nanashima4268/otr-4ts3-u1/hw/README.md

# hw

KiCad project for the OTR-4TS3-U1 board (4-layer, JLC04161H-7628 stackup). License: CERN-OHL-S-2.0 (see ../LICENSES).
See ../docs/architecture.md.

## Generated design (D-51)

The schematic is generated, not drawn: `hw/gen/design.py` describes the circuit in Python, and `hw/gen/schgen.py` writes `hw/kicad/*.kicad_sch`. Every pin connects through a global label at its end point, so the netlist is exactly the description.

```sh
python3 hw/gen/symbols.py   # project symbols -> hw/lib/otr.kicad_sym (FX3 from the datasheet ball map)
python3 hw/gen/design.py    # schematic + verification
```

Verification:
- The netlist that KiCad exports (`kicad-cli sch export netlist`) must equal the description.
- Every pin of every symbol must be assigned (`NC` for unused pins).
- Pins that the library draws stacked must share a net.
- Library no-connect pins must be `NC`.
- ERC runs (`kicad-cli sch erc`).

Phase 1 covers everything except the Sony receiver core. The receiver core waits for the reference-board measurement and the photo survey, because the CXD2856ER/CXD2858ER pinouts are not public.

Status (2026-11-01):
- Sheets done:
  - FX3
  - FPGA (also generates `fpga/syn/otr_top.pcf`)
  - Power: PCIe/DC 12 V OR, TPS54302 3.3 V, LDOs, `+VIO_TS` selection
  - USB: Type-C via HD3SS3220, or the internal header
  - Control: TCA9546A, LNA bypass inverter
  - RF front end: F jacks, LNA with bypass, 4-way splitters
- The netlist equals the description, and ERC reports 0 errors.
- The 32 remaining ERC warnings are labels for the receiver interface: TS*, RF_T*/RF_S*, CH*_PWR_EN/RST_N. They wait for the receiver sheet (Sony parts, after the measurement).
- Project symbols and footprints are generated by `hw/gen/symbols.py`:
  - CYUSB3014 from the ball map
  - HD3SS3220
  - The DS803FPR0016 F-jack footprint from the maker's recommended layout
