nanashima4268/otr-4ts3-u1/docs/decisions.md

# 決定事項ログ

初期ヒアリング（2026-11-01）で確定した方針。変更時はこのファイルに追記し、理由を残す。

| # | 項目 | 決定 | 備考 |
|---|---|---|---|
| D-01 | 目的 | 自分用の録画環境が主。頒布・販売にも耐える設計にする | 線引きは research.md §9 |
| D-02 | BS4K の目標 | ISDB-S3 の復調と TLV 出力まで。ACAS による復号は対象外 | |
| D-03 | 設計者の経験 | RF・高速回路はほぼ初めて | 設計の余裕と、デバッグしやすさを優先する |
| D-04 | 復調・チューナー IC | Sony 製をブローカーから調達（CXD2856ER / CXD2858ER） | 偽物や再刻印品を前提に、受入検査をする |
| D-05 | S3 用チップ | v1 では調達しない。ジャンクの 4K 機器から取り外して入手する | CXD2856ER と CXD2857ER の載せ替えを前提に基板パターンを作る（ピン互換は未検証） |
| D-06 | 系統数 | 4 系統。最初から 4 系統の基板を作る | 1 系統の評価基板は作らない。代わりに系統ごとに切り離せる設計にする（R-03） |
| D-07 | ホスト接続 | **改訂（2026-11-01）**：iCE40HX4K-TQ144 ＋ FX3（CYUSB3014）。当初は iCE40HX8K（TQ144）＋ FT601 だった | 改訂の理由は 3 つ。HX8K には TQ144 版がない（HX4K-TQ144 の中身は HX8K と同じダイ）。FT601 はドライバのソースが非公開で、GPL での公開（D-19）と衝突する。BGA は JLCPCB の実装で問題にならない |
| D-08 | 形状と電源 | PCIe ロープロファイル形状と外付け箱の両方に対応 | PCIe は電源だけを使う（補助電源なし、10W 以内）。箱では基板上の DC 入力端子に 12V を入れる（D-30） |
| D-09 | USB コネクタ | ブラケット側の USB-C とマザーボード内部の USB3 ヘッダの両方。どちらか一方を実装する | SuperSpeed 線は分岐させず、0Ω 抵抗で選ぶ |
| D-10 | ソフトウェア | **改訂（2026-11-01）**：Linux、Windows、macOS。Linux を先に作る。実装の土台は D-40 | libusb 系のユーザー空間ドライバ。recpt1 互換、その後 BonDriver。FX3 と libusb の構成なので macOS にも対応できる |
| D-11 | 実装 | JLCPCB の部品実装サービスを使い、Sony IC は支給または後付け | |
| D-12 | 予算と測定 | 5 万円程度。測定器は SDR（RTL-SDR）で代用 | 復調 IC が出す C/N・BER・信号強度も測定に使う |
| D-13 | B-CAS カードリーダー | 基板パターンだけ用意し、部品は実装しない | 復号機能は基板にもドライバにも持たせない |
| D-14 | アンテナ入力 | 地上用と衛星用の 2 端子（F 型） | |
| D-15 | アンテナ給電（**D-54 で改訂：v1 では外す**） | LNB への 15V 給電回路はパターンだけ用意し、部品は実装しない | |
| D-16 | 受信帯域 | 地デジ、BS/110 度 CS（右旋）、CATV（パススルーと ISDB-C）。左旋は RF 経路だけ確保 | |
| D-17 | LNA（受信アンプ） | バイパスできる LNA を載せる | |
| D-18 | CAD | KiCad を使い、JLCPCB 向けプラグインで出力する | |
| D-19 | 公開 | オープンハードウェアとして公開。基板は CERN-OHL-S-2.0、ホスト側と FPGA は GPL-2.0-only、FX3 ファームは MIT（D-29） | px4_drv と tbs6812_drv が GPL-2.0-only なのに合わせる |
| D-20 | 品番 | OTR-4TS3-U1 | Open Tuner Receiver／4 系統／地上・衛星（S3 対応）／USB／第 1 版 |
| D-21 | Sony IC の調達 | 少量をブローカーから買い、検収してから追加購入する | 検収では I²C でチップ ID を読み、参照ボードと同じように動くかを確かめる |
| D-22 | 実測の道具 | テスターと接写撮影 | 手順は measurement-procedure.md |
| D-23 | 設計前の準備 | ブロック図と電力見積もり、実測手順書、部品候補表、先行検証計画を作る | architecture.md ／ measurement-procedure.md ／ bom-candidates.md ／ preverification-plan.md |
| D-24 | I²C の構成 | FX3 の I²C から TCA9546A で 4 本に分け、復調 IC はすべて 0x64 にする | アドレス設定のミスをなくし、系統ごとに切り離せるようにする（D-06 への対策） |
| D-25 | FPGA の設定 | FX3 が起動時に SPI で FPGA に設定データを書き込む。フラッシュはパターンのみ | 開発中の書き換えが速い |
| D-26 | RF 前段 | SGL0622Z（LNA）、AS179 によるバイパス、抵抗による 4 分配。地上用と衛星用で 1 組ずつ | 直流から 3.2GHz まで平坦で、特殊な部品がいらない |
| D-27 | 検証用の PC | PCIe スロット付きの Linux 機と Windows 機の両方がある | 段階 S0（参照ボードで基準データを取る）は Linux から始める |
| D-28 | 購入 | 今買うのは PCIe 延長ライザー（約 1,000 円）だけ。評価ボードと Sony IC のサンプルは保留 | 段階 S1・S3・S4 は評価ボードを買うまで保留。R-11 を参照 |
| D-29 | FX3 ファームのライセンス | ソースを MIT で公開する。バイナリは各自が FX3 SDK でビルドするか、Cypress の規約に従って配る | SDK のライブラリはソース非公開で、バイナリ配布に Cypress の利用規約がかかるため、GPL にできない |
| D-30 | PCIe での電源とブラケット | PCIe で使うときは LNB 給電をせず、補助電源もつけない（10W 以内）。ブラケットには F 型 ×2 と USB-C を並べる。DC 入力は基板上の端子にし、箱で使うときだけ使う | LNB 給電の回路（DNP）は箱で使うときだけ有効にする。ファームは DC 入力を検出できないときに LNB を有効にしない |
| D-31 | USB の VID/PID | 開発中は pid.codes のテスト用 ID（1209:0001）を使う。公開リポジトリができたら正式な PID を申請する | |
| D-32 | 公開 | GitHub の nanashima4268/otr-4ts3-u1 で今すぐ公開する。コミットのメールアドレスは GitHub の noreply にする | |
| D-33 | 開発環境 | Mac に oss-cad-suite（FPGA ツール）、cocotb、KiCad を入れる。FX3 は Docker でビルドする（SDK は Infineon から手動で取得） | 状況（2026-11-01）：oss-cad-suite と cocotb は導入済み。Docker イメージ otr-fx3 は作成済み。KiCad は sudo が必要なので未導入。FX3 SDK は未取得 |
| D-34 | TS 配線 | v1 は CXD2856ER のシリアル TS（4 本）だけを FPGA に配線する | パラレルと 2 ビットパラレルのピンは、参照ボードで使われていないので導通測定で特定できない。S3（TLV）の高いレートを扱う方法は v2 で検討する |
| D-35 | 実測の段取り | 本番の pve-old を近いうちに止め、録画用のカードそのものを実測する | 止めるとホームラボ全体が止まり、SMART が FAILED の NVMe で再起動に失敗する恐れがある。このリスクは承知のうえで決めた。段取りは measurement-procedure.md §0-1 |
| D-36 | S0 の実施 | 2026-11-01 に完了した（docs/reference/s0-baseline.md） | 未復号の TS はチューナー #4 で recisdb を直接実行して取った。ファイルはローカルの ~/otr-data のみに置く |
| D-37 | FX3 ファームの作り方 | SDK のサンプルはコピーしない。起動コードと cyfxtx.c はビルド時に SDK から参照する。GPIF の設定は自前の GPIF II Designer プロジェクト（Windows 機で作る）から生成したものだけをコミットする | SDK のサンプルにも Cypress の「UNPUBLISHED, LICENSED SOFTWARE」表示がある。bladeRF（MIT）と同じやり方にする |
| D-38 | FPGA の出力形式とクロック | 1 パケット（188 バイト）ずつ丸ごと転送する。px4_drv と同じく、sync バイトを系統番号入りのタグ（0x17〜0x47）に書き換える。システムクロックは 85MHz 以下（GPIF は 16 ビット・50MHz 程度で足りる） | S2 で検証済み（fpga/README.md） |
| D-39 | GPIF のバス幅とクロック | GPIF は 16 ビット幅にする。FPGA と GPIF のクロック（PCLK）は、基板上の 50MHz 発振器から取る（16 ビット×50MHz＝100MB/s） | 32 ビット幅にすると FX3 の SPI ブロックが使えなくなり（FX3 Programmer's Manual 7.3.4.3）、D-25 の FPGA 書き込みとぶつかる。必要な帯域は最大約 50MB/s（S3×4）なので、16 ビットで足りる |
| D-40 | ホスト側の実装 | **改訂（D-44）**：px4-userland（Khronos31、C++、GPLv2）の兄弟製品として作る。D-10 で決めた「Rust」は取り消す | px4-userland は、ユーザー空間で動く常駐プロセス（px4d）とクライアント（px4-ts、px4ctl）の構成で、CXD2856ER と CXD2858ER の制御がすでにある。4 つの OS で動く。カーネルドライバは不要 |
| D-41 | GPIF II Designer | ユーザーが Windows 機で操作する。私は画面ごとの手順書を用意する | |
| D-42 | px4-userland の実機確認 | 2026-11-01 に DTV02A-4TS-P で実施し、成功した（docs/reference/px4-userland-dtv02a-4ts-p.md） | |
| D-43 | FX3 への書き込みの流量制御 | FPGA がワード数を数え、DMA バッファ 1 つ分（8192 ワード＝16KiB）をちょうど満杯まで書く。書き終えたらフラグの遅延分だけ待ち、FLAGA で次のバッファが空いたのを確かめて再開する。FLAGB（部分フラグ）と PKTEND# は使わない | FX3 は満杯のバッファしか USB に送らない。部分フラグで止めると満杯にならず、行き詰まることをシミュレーションで確認した（fpga/README.md） |
| D-44 | ホスト側の製品の形 | 兄弟製品 otr-userland を別リポジトリ（github.com/nanashima4268/otr-userland）として作る。dtv-userland-core と px4-userland は版を固定して参照し、CXD 系の制御コードとタグ付き TS の振り分けを流用する。otr-ts は共通の `*-ts` CLI 仕様に合わせる | px4-userland は仕様で対応機種以外の実装を入れないと定めているので、本体には足せない。siano-userland と同じ作り方にする。設計は otr-userland/docs/design.md |
| D-45 | 上流の作者への連絡 | 実機（v1 基板）が動いてから連絡する | それまでは版を固定して参照するだけにする |
| D-46 | FX3 ファームの起動方法（**D-49 で改訂**） | ふだんは基板上の I²C EEPROM（24LC256）から起動する。開発中や最初の書き込みでは USB 起動も使う。otrctl に、ファームを RAM に送る機能（0xA0）と EEPROM に書き込む機能を持たせる | 一度書き込めば、挿すだけで自分たちの ID（1209:0001）で認識される。ファームのバイナリは各自がビルドする（D-29） |
| D-47 | FPGA の制御レジスタ | FX3 の SPI（設定と同じ 4 本のピン）で読み書きする。1 回の転送は「命令 1 バイト＋データ 4 バイト（上位から）」、命令はアドレス（書き込み）か 0x80｜アドレス（読み出し）。設定は 20MHz、レジスタは 4MHz で行う。FPGA は SCK を 50MHz のシステムクロックでサンプリングする。系統はリセット後すべて無効で、ホストが CH_ENABLE で有効にする | レジスタの読み書きは稀なので速さはいらない。サンプリング方式なら SCK をクロックとして使わずに済み、クロック領域が増えない。シミュレーションで 8.3MHz まで動作を確認（fpga/README.md）。レジスタ表は otr-userland docs/design.md §5 |
| D-48 | GPIF II の設定の取り込み | ユーザーが作った GPIF II Designer プロジェクト（Cypress の雛形 sync_slave_fifo_2bit を複製し、FLAGA を thread 0 DMA ready に変更）から生成したヘッダを、ファームで使う。公開リポジトリの fx3/gpif/ には、ヘッダとプロジェクト本体（.cyfx、projectfiles/*.xml）を入れる。documentation/（Cypress が書いた資料）と build.log（個人のパスを含む）は入れない | 状態遷移は SDK の 16 ビット例と同じで、違うのはフラグのピン設定だけ（fx3/gpif/README.md）。プロジェクトがあれば GPIF II Designer でヘッダを作り直せる（bladeRF と同じ扱い）。ファームはこのヘッダでビルドできることを確認済み |
| D-49 | 起動用メモリ | I²C EEPROM（D-46）をやめ、SPI フラッシュ W25Q32JV（4MB、JLC C179173、拡張部品。C82344 は在庫切れ）から起動する。PMODE は「SPI、失敗したら USB 起動」。フラッシュは FX3 の SSN、FPGA の SS_B は別の GPIO（暫定で 50）につなぐ。CRESET_B はプルダウンし、FPGA の MISO は自分の SS が Low のときだけ出力する。配置は 0x000000 が FX3 イメージ、0x100000 が FPGA 領域（256 バイトのヘッダ「OTRB」＋長さ、続けてビットストリーム）。FX3 は起動時にビットストリームを RAM に読み、途切れなく FPGA に書き込む（ホストからの FPGA_LOAD も残す）。シリアル番号は、フラッシュの 64 ビット固有 ID にする。ベンダーリクエストの 0xB7/0xB8 はフラッシュの書き込みと読み出しに変え、0xB9（消去）と 0xBA（状態）を加える | ファームは最適化しても 114KB あり、24LC256（32KB）に入らない。フラッシュなら容量に余裕があり、FPGA の自動起動と固有 ID によるシリアル番号も同時にまかなえる（bladeRF と同じ構成）。FX3 の SPI 起動は 03h 読み出しと 3 バイトのアドレスを使い、32Mbit は対応範囲に入る。iCE40 は設定データを途中で止めずに送る必要があり、バスを共有しているので、いったん RAM に読む。HX8K のビットストリーム（135KB）は DMA バッファ領域（224KB）に入り、USB を始める前に読んで解放する。ユーザーが 2026-11-01 に選んだ |
| D-50 | ストリームの停止と再開 | PKTEND は使わない。FPGA に経路リセット（CTRL 0x0A の bit0）を設ける。otrd は、開始時に「経路リセット → STREAM 1 → CH_ENABLE」、停止時に「CH_ENABLE=0 → STREAM 0」の順で操作する。無効になった系統の残りのパケットは、mux が読み出して捨てる | 停止すると FX3 は書きかけのバッファを捨てるが、FPGA は書いたワード数を数え続けるので、再開後にバッファの区切りがずれる（シミュレーションで、ずれと 83 回の取りこぼしを再現した）。PKTEND で書きかけのバッファを確定させる方法は、FX3 の挙動が TRM だけでは確定できず、FPGA も複雑になるので見送った。代わりに、最後の受信機が止まるときの末尾（16KiB 未満、数 ms）は届かない。fpga/sim/tb_path.v で確認済み |
| D-51 | 回路図と配置配線の分担 | 回路図、配置、配線とも私（Claude）が行う。回路図は KiCad のファイルをスクリプトで作り、配置もスクリプトで行う。配線は自動配線（Freerouting）と手直し。ユーザーは節目ごと（配置後・配線後・発注前）に KiCad で開いて確認する | 推奨は「配置配線はユーザー」だったが、ユーザーの判断で変えた。RF と USB3 の品質は保証できないので、私は画像の書き出し（kicad-cli）と DRC で自己検証し、ユーザーの目視確認を節目に入れる（2026-11-01） |
| D-52 | 基板の大きさと実装面 | ロープロファイル（高さ 68.9mm 以下）、長さは 120mm を目標とする。収まらないときや配線の品質が落ちるときは、相談のうえ最大 168mm まで延ばす。部品は表面だけに載せ、収まらなければ相談する | 長さは好みで、ケースの制限ではない（2026-11-01） |
| D-53 | 層数 | 4 層（JLC04161H-7628）。FX3 の BGA はドッグボーン（パッドの斜め脇にビアを置く方式）で引き出す | 推奨どおり（2026-11-01）。D-75 で 6 層に改めた |
| D-54 | 部品を載せないパターンの整理 | 残すのは、内部 USB3 ヘッダ（D-09）、B-CAS スロット（D-13、DNP）、DC 入力端子（D-30）。LNB 給電回路（D-15）と FPGA 専用フラッシュのパターン（D-49 で不要）は v1 から外す | 120mm に収めるため（2026-11-01） |
| D-55 | FPGA の在庫 | 先行購入せず、発注時に確保する。在庫切れの危険（R-10）は受け入れる | 2026-11-01 |
| D-56 | USB-C の SuperSpeed の向き | HD3SS3220（UFP 設定、GPIO モード）で、向きの判定と USB3 レーンの切り替えをする。TX の結合コンデンサはスイッチとコネクタの間に置く（TI の UFP 例に従う）。コネクタは Molex 105450-0101（USB 3.2、24 ピン、JLC C134092）。内部 USB3 ヘッダは、FX3 側の 0Ω で選ぶ（既定は USB-C、ヘッダは DNP） | FX3 は SuperSpeed を 1 組しか持たず、そのままでは片方の向きでしか USB3 にならない。USB3 の Micro-B と Type-B は JLC に在庫がない。推奨どおり（2026-11-01） |
| D-57 | F 型コネクタ | DOSIN DS803FPR0016（75Ω、DC〜3GHz、直角、THT、JLC C2979612）。フットプリントは、メーカーの推奨ランドから生成器で作る | 3GHz 定格は左旋の上端（3.224GHz）をわずかに下回るが、左旋は経路の確保だけ（D-16）。ブラケットとの位置は、配置後の確認（D-51）で見る（R-09 を一部解消） |
| D-58 | 電源の構成 | PCIe の 12V と DC 入力を SS34 で OR し、TPS54302（3A）で +3V3 を作る（100k/22k で 3.31V、6.8µH）。スロットの 3.3V で +3V3 をまかなう経路も DNP で残す。LDO は +1V2（FX3）、+1V2_FPGA、+1V8 の 3 個（TLV755xx）。+VIO_TS は 3.3V（1.8V は 0Ω で選べる）。受信部の電源は、実測後に受信部のシートで決める | 3A あれば、Sony IC を 3.3V から LDO で給電しても足りる見込み（電力の見積もりは実測で更新する） |
| D-59 | RF 前段の部品 | LNA は SGL0622Z。バイパスは HXAS179-92LF（AS179 の互換品。元の品は在庫なし）を 2 個と 74LVC1G04 で行い、LNA_BYPASS が 0 のとき LNA を通す。チョークは、地上が 1µH＋フェライトビーズ、衛星が 12nH＋フェライトビーズ（データシートの 68nH は 850MHz 用で、帯域に足りない）。DC カットは地上 1nF・衛星 100pF。分配は 45.3Ω の星形 4 分配 | 定数は、実機で通過特性を見て調整する前提 |
| D-60 | GPIF のクロック | 50MHz 発振器 1 個で、FPGA（GBIN）と FX3 の PCLK を、それぞれ直列抵抗を通して駆動する。FPGA はクロックを転送しない | FPGA の最上位にクロック出力がなかった。転送するとスキューの管理が要る。1 個の発振器で配るほうが単純 |
| D-61 | ブラケット | 市販の無地のロープロファイル用ブラケットを買い、ユーザーが穴を開ける。穴の位置の図は私が作る | 推奨は板金の外注だった。USB-C の角穴の加工が難しいことは承知のうえ（2026-11-01） |
| D-62 | ブラケットの端子の並び | マザーボードから遠い側から、衛星（ANT-S）、地上（ANT-T）、USB-C。端子はすべて部品面（PCIe の B 列の面）に載せる | F 型の順は参照ボードと同じ。USB-C を端子側に置き、FX3 までを短くする（2026-11-01） |
| D-63 | B-CAS スロット（D-13 の具体化） | フルサイズのカード用のパターンを裏面に置く（DNP）。部品は v1 では選ばず、外形だけ確保する | 組み立てる部品は表面だけなので、JLC は片面（Economic）のままで費用は増えない。カードを差すと PCIe 規格の裏面の高さ（2.67mm）を超える（参照ボードも同じ）。両面に部品を組み立てると、1 回の発注で約 $45 増える（2026-11-01） |
| D-64 | 外形の寸法 | PCIe CEM のロープロファイル。基準は、CEM 仕様から作られ製造実績のある KiCad の雛形（ULX4M-PCIe-IO）：端子の下端から上辺まで 68.9mm、肩 12.75mm、ブラケット側の端は B1 の端子から 45.15mm、ねじ穴 2 つ（GND、M3）。配置と外形は hw/gen/layout.py と pcbgen.py から生成する | 肩の高さは資料により 8.4〜12.75mm と幅があるので、安全側を取る。参照ボードの実測（measurement-procedure.md §2-5）で見直す |
| D-65 | 外部チューナーへの RF 出力（research.md §6） | 作らない | 面積を優先する。RF 前段の切り分けは、LNA のバイパスと系統ごとの切り離しで行う。推奨は U.FL（DNP）だった（2026-11-02） |
| D-66 | シールド（R-08） | 受信部の周りに、レジストを剥いた GND の帯とビアの壁だけを用意する。部品は載せない | 必要になったら、自作のケースや銅テープをはんだ付けできる。受信部を描くときに入れる（2026-11-02） |
| D-67 | 立ち上げ用の観測点（R-11） | FX3 と FPGA の間（PCLK、SLCS#、SLWR#、FLAGA、FLAGB、DQ0）と FPGA の設定状態（CDONE、CRESET_B）にテストパッド、プローブ用の GND パッド 2 個。TCA9546A の上流に I²C ヘッダ J7（DNP） | 評価ボードを買わないので、v1 基板で初めて FX3 と FPGA を動かす。I²C ヘッダは受け入れ検査（D-21）でチップ ID を読むのにも使う。既存の部品番号を動かさないよう、全シートの後に追加している（design.py の bringup_additions） |
| D-68 | CLAUDE.md | リポジトリの追跡から外し、手元にだけ置く。hw/view/（ビューアの生成）はリポジトリに残す | 個人のアーティファクトの URL を含むため（2026-11-02）。ローカルの Tailscale 向けビューアは ~/otr-data/work/scripts/localview.sh で作る |
| D-69 | 配線の寸法とルール | 表層（第 2 層の GND が基準）で、RF 75Ω は線幅 0.145mm、USB の差動 90Ω は線幅 0.263mm・間隔 0.15mm。電源は 0.5mm、それ以外は 0.15mm／0.15mm。ビアは 0.45mm／穴 0.25mm（JLC で追加料金のかからない最小）。JLC の製造限界を設計ルールにし、ネットクラスと合わせて hw/gen/rules.py から生成する | 寸法は、JLC04161H-7628 の断面（プリプレグ 0.2104mm・εr 4.4、銅箔 35µm、ソルダーレジスト εr 3.8）を 2 次元の電界計算で解いた値。検算として 50Ω は 0.355mm になり、銅厚とレジストを入れない近似式（0.405mm）より細くなる向きと合う。RF の線は、地のパターンをカスタムルールで 0.45mm 離してマイクロストリップとして扱う（2026-11-02） |
| D-70 | USB の高速線の配線 | USB-C の奥の列（B 列）は、2 列のすき間に細いビア（直径 0.3mm・穴 0.15mm、JLC の追加料金あり、約 $16／発注の記載だが見積もりで確定）で裏面へ下ろす。上の層に TX1・RX2、裏面に RX1・TX2 を通し、ホスト側は TX を上、RX を裏面にして交差を避ける。TX1 は受け口で + と − を入れ替える（USB 3 の受信側は極性の反転を自動で直すことが規格で必須）。D+/D− は入れ替えず、ブラケット脇を回して FX3 へ引く（A7 と B7 の接続だけ In2 の短い配線）。ヘッダ用の 0Ω（DNP）は、使う側の 0Ω と FX3 側のパッドを共有させて重ね、分岐を 0 にする。対内の長さの差は、RX1 に蛇行を入れて 0.1mm 以内（ホスト側 RX だけ合計約 1mm）。切り替え IC（HD3SS3220）は 180° 回した | Molex の部品指定で、受け口の前面は上の層に配線もビアも置けない。2 列の間は 0.6mm しかなく、無料の寸法のビアは入らない。ユーザーが細いビアを選んだ（2026-11-02）。TI の配線指針（SLLSES1E §9）に従う。usb.py に座標で記述し、DRC で確かめている |
| D-71 | FX3 の BGA の引き出しと電源層 | FX3 は、ボールの斜め脇に無料の寸法のビア（0.45mm／0.25mm）を置き、中心から外向きに引き出す。外周の信号ボールは上の層からそのまま出す。+1V2 のボールのビアは内向きにする。水晶は、XTALOUT をビアなしで上の層に通し、XTALIN だけビア 2 個で裏面を通す（Y1 は 180° で固定）。層は、In1 を全面 GND にし、SuperSpeed の AC 結合コンデンサの直下だけ抜く。In2 は GND を土台にして、FX3〜FPGA と制御部を +3V3、FX3 の BGA の下を +1V2 の島、FPGA の本体の下を +1V2_FPGA の島にする。USB の裏面の配線の下（x < 82.6mm）、RF、電源部、受信部の帯は GND のまま残す。BGA の下に限って、面とビアのクリアランスを 0.12mm、+1V2 の島の最小幅を 0.1mm にし、ビアの間にも銅が残るようにする。1.2V の LDO（U5、U6）は、入出力のコンデンサごと負荷の隣に移す。面につなぐ部品のパッドには、その面がある位置に限って脇にビアを置く。露出パッドには中にビアを置く。fanout.py と planes.py で生成し、面は kicad-cli で塗る | Cypress AN70707 §12.1 に従う：電源の種類ごとに電源層を区切る、USB の線の下の GND を切らない、AC 結合コンデンサの直下は 1 層抜く、電源の線を短くする、水晶の線にはビアを推奨しない。XTALIN と XTALOUT を両方ビアなしで北へ出すと、列 C の両脇の通り道がふさがり、C8（R_USB2）と C10 が引き出せなくなるので、片方だけビアを使う（追加の容量は 1pF 程度で、負荷容量より十分小さい）。LDO は電源部に置くと負荷まで約 45mm あり、In2 の 1.2V の通り道が互いに交差する。DRC でクリアランス違反なし（2026-11-02） |
| D-72 | 製造データと JLC の条件（B-7） | 製造データは hw/gen/fab.py で出す：ガーバー（Protel の拡張子、シルクからレジストを抜く）、Excellon（mm、絶対座標）、BOM（Comment／Designator／Footprint／LCSC Part #）、CPL（Designator／Mid X／Mid Y／Layer／Rotation）。出力先は ~/otr-data/work/fab/<コミット>/。テストパッド、ねじ穴、はんだジャンパー、PCIe の端子は部品ではないので外す。基板は ENIG（1U"）、PCIe の端子は金、30° の面取り、積層は JLC04161H-7628 を指定、ビアは JLC の 4 層の既定どおり穴を埋める（Plugged、Tented は選べない）。標準のビアは穴 0.3mm／直径 0.45mm にする（D-69 の 0.25mm は誤りで、追加料金の区分だった） | 2026-11-02 に JLC の見積もり画面で確認（基板 5 枚、ログインなし）。基準の額は $47.60（エンジニアリング料 $25、ENIG $17.50、基板 $5.10）。金の端子・面取り・積層の指定・穴埋めは $0。ビアの穴を 0.25／0.2mm にすると約 +$38、0.15mm（D-70 の細いビア）にすると約 +$56（ビア $35.13、自動で付く 4 線式の導通検査 $17.09、TG155 の基材 $3.51）。面取りは深さ 1.13mm で、端子は先端から 1.3mm 以上離れている。組み立てを付けると Standard に固定され、捨て板 5mm が両端に付く。ユーザーの選択：ENIG＋金の端子＋30°、穴埋め、見積もりは私が Chrome で、基板 5 枚・組み立て 2 枚 |
| D-73 | USB-C の部品（D-56・D-70 の改訂） | Molex 105450-0101 をやめ、Same Sky UJ32-C-H-G-H2-SMT-TR（USB 3.2 Gen 2x2、JLC C22359755、拡張部品、約 $2.94）にする。A 列は表面実装で奥、B 列は挿入実装で手前に 2 段の千鳥（後ろの段は 0.70mm 奥）。フットプリントはデータシート（2023-11-13、1.6mm 基板用）の推奨パターンから生成し（symbols.py）、B 列の穴にもペーストを置く（ピンを差してリフロー）。前面は手前の段から 7.75mm 前で、カードの端から 0.8mm 出す（ブラケットの内面は 1.03mm）。A 列の TX1・RX2 は上の層、B 列の RX1・TX2 は穴から裏面へ出て後ろの段のすき間を通し、切り替え IC の近くで無料の寸法のビアで上がる。細いビア（0.15mm）はなくなった。TX2 も受け口で + と − を入れ替える。D+/D− は A6–B6 を上の層、A7–B7 を裏面で結ぶ。対内の長さの差は TX2 0.11mm、RX1 0.25mm、D± 0.07mm | 細いビアは JLC の見積もりで約 $56／回（D-72）。この部品は 1.6mm 基板を明記した数少ない挿入実装の USB-C で、JLC に在庫がある（2026-11-02 に 250）。B 列の穴はメーカーのパターンで、穴の間が 0.40mm（ルールは 0.45mm）なので J3 だけ例外にし、発注のときに JLC に確かめる。挿入ピンの分岐は 19〜23GHz で共振する見積もりで、Gen 1（2.5GHz）には影響しない。候補の比較は ~/otr-data/work/docs/usbc-dip-candidates.md。ユーザーが 2026-11-02 に選んだ |
| D-74 | 一般配線（Freerouting） | 受信部以外の一般の信号線と電源の線は Freerouting 2.5.0 で自動配線する（hw/gen/autoroute.py）。jar はリポジトリに入れず ~/otr-data/work/tools/ に置き、利用統計は -da で止める。流れは、pcbgen の基板（USB・BGA の引き出し・面のビアはスクリプトで固定）を DSN に書き出し、DSN を直して Freerouting に渡し、結果の SES を hw/kicad/otr-4ts3-u1.ses としてコミットする。pcbgen は SES のうち既存の線と重ならず、配線対象の網（.routed）の線だけを足す（KiCad の SES 読み込みは既存の線を全部消すので使わない）。DSN の直し：信号は表と裏だけ（In1・In2 は面のまま）。面の定義を外し、面の網（GND・+3V3・+1V2・+1V2_FPGA）は配線しない。RF（75Ω）と USB（90Ω の差動）も配線しない。信号線は幅 0.1mm・間隔 0.1mm（BGA の引き出しのビアのすき間は 0.35mm で、0.15mm の線は通れない）、電源線は 0.3mm。KiCad のネットクラス（Default・GPIF・POWER）も同じ値にした。ビアは配線ツールには直径 0.55mm として見せ、穴から銅まで 0.2mm を保つ（BGA の下の引き出しのビアは実寸）。受信部の帯は配線禁止、カードの端から 0.3mm、USB-C の位置決め穴から 0.2mm を空ける。細くされた線は 0.09mm（JLC の最小）まで太らせる | ユーザーの判断で「今、受信部以外を配線する（推奨）」、jar の導入も了承（2026-11-02）。BGA の下だけは穴から線まで 0.17mm を許す（中央を通る 0.1mm の線でちょうど 0.2mm、配線ツールは最大 0.025mm ずれる）。発注時に JLC の DFM で確かめる。未配線は、BGA の内側から出る GPIF など約 25 本と、面の網の未接続（面の島の外の部品、ビアの置き場がないパッド）、RF、USB ヘッダの線。受信部の回路が入ったら配線し直す（2026-11-02） |
| D-75 | 6 層にする（D-53 の改訂）と FX3 の BGA の引き出し | 積層は JLC06161H-7628（1.6mm）。層の役割は、L1 信号／L2（In1）GND／L3（In2）内側の信号／L4（In3）電源（GND を地にして +3V3・+1V2・+1V2_FPGA の島）／L5（In4）GND／L6 信号。FX3 の信号ボールは、配線ツールに任せる前にスクリプトで BGA の外まで引き出す（hw/gen/escape.py）。外周のボールは表から、内側のボールはドッグボーンのビアから裏または L3 へ出す。0.05mm の格子の上で最短の道を探し、端から行き先の部品までの直線距離も費用に入れる。引き出しの線どうしの取り合いは、混んだ所の費用を上げながら引き直す方法（PathFinder）で解く。55 本すべてが出た。Freerouting は信号を表・L3・裏の 3 層に引く（L2・L4・L5 は面のまま） | 4 層では、BGA の内側の信号ボール約 10 個を引き出せなかった。無料の 0.45mm ビアを 0.8mm 間隔で並べると、ビアの間には 0.1mm の線が 1 本しか通らない。1 層で出せるのは外側の 2 周ほどだが、FX3 の信号ボールは 4 周目まである。裏面だけで順に引くと 45〜46 本、取り合いの方法でも 41 本までしか出ず、L3 に相当する電源の層を使っても 8 個残った。JLC の見積もり（基板 5 枚、ENIG、金の端子、30° の面取り、2026-11-04）は、4 層 $47.60、6 層 $55.90（+$8.30）、4 層で 0.15mm の細いビアは約 +$56。ユーザーが「6 層にする（推奨）」を選び、積層は信号への影響など電気的な事情を調べたうえで私が決めることになった。積層を選んだ理由：JLC の 1.6mm・6 層の積層 17 種類のうち、外側の層と隣の層の間が 7628 の 0.2104mm（4 層の JLC04161H-7628 と同じ）なのは JLC06161H-7628 だけで、D-69 の線の寸法（RF 75Ω 0.145mm、USB 90Ω 0.263／0.15mm）がそのまま使える。ほかの積層は外側が 0.076〜0.13mm と薄く、75Ω の線が細くなりすぎるか、0.29〜0.51mm と厚く、0.4mm 間隔の USB-C や切り替え IC のパッドに線が乗らない。層の並び：表は L2 の GND、裏は L5 の GND を基準にするので、裏面を通る USB の線の上も GND が続く。L3 の上は L2 の GND（0.4mm）、下は L4（0.2028mm）で、L4 は電源の島以外を GND にしたので、L3 の線もほぼ GND に挟まれる。信号の層を 2 枚並べる案（信号/GND/信号/信号/GND/信号）では、L3 と L4 が 0.2mm で向き合って線どうしが強く結合し、電源も配りにくい。4 層の D-69・D-71 から変えた点：L3 は面を流さない。USB の AC 結合コンデンサの下は、L2 の切り欠きに加えて L3 も配線禁止にする（コンデンサから見えるのは L4 の GND）。結果（D-76 の並べ替えのあと）：信号の未配線は約 25 本から 4 本（FX3_TMS、GPIF_DQ10、GPIF_DQ11、SPI_SCK）と電源の +1V2_FX3U3 になり、DRC の違反はない。未解決：C16.1（BGA の北の 100nF）は、引き出しの線にビアの場所を取られて面につながらない。ほかのビアを置けないパッドと一緒に片付ける。JLC の 6 層の既定のビアの処理は Epoxy Filled & Capped（$0）で、パッドの中にビアを置く設計にもできる（今は使わない）。積層の値は https://jlcpcb.com/impedance の表（2026-11-04 に取得）による |
| D-76 | FPGA の GPIF のピンの並び（D-07 の改訂） | バンク 0 で使う 25 本のピンの組はそのままにして、割り当てだけを並べ替える。FX3 からの引き出しの線が箱を出る順（東の辺を南から北、次に北の辺を東から西）に、FPGA の上の辺のピンを西から東へ割り当て、バスが自分と交差しないようにする（hw/gen/design.py の FPGA_PINS、fpga/syn/otr_top.pcf はそこから生成）。割り当ての後に作り直しても引き出しの順は変わらなかった | 並べ替える前は、GPIF の束が FX3 と FPGA の間で交差し、Freerouting が 11 本を引けずに残した（6 層でも）。FPGA のピンは自由に選べるので、BGA 側の順に合わせるのが定石。GPIF の信号は FPGA 自身の 50MHz（GPIF の PCLK と同じ発振器、D-60）で扱うので、GBIN などの特別なピンは要らない。ピンの組を変えていないので、バンクの電圧（3.3V）も変わらない。iCE40 の配置配線ツールはこの Mac に入っていないので、PCF の確認は FPGA を組むときにする（2026-11-04） |
| D-77 | 自動配線の残りの仕上げ（hw/gen/finish.py） | Freerouting の後に、つながっていない所だけを迷路配線で仕上げる。(1) 信号：自動配線した網のうち、銅が 2 つ以上に分かれているものを、小さい塊から近い塊へ、表・In2・裏の 3 層と 0.45/0.3mm のビアでつなぐ（0.05mm の格子の A*、網のクラスの幅とクリアランス、受信部の帯・基板端・配線禁止域は避ける）。空きで通れないときは、他の信号の線をはがして通し、はがした網をつなぎ直す（引きはがし再配線、仕上げで引いた線ははがさない）。(2) 面：塗りつぶした後の基板で、面に届いていない電源・GND のピンから、面の中に立つビアか、つながっている銅まで引く（ビアは 0.25mm の格子、パッドの上には置かない、穴どうしは 0.25mm 空ける）。面の島どうし（+3V3 の FX3/FPGA 側と制御部側）も最寄りのパッドどうしでつなぐ。面のためにはがした信号がつなぎ直せないときは、その試みをまるごと元に戻す。その後もう一度塗りつぶす | 残りを Freerouting にもう一度走らせると、固定した配線を網の一部と見ずに悪化した（未配線 349）。自動配線の後の残りを、既存の銅を動かさない迷路配線と、局所的な引きはがし再配線で片付けるのは定石。面の網は Freerouting に引かせていない（D-74）ので、面に届かないピン（ビアの場所がないもの、カードエッジの指、USB-C の GND、面のない場所の部品）はこれまで誰も引いていなかった。結果：信号の未配線 0、面の未接続は FB2.1（+1V2）の 1 か所、DRC の違反なし、作り直しても同じファイル（2026-11-05）。障害物の格子は occ.py（整数の配列、図形を列ごとの区間で塗る）で作り、基板の生成は約 8 分から約 3.6 分になった（結果のファイルは同じ）。さらに、BGA の引き出し（escape.py）も同じ格子に載せ、図形ごとの升目を共通の格子で一度だけ求めて使い回し、基板の読み出しを 1 回の接続ごとに 1 度にし、探索の内側を詰め、部品配置の重なり判定を近くの障害物に絞って、約 2.5 分になった（結果のファイルは同じ、2026-11-06）。続いて次を加えた（2026-11-06）。(a) 面に届くビアがないピン（planes.py でパッドの脇にビアの場所がないもの、FX3 の電源ボールで引き出しのビアが自分の面の外に出たもの）は、Freerouting の前に、面の領域に立つビアか同じ網の他のパッドへ迷路配線でつなぐ。Freerouting はそれを避けて配線するので、後から囲まれて孤立することがない。(b) 塗りつぶし後の DRC で規則に反している Freerouting の配線（穴のクリアランスを知らないため）をはがし、仕上げでつなぎ直す。DRC が一度に全部を挙げないので、きれいになるまで最大 3 回繰り返す。(c) 行き先のない銅（ほかの経路で届いた BGA の引き出しの残り、使われないビア）を消す。ビアは触れている物が 1 つ以下のとき、線は浮いた端から、同じ網の銅が触れている最も遠い所まで切り詰める（線の途中に他の線が当たっていても切れない）。(d) 仕上げの試行回数の上限が、つながっている網の確認にも使われていて、名前順で後ろの網が調べられていなかった誤りを直した。(e) planes.py のビアどうしの穴の間隔（0.25mm）を確かめる。FB2 は、+1V2 のボールではなく、自分がつなぐ USB 3 の電源ボールの近くに置く（layout.TARGET_OVERRIDE）。東側に置かれていたときは +1V2 側が面へ出られなかった。はみ出したテストパッドは、隣の領域で 0.2mm 刻みに探す。結果：信号と面の未接続 0（未配線は手で引く RF と HDR の網だけ）、規則の違反なし、行き先のない銅はビア 2 個（線の端がビアの中心から外れていて、消すと切れる）。全部の網を確かめるようになって仕上げのつなぎが増え、生成は約 6 分（Freerouting は別に約 10 分） |
| D-78 | RF 前段の配置と 75Ω の配線（hw/gen/rf.py） | 受信部（4 系統）を除く RF 前段を、信号の流れに沿って表層に一列に並べ、75Ω の線（0.145mm、In1 の GND が基準）を手で決めた形で引く。並びは、F 型コネクタ → ESD（線の上にパッド、GND は真下）→ DC カット → 切り替え IC A →（上：素通しのコンデンサ／下：DC カット → LNA → DC カット）→ 切り替え IC B → DC カット → 45.3Ω → 星の結線 → 45.3Ω の腕 4 本。2 個の SOT-363 は向かい合わせる（A は 180°、B は 0°）。このとき A の J2 は上、J3 は下になり、B では J3 が上、J2 が下になる。そこで、B だけ LNA を J2 側、素通しを J3 側にし、B の制御ピン（4 と 6）を入れ替える（design.rf_path）。働きは前と同じで、LNA_BYPASS が 0 なら LNA を通る。LNA は RF の入出力が同じ辺にあるので、ピンを上に向けて線の下に置き、入出力の DC カットは縦に立てる。バイアスのチョークは LNA の出力の線に短い枝でつなぐ。星の結線は長さ 1.15mm の棒で、腕を上に 2 本・下に 2 本出す。GND：ESD と切り替え IC の GND ピンは、すぐ脇に専用のビアを置く。LNA の GND ピンは露出パッドにまっすぐつなぎ、露出パッドの中にビアを 2 個置く。S 系は ANT-S の高さでまっすぐ並べる。T 系は ANT-T から 5mm 上がって S 系と同じ列に並べ、星を受信部の帯の角に置く。分配器の出力（RF_S0〜3、RF_T0〜3）は、受信部のシートで引く。 | 仮配置（部品を領域に詰めただけ）では部品の順が信号の順と合わず、C71 から U14 へ行くにも混んだ所を回り込む必要があった。ユーザーが「配置を直してから配線（推奨）」を選んだ（2026-11-06）。RF の線は短く、曲がりは少なく、分岐の残りの線（スタブ）は作らないのが定石。同じ向きの SPDT を 2 個向かい合わせると、2 つの経路が必ず交差する。そのため片方の投入側を入れ替えるのが最も簡単だった。露出パッドの中のビアは、JLC の 6 層では既定で樹脂で埋めてふさぐので、はんだが吸われない（D-75）。星の棒の長さは、3.2GHz の基板上の波長（約 52mm）の 1/45 で、分配の偏りは無視できる。部品の下の GND（In1）は抜いていない。0402 のパッドは線より幅が広いので、わずかな不整合が残る。結果（2026-11-06）：Freerouting をやり直し（約 9 分）、信号と面の未接続 0（未配線は手で引く HDR の網だけ）、規則の違反なし、行き先のない銅なし、作り直しても同じファイル。あわせて仕上げ（D-77）を直した。(1) 仕上げの引きはがしで通れない網は、最後の手段として一度だけ、同じ回に仕上げで引いた線もはがしてよい（GPIF_DQ0 のつなぎが GPIF_DQ1 を閉じ込めた）。(2) 行き先のない線を切り詰めるとき、新しい端を触れている銅の位置ではなく線自身の上に置く（線が傾いて GND のビアに 0.09mm まで寄った）。新しい端が今の端と同じなら何もしない（同じ処理を際限なく繰り返した）。長さ 0 の線は消す。(3) 1 つの層の線だけが触れているビアは、中心から外れた線の端までその層で短い線を足してから消す。(4) 面のための引きはがしで、つなぎ直せなかった網があれば、元に戻してからその網をはがさずにもう一度探す（最大 3 回。C27.1 は GPIF_DQ14 の代わりに GPIF_DQ0 と GPIF_DQ3 をはがして通った）。 |
| D-79 | 内部 USB3 ヘッダ（J4、DNP）の 90Ω 差動（hw/gen/hdr.py） | FX3 の横のヘッダ側 0Ω（R31/R33、R35/R37、R39/R41）から J4 まで、3 組（DP/DM、SSTX、TX→結合コンデンサ→SSRX）を手で決めた形で引く。カードの下端に沿った裏面の帯（FX3 と FPGA の下、In4 の GND が基準）に、上から DP/DM、SSTX、TX の順に並べる（組の中 0.263/0.15mm、組どうし 1.35mm）。0Ω の脇で裏面に降り、TX、SSTX、DP/DM の順に左から帯へ降りるので、どこでも交差しない。DP/DM は USB-C 側の SSRX（裏面）と FX3 側の SSTX（表面）を越えるため、0Ω のパッドから In2 に降り、FX3 の下で裏面に出る（約 9mm の In2 は 90Ω より低いが、USB 2.0 なので許す）。J7（I2C ヘッダ）の手前で 45° に上がり、J4 のピン列の隙間に入る。J4 のパッドは直径 1.35mm で隙間は 0.65mm しかないので、遠い列（12、14、18 番）へ行く線だけが隙間の真ん中を通り、近い列の線は手前で自分のピンに曲がる。TX は結合コンデンサ（C61 が N、C60 が P、FX3 側が左になるよう向きを直す）のために表面へ上がり、そのまま 17/18 番に入る。組の中の長さの差は、短い線（DP、SSTX_P、TX+SSRX_P）に四角いバンプを足して 0.01mm 以下にそろえる（DP と SSTX_P は帯の組の間に互い違いに、TX+SSRX_P は J7 側の表面で）。層を変える SuperSpeed のビアには GND のリターンビアを置く（planes.SS_PREFIX に HDR を加え、探す半径を 2.0mm まで広げた）。 | ヘッダ側の 0Ω は USB-C の鎖の横（D-56）、ヘッダはカードの奥の端にあり、途中の FX3 の下の In2 は GPIF でふさがっている。裏面の下端の帯は空いていて、裏面は In4 の GND が切れ目なく下にある（D-75）。両端のピンの並びから、帯の中の順と降りる列の順が一意に決まった。ヘッダは DNP なので、USB 2.0 の In2 区間の不整合は許容とした。結果（2026-11-06）：Freerouting をやり直し（パス 30。パス 20 では FX3 の BGA の右側で 4 つの網が 2 組ずつ同じ隙間を取り合い、仕上げで FX3_RESET_N と FX3_PMODE2 が残った）、信号と面の未接続 0、規則の違反なし、行き先のない銅なし、作り直しても同じファイル。基板の生成は約 6 分（仕上げのつなぎが増えた）。帯で FX3 の下の裏面が埋まり、面のビアを脇に置けない電源のピンが増えた（配線の前に面へつなぐ、D-77）。あわせて直した点：(1) 面のビアと配線前のつなぎのビアが基板端から 0.3mm を確かめていなかった（R1 の GND のビアが端にかかった）。(2) 面の仕上げの引きはがしで、経路の終わりの面のビアの点を層として引いて止まった。(3) 仕上げで取り合いになる網のため、最後の手段の引きはがしを網ごとに 3 回まで許し、はがされた回数だけ次にはがす値段を上げる（PathFinder と同じ考え方）。(4) 線がビアの縁に重なってつながっているとき、片面だけのビアを短い線に置き換えられなかった。 |
