nanashima4268/otr-4ts3-u1/docs/research.md

# 事前調査レポート（2026-11-01 時点）

OTR-4TS3-U1 の設計に入る前の調査結果をまとめる。
「推定」「未確認」と書いた項目は、試作や追加調査で確かめる必要がある。

## 1. 参照ボード：e-Better DTV02A-4TS-P

写真は `reference/photos/` にある。IMG_8567 と IMG_8570 が表面、IMG_8568 と IMG_8569 が裏面で、1 枚の基板（シルク ISDB6014 V2.0、ロット 2309）を両面から撮ったもの。

| 役割 | 部品 | 位置 | 出典・根拠 |
|---|---|---|---|
| USB→TS ブリッジ兼 B-CAS リーダー制御 | ITE IT9305E（LQFP128） | 裏面 U4 | px4_drv README、写真 |
| 復調 | Sony CXD2856ER ×4 | 表面 U8 と裏面 U6・U10・U12。裏面の U14 は空き | 同上 |
| チューナー | Sony CXD2858ER ×4（HELENE） | 表面の U5・U7・U9・U11（U5 は刻印が擦れている）。**U13 は空きフットプリント**（2026-11-01 訂正） | 同上、reference/other-boards.md |
| ブリッジ用ファームウェア | it930x-firmware.bin（PLEX 製ドライバから抽出したもの） | — | px4_drv |
| ホスト接続 | PCIe x1 からは電源だけを取る。データは内部 USB2 ヘッダ（USB1）経由 | — | px4_drv |
| アンテナ入力 | ANTT1（地上）と ANTS1（衛星）の F 型 2 端子 | — | 写真 |
| RF 前段 | コネクタ近くの U15・U16・U18・U19 は、分配器か LNA と推定 | — | 写真から推定 |
| LNB 給電 | U22・L52・SS14（昇圧回路）と推定。U5 はチューナーだった（訂正） | — | reference/other-boards.md |
| 電源 | DC-DC が 2 段（U2＋L3、U1＋L2）。品番と出力電圧は不明 | — | 写真、reference/other-boards.md |
| 基板の素性 | PX-MLT5PE V1.0 と同じ基板（ISDB6014 V2.0）で、5 系統目を実装していない | — | reference/other-boards.md |
| その他 | SOIC-8（U1 付近、IT9305E 用の EEPROM か SPI フラッシュと推定）、水晶はチップごとに 1 個 | — | 写真 |

関連製品の構成は次のとおり（px4_drv の README による）。

- PX-MLT5PE／DTV02A-5TS-P：IT9305E ＋ CXD2856ER ×5 ＋ CXD2858ER ×5
- PX-W3PE4・PX-Q3PE4：IT9305E ＋ TC90522XBG ＋ R850（地上）＋ RT710（衛星）
- PX-Q3PE5：PCIe→USB ブリッジの ASIX MCS9990 を追加し、外部 USB ケーブルを不要にしている

## 2. 放送方式と周波数

| 方式 | 帯域 | 変調・帯域幅 | 規格 |
|---|---|---|---|
| 地デジ（ISDB-T） | UHF 470〜710MHz | OFDM、6MHz 幅（13 セグメント） | ARIB STD-B31 |
| CATV のパススルー／トランスモジュレーション（ISDB-C） | VHF〜UHF、おおむね 90〜770MHz（要確認） | 64QAM（J.83 Annex C） | JCTEA |
| BS／110 度 CS の右旋（ISDB-S） | 中間周波数 1032〜2071MHz | TC8PSK・QPSK ほか | ARIB STD-B20 |
| BS4K の右旋（ISDB-S3） | 同上 | 16APSK ほか、33.7561Mbaud、34.5MHz 幅、約 100Mbps | ARIB STD-B44 |
| BS／110 度 CS の左旋（ISDB-S3） | 中間周波数 2224〜3224MHz | 同上 | 同上。2018 年から中間周波数の漏れに技術基準がある |

- アンテナへの給電：日本の BS/CS 用 LNB は 15V で動き、偏波を切り替える必要はない。市販の LNB 給電 IC（ST LNBH25、TI TPS65233）は欧州向けの 13/18V なので、15V 単一で設計し直すか、出力電圧を変える必要がある。
- 左旋の帯域は 3224MHz まで届くので、分配器、コネクタ、基板の伝送路も 3.2GHz まで性能を保つ必要がある。

## 3. チップ候補

| 部品 | 機能 | 対応方式 | 入手性 | 資料の公開状況 |
|---|---|---|---|---|
| **CXD2856ER** | 復調 | ISDB-T/S/C、DVB-T/T2/C/C2/S/S2 | ブローカーに在庫あり（数ドル） | 非公開。px4_drv（GPLv2）が実質的な仕様書 |
| **CXD2858ER**（HELENE） | チューナー | 地上と衛星。衛星側の上限は約 2.07GHz | ブローカーに在庫あり（5〜16 ドル程度） | 非公開。Linux の helene ドライバと px4_drv が頼り |
| **CXD2857ER** | 復調 | 上記に加えて **ISDB-S3**。TLV をシリアル出力 | ブローカーでの流通は確認できず。東芝 43M520X や TT-4K100 に 1 個ずつ載っている | 非公開。tbs6812_drv（GPLv2）が頼り |
| PT4K のチューナー（型番不明。CXD2868ER と推定） | 地上、右旋、左旋（2150MHz を超える帯域は別経路） | — | 未確認 | tbs6812_drv にレジスタ操作の記述がある |
| CXD2878ER | 復調 | ISDB-T/C/S、DVB、ATSC3.0。**S3 には非対応** | NDA が必要 | 非公開 |
| Si2183 ＋ Si2141 | 復調＋チューナー | ISDB-T/C、DVB 系。**ISDB-S には非対応** | LCSC に在庫あり | 簡易版のデータシートのみ |
| Socionext SC1501A ＋ SiTune STN6528 | S3 の復調＋チューナー | — | NDA が必要 | 非公開 |

- CXD2856ER と CXD2857ER は、どちらも 48 ピン 7mm 角の VQFN で、同じドライバのソースで扱われている（チップ ID は 0x090 と 0x091）。東芝の機器では両者が同じ基板に並んでいる。そのため**同じ基板パターンで載せ替えられる可能性が高い**。ただしピン配置が同じかどうかは未検証で、取り外した実物の基板で確認する（D-05）。
- 復調 IC にはファームウェアを読み込ませる必要がない（ドライバがレジスタを直接設定する）。

## 4. 先行例

| 製品 | 構成 | 参考になる点 |
|---|---|---|
| Earthsoft PT3 | Altera FPGA による PCIe ブリッジ、TC90522、チューナーモジュール（MxL301RF ×2 と QM1D1C0042 ×2） | 1 つの FPGA に 4 本の TS をまとめている。LNB の制御も FPGA が行う |
| TBS6812／PT4K | TBS の FPGA ブリッジ（ECP3）、CXD2857ER ×2、Sony チューナー | 唯一の公開ドライバ付き S3 カード。TLV をストリーム ID で選んで出力する |
| エスケイネット ISDB-TS3 | USB2（最大 120Mbps）。ISDB-T/S/S3/C と DVB-S/S2 に対応 | 目標仕様の参考になる。中間周波数 1032〜2072MHz と 2224〜3224MHz、LNB 給電 11〜15V・400mA |
| 東芝 TT-4K100 | CXD2857ER ×1、CXD2856ER ×3、MediaTek の SoC | 2K 用 3 系統と 4K 用 1 系統の混在構成。S3 用チップの取り外し元になる |

## 5. ホストとの接続

必要な帯域は、2K 放送 ×4 で約 210Mbps、S3 ×4 で最大約 400Mbps。

| 案 | 実効帯域 | 判定 |
|---|---|---|
| IT9305E（USB2） | 約 35MB/s | TLV を扱えるか不明で、ファームウェアも再配布できない。**採用しない** |
| iCE40HX8K ＋ FT601 | 約 200MB/s 以上 | 当初の採用案。D-07 の改訂で取り下げた（ドライバのソースが非公開で、TQ144 版もないため） |
| **iCE40HX4K-TQ144 ＋ FX3** | 約 300MB/s 以上 | **採用（D-07 改訂）**。ホスト側は libusb だけで完全にオープンソースにできる |
| iCE40HX8K ＋ FT2232H | 約 40MB/s | 予備案。2K ×4 と S3 ×1 程度まで |
| ECP5 ＋ FX3 | 約 300MB/s 以上 | 将来の PCIe 版（P2）の候補 |

FT601 の注意点は次のとおりで、これが D-07 を改訂する理由になった。

- DigiKey では欠品中で、RS には在庫がある。代替品番 FT600（16 ビット版）も考慮しておく。
- FTDI 純正のドライバ（D3XX）はソースが非公開。オープンソースで公開するなら、コミュニティの ft60x ドライバを使えるか調べる必要がある。

FPGA の主な仕事は次のとおり。

- 4 系統の TS／TLV を受け取り、ヘッダを付けて 1 本に多重化し、FX3 の GPIF II（同期スレーブ FIFO）に送る
- I²C マスター（各チップの制御）
- GPIO（リセット、LNA の切り替え、LNB の制御）
- （パターンのみ）ISO7816 の UART。B-CAS リーダー用

## 6. RF 設計の定石

- **入力保護**：F 型コネクタの直後に、サージと ESD の保護（GDT か低容量 TVS）と DC カットのコンデンサを置く。LNB 給電のパターンは、インダクタで RF 線に DC を重ねる（バイアスティー）。
- **分配**：入力 1 本を 4 系統に分けると、理論上 6dB、実際には約 7dB 失う。そこでバイパスできる LNA を前に置いてから分配する（D-17）。衛星側は 3.2GHz まで通す必要がある。
- **伝送路**：JLCPCB の 4 層基板は表層の誘電体が薄く、普通のマイクロストリップで 75Ω を作ると線幅が非常に細くなる。対策は次のどちらか。
  - 50Ω の CPWG（周囲にグランドを置いた線路）で配線し、コネクタ近くで整合する
  - 第 2 層のグランドを抜いて、第 3 層を基準面にする
  
  JLCPCB のインピーダンス計算ツールで、指定スタックアップ（JLC04161H-7628 か -2313）の値を確認する。
- **分離**：
  - DC-DC コンバータ、FPGA、USB3 は、RF 部から物理的に離し、グランドの切り込みとビアの壁で隔てる
  - チューナーごとに LDO とフェライトビーズで電源を分ける
  - シールドケースを付けられるパターンを用意しておく
  - DC-DC はスイッチング周波数の高調波が受信帯域に入るので、周波数の選択とスペクトラム拡散を検討する
- **クロック**：参照ボードはチップごとに水晶を持っている。共通クロックにしてコストを下げることもできるが、スプリアス（不要な信号）の危険が増えるので、v1 は参照ボードの方式に従う。
- **デバッグ性**（D-06 で 1 系統の評価基板を作らない代わりに必須）：
  - 系統ごとに電源を有効化できるようにし、0Ω 抵抗で切り離せるようにする
  - 各 TS 線にテストポイントを置き、I²C ヘッダを出す
  - RF 経路にジャンパを置き、外部チューナーに信号を出せるようにする

## 7. 電源

- **PCIe x1 の給電能力**：CEM 規格では、x1 カードの上限は 10W（12V は 0.5A、3.3V は 3A）。チューナー 4 系統、FPGA、FX3、LNB 給電（15V で最大約 4W）を合わせると上限に近づく（要計算）。LNB 給電を使う場合は、DC ジャックからの補助給電を前提にする（D-08 と整合）。
- 箱として使う場合は 12V の DC ジャックを使う。PCIe からの給電とは、理想ダイオードなどで OR 接続する。
- 必要な電圧はおよそ次のとおり（データシートが非公開なので、参照ボードの部品配置から推定）。
  - 3.3V（I/O）
  - 1.8V、1.2V（チップ内部のコア電圧）
  - 2.5V（未確認）
  - FPGA のコア電圧 1.2V
  - FX3 のコア電圧 1.2V

## 8. 製造（JLCPCB）

- 4 層のインピーダンス制御スタックアップ JLC7628 と JLC2313 が公式に用意されており、誤差は ±10%（オプションで ±5%）。
- PCIe の端子部分（金メッキの端子と面取り）は、データ線を使わない場合でも、スロットに差すなら必要になる。
- 2026 年 8 月から、海外の顧客が部品を送って実装に使ってもらう「支給部品」サービスが正式に始まった。Sony IC はこれで支給するか、受け取った後にホットエアで後付けする。
- LCSC の Extended 部品は種類ごとに追加料金がかかる（約 1.5 ドル、2025-12 時点）。部品の種類を減らすほど安くなる。

## 9. 法的な線引き（自分用と頒布の違い）

弁護士の確認を経たものではない。頒布する前に専門家に確認する。

| 論点 | 自分用 | 頒布 |
|---|---|---|
| 電波法 | 受信機に免許や技適は不要。ただし不要な電波を出して他の無線を妨害すれば措置の対象になる（第 82 条）。左旋の中間周波数の漏れには基準がある | 量産品として、電波の漏れを自主的に試験することが事実上求められる |
| 暗号の解除（B-CAS、ACAS） | 主な規制対象は「提供」。個人で解除する行為への刑事罰は限定的だが、著作権法の私的複製の例外からは外れる | **刑事罰の対象**（不正競争防止法、2018 年改正）。カードリーダーと復号ソフトを組み合わせて頒布するのは避ける（D-13） |
| ファームウェアとドライバ | — | 他社のファームウェア（it930x 等）は使わない。px4_drv から派生したコードは GPLv2 で公開する（D-19） |
| 部品の調達 | ブローカー品でよい | 供給の保証がない。偽物が混じれば製造物責任の問題になる |
| 電気用品安全法、VCCI | 関係しない | AC アダプタを同梱するなら PSE が必要。VCCI は任意だが事実上必要 |

## 10. 測定（SDR で代用）

- RTL-SDR（R820T2）で見られるのは約 24〜1766MHz なので、地デジ、CATV、右旋の中間周波数の下半分しか確認できない。右旋の上半分や左旋を見るには HackRF 級の SDR（〜6GHz）が必要。
- 復調 IC 自体が、C/N、BER、信号強度（RSSI）、AGC の値を返す。これを主な測定手段にし、参照ボード（DTV02A）と同じアンテナ入力で比べる。
- ツール：gr-isdbt（GNU Radio で地デジのフルセグを復調できる）。

## 11. リスク

| ID | リスク | 対策 |
|---|---|---|
| R-01 | Sony IC が偽物や再刻印品 | 少量を先に買い、I²C でチップ ID を読み出して確認する。DTV02A を検証台に使う |
| R-02 | 公開データシートがない | px4_drv、helene、cxd2841er、tbs6812_drv から電源シーケンスと I²C アドレスを読み取る。参照ボードを実測する（電圧と接続の確認） |
| R-03 | 4 系統の基板をいきなり作るので、不具合の切り分けが難しい | 系統ごとの切り離し、テストポイント、外部チューナー出力（§6）を用意する |
| R-04 | ロープロファイル（高さ約 68.9mm）に部品が詰め込まれる | 基板の長さで面積を稼ぐ（ハーフレングスの約 168mm まで）。両面実装も検討する |
| R-05 | PCIe x1 の 10W 制限 | 電力を見積もったうえで、DC ジャックから補助給電する |
| R-06 | （解消済み）FT601 のドライバ問題 | D-07 の改訂で FX3 に変更した |
| R-07 | CXD2856ER と CXD2857ER のピン互換が未検証 | ジャンク機器から取り外した実物の基板で確認する |
| R-08 | DC-DC や FPGA のノイズで受信感度が落ちる | 配置を分ける、スイッチング周波数を選ぶ、シールドを付けられるようにする、LDO を後段に置く |

## 12. 調査項目の状況（2026-11-01 更新）

- [x] I²C アドレス、水晶、TS の形式、電源投入の手順：px4_drv から判明した（architecture.md §2）
- [ ] **電源電圧とピン配置**：データシートが流出しておらず、NetUP カードの回路図も見つからない。参照ボードの実測で調べる（measurement-procedure.md）
- [ ] CXD2858ER の RF 入力回路：同上（実測の §2-3）
- [ ] 参照ボードの RF 前段 IC の型番：接写撮影で調べる（実測の §1）
- [ ] PT4K のチューナー IC：型番は不明。tbs6812_drv から、1 個の IC で地上、右旋、左旋（2150MHz を超える帯域は別経路）を扱っていることが分かった。v1 では対象外（D-05）
- [x] CATV の周波数範囲：中心周波数 93〜767MHz、帯域端で 90〜770MHz（px4_drv の isdbc_channel.h。ARIB STD-B21 付属 10 のとおり、C22 と VHF4〜7 だけ 2MHz ずれる）
- [x] FT601 のドライバ：D3XX はソース非公開（Linux 版 1.1.6、Windows は WinUSB 系）。オープンソースの ft60x-rs は読み出し専用で、ライセンスも書かれていない。**このため FX3 に変更した（D-07 改訂）**
- [x] JLCPCB のスタックアップ寸法：下の表（計算値。JLCPCB の計算ツールで最終確認する）
- [x] PCIe の電力：x1 カードは 12V が 0.5A（6W）、全体で 10W。ロープロファイルは 10W が上限で拡張できない（CEM 規格を引用した二次資料による）
- [x] iCE40 のパッケージ：HX8K には TQ144 版がない。HX4K-TQ144 の中身は HX8K と同じダイ（IceStorm で `--hx8k --package tq144:4k`）
- [x] 部品の入手性：bom-candidates.md

### JLCPCB の 4 層基板（1.6mm 厚）で配線のインピーダンスを合わせる寸法（計算値）

閉形式の近似式で計算した。銅箔の厚みとソルダーレジストの影響は含めていない。

| スタックアップ | 表層の誘電体 | 50Ω マイクロストリップ | 75Ω マイクロストリップ | 75Ω CPWG（隙間 0.2mm） | 75Ω、第 2 層のグランドを抜いて第 3 層を基準にする場合 |
|---|---|---|---|---|---|
| JLC04161H-7628 | 0.2104mm、Er 4.4 | 線幅 0.405mm | **線幅 0.188mm** | 線幅 0.167mm | 線幅 1.145mm |
| JLC04161H-3313 | 0.0994mm、Er 4.1 | 線幅 0.202mm | 線幅 0.095mm | 線幅 0.098mm | 線幅 1.230mm |
| JLC04161H-2116 | 0.1164mm、Er 4.16 | 線幅 0.234mm | 線幅 0.110mm | 線幅 0.111mm | 線幅 1.244mm |

推奨は **JLC04161H-7628**。この表は閉形式の近似で、銅厚とソルダーレジストを含まない。配線に使う値は、それらを含めた 2 次元の電界計算で求め直した（D-69：75Ω は 0.145mm、差動 90Ω は 0.263mm／間隔 0.15mm）。75Ω 配線が約 0.19mm 幅で、普通に作れる。USB3 の差動 90Ω も一般的な寸法で収まる。

### FX3 の基板設計の指針（Cypress AN70707 Rev. *D、中国語版、2026-11-02 確認）

- 推奨のパッドは 11mil（0.28mm）。KiCad 標準の 0.4mm のフットプリントのままでも、ドッグボーンは収まる。
- 電源層は電源の種類ごとに区切る。電源の線は 25mil 以上で短くし、電源のビアは大きめにする（パッド 30mil、穴 15mil。BGA の下を除く）。
- SuperSpeed の線は、隣の層の切れ目のない GND の上だけを通す。層を移るときは、信号のビアの近くに GND のビアを置く。AC 結合コンデンサの直下は、少なくとも 1 層抜く。
- 水晶は 2cm 以内に置き、線にはビアを推奨しない。高速の線を近づけない。
- 層数は 4 層以上（参考：SuperSpeed Explorer は 8 層）。
- 原文は ~/otr-data/work/docs/an70707/ に置く（Infineon の資料なのでリポジトリには入れない）。

### 新しく分かったリスク

- R-09：F 型コネクタの多くは 2.15GHz までの定格。左旋（〜3.2GHz）を通すには、3GHz 以上の定格品を選ぶ必要がある
- R-10：ICE40HX4K-TQ144 は JLCPCB の在庫が 25 個しかない。FX3 用の 19.2MHz 水晶も在庫が少ない（bom-candidates.md）
- R-12：TS のクロック周波数が分からない。ドライバのソースにも書かれておらず、オシロスコープもない。FPGA の TS 入力は 140MHz 以上で動くことを確認した（2026-11-01、比較のバグを直した後の値）。足りなければ復調 IC 側で Mid/Low の周波数設定に下げられる（tbs6812_drv のクロック表による）
- R-11：評価ボードを買わない場合、FX3 と FPGA の初めての実機確認が v1 基板になる。v1 に観測用のテストポイントと、USB 起動用のジャンパを用意しておく

## 出典

- px4_drv（チップ構成、ファームウェア、カードリーダー）：https://github.com/tsukumijima/px4_drv
- tbs6812_drv（CXD2857ER、S3 と TLV、左旋の扱い）：https://github.com/otya128/tbs6812_drv
- PT3 の構成（Linux カーネルのコミット）：https://gfiber.googlesource.com/kernel/bruno/+/f5a98f37a535a43b3a27c6a63b07f23d248e4b31
- Sony の受信 LSI 資料（CXD2878ER の対応規格）：https://www.atsc.org/wp-content/uploads/2021/01/f-36-26-13345252_W2dnWCqD_sony_ATSC3.0_receiverLSI_rev1.0.pdf
- Sony による S3 対応 LSI の発表（2016 年）：https://av.watch.impress.co.jp/docs/news/1012384.html
- TT-4K100 の分解記事：https://mazu-bunkai.com/bunkai-wp/ha/10492/
- 東芝 43M520X の分解記事：https://mazu-bunkai.com/bunkai-wp/engineering/8311/3/
- Socionext の S3 受信機：https://socionextus.com/wp-content/uploads/2023/08/ISDB-S3-receiver-AD04-00118-2E.pdf
- エスケイネット ISDB-TS3：http://nttxstore.jp/shop/g/gKB16310115
- 総務省（左旋の中間周波数 2224〜3224MHz）：https://www.soumu.go.jp/main_content/000499482.pdf
- Si2183 の簡易版データシート：https://www.skyworksinc.com:443/-/media/SkyWorks/SL/documents/public/data-shorts/Si2183-B60-short.pdf
- JLCPCB のスタックアップ：https://jlcpcb.com/quote/pcbOrderFaq/PCB%20Stackup
- JLCPCB の海外支給部品サービス：https://jlcpcb.com/news/jlcpcb-launches-compliant-overseas-component-consignment-service
- 経済産業省（不正競争防止法改正の概要）：https://www.meti.go.jp/policy/economy/chizai/chiteki/pdf/02_yokou.pdf
- ブローカー在庫の例：https://www.utsource.net/pro/CXD2856ER.html ／ https://www.win-source.net/hot-sales-and-eol-components-cxd2858er-t2.html
- LNB 給電 IC：https://st.com/en/power-management/lnbh25.html ／ https://ti.com/product/tps65233
