nanashima4268/otr-4ts3-u1/docs/reference/jlc-quote-2026-11-02.md

# JLC の見積もり（2026-11-02、受信部なしの第 1 段階）

JLC の見積もり画面で取った額。注文やカートへの追加はしていない。JLC のアカウントには、見積もり用のプロジェクト「otr-4ts3-u1-gerber」が自動で保存されている。入力したデータはコミット 1655aa8 の hw/gen/fab.py の出力。受信部（Sony IC など）は入っていない。

## 条件

基板 5 枚、4 層、1.6mm、68.9×120mm、ENIG 1U"、PCIe の端子は金＋30° の面取り（深さ 1.13mm）、積層 JLC04161H-7628 を指定、ビアは穴埋め（Plugged）、最小のビアは 0.15mm（USB-C の列のビア、D-70）。組み立ては 2 枚、表面のみ、Standard（Economic は選べなかった）、捨て板（5mm ×2）は JLC が付ける。

## 額（USD、送料を除く）

| 項目 | 額 |
|---|---|
| 基板（5 枚） | 104.74 |
| 　エンジニアリング料 | 25.00 |
| 　ENIG | 17.70 |
| 　基板 | 5.90 |
| 　基材 TG155（細いビアで自動） | 3.54 |
| 　4 線式の導通検査（細いビアで自動） | 17.17 |
| 　最小のビア 0.15mm | 35.43 |
| 組み立て（2 枚、Standard） | 224.44 |
| 　段取り | 25.75 |
| 　ステンシル | 8.27 |
| 　部品（51 種類） | 102.50 |
| 　拡張部品の装着料（Feeders Loading） | 75.95 |
| 　SMT の実装 | 4.14 |
| 　手はんだ（THT） | 3.61 |
| 　手作業 | 0.36 |
| 　X 線検査（BGA） | 3.30 |
| 　梱包 | 0.50 |
| 　特殊部品（USB-C） | 0.06 |
| 合計 | 329.18 |

納期：基板 3 日、組み立て 5〜6 日（4〜5 日は +$49.63、3〜4 日は +$99.25）。

## 細いビアを使わない場合との差

- 最小のビアを 0.3mm（標準）にすると、基材・導通検査・ビアの 3 項目（約 $56）が消え、基板は $47.60（組み立てなしで見た額）。
- 0.25mm／0.2mm でも基材・導通検査は自動で付く（約 +$38）。

## 部品の照合で分かったこと

- 51 種類すべてが JLC の部品と対応した。部品の在庫切れはなかった。USB-C（C134092）は在庫 161,484。
- JLC は USB-C（J3）の選択を自動で外す（処理が難しい部品の扱いで、特殊部品の料金 $0.03／個）。上げ直すたびにチェックを入れ直す。
- 同じ部品に BOM の 2 行が対応すると選べない（F 型コネクタの ANT-T と ANT-S）。fab.py で部品ごとに 1 行にまとめた。
- 拡張部品（Extended）は 1 種類ごとに装着料がかかり、組み立ての額の 1/3 を占める。

## 部品の向き（発注前に全部品を確かめる）

JLC のプレビューで見た範囲：

- U1（FX3、BGA）と Y1（水晶）は合っている。
- U3（iCE40、TQFP-144）は 90° ずれている。フットプリントの 1 番ピンは左上、JLC の部品の 1 番ピンは左下。補正は −90°（JLC の向きで 270° を足す）の見込み。
- J5／J6（F 型コネクタ、自作のフットプリント）は、JLC の部品が 90° 回り、位置も奥へずれている。フットプリントの原点が前側の穴なので、CPL の座標を部品の中心にする補正が要る。挿入実装なので、実際は穴に合わせて手はんだされる。
- そのほかの IC（SOT-23-5、SOIC-8、WQFN-30、TSSOP-16、SOT-363、DFN-8）と有極性の部品（LED、ダイオード）は、受信部を入れた後の発注前の確認で一つずつ見る。

## 6 層の見積もり（2026-11-04、D-75）

Advanced PCB（6 層は Standard では選べない）、ログインなし、基板 5 枚、120×68.9mm、1.6mm、FR4 TG135、ENIG 1U"、金の端子＋30° の面取り、ビアは既定の Epoxy Filled & Capped、最小のビア 0.3mm（0.4／0.45mm）、7〜8 日。

| 項目 | 額（USD） |
|---|---|
| エンジニアリング料 | 33.00 |
| ビアの処理 | 0.00 |
| 表面処理（ENIG） | 17.50 |
| 基板 | 5.40 |
| 合計（Web 価格） | 55.90 |

4 層の $47.60 より $8.30 高い。比較のため最小のビアを 0.15mm にすると、4 層と同じく TG155 $3.51、ビア $35.13、4 線式の導通検査 $17.09 が足される。組み立ての額は、6 層の製造データで見積もるときに確かめる。
