nanashima4268/otr-4ts3-u1/docs/reference/other-boards.md

# CXD2856ER／CXD2858ER を載せた他社ボードの写真調査（2026-11-01）

目的は、データシートが公開されていない受信部（復調 IC とチューナーの周り）について、参照ボード DTV02A-4TS-P の実測結果と照らし合わせる材料を集めること。

画像は他社の著作物なので、このリポジトリには入れない。出典の URL と、写真から読み取った事実だけを残す。画像と拡大した切り抜きは、作業者の手元（`~/otr-data/work/board-photos/`）に置いてある。

信頼度は 高／中／低 の 3 段階で示す。ピン番号は、QFN の慣例（ピン 1 を左上に置き、反時計回りに数える）を仮定したもので、Sony の実際の配置は確認できていない。

## 主な発見

1. **DTV02A-4TS-P（ISDB6014 V2.0）は、PX-MLT5PE V1.0 と同じ基板で、5 系統目を実装していないもの**（信頼度：高）。
   - 部品番号、配置、配線が一対一で一致する。
   - PX-MLT5PE、DTV02A-5TS-P、PX-MLT8PE も同じ設計の系統（基板の UL 番号 E319614）。したがって、この 4 機種は独立した裏付けにはならない。
2. **research.md の誤りの訂正**
   - 表面の U13 は「刻印のないチューナー」ではなく、**空きフットプリント**（はんだだけ残っている）。その水晶 Y12 も空き。
   - 裏面の U14（復調）と Y11 も空き。
   - 実装されているのは、チューナーが U5・U7・U9・U11（U5 は刻印が擦れて読めない）、復調が U8（表面）と U6・U10・U12（裏面）。
3. **ランドパターン**：空きフットプリントから形がわかる。
   - CXD2858ER（チューナー）：各辺 8 パッドの QFN-32（5×5mm と推定）。露出パッドに 3×3 のサーマルビア。
   - CXD2856ER（復調）：各辺 12 パッドの QFN-48（7mm）。サーマルビアは約 4×4。
   - 寸法は、手元の参照ボードの空きフットプリント（U13・U14）をノギスで測って確定できる。
4. **水晶**（信頼度：中）
   - チップごとに 1 個あり、共有はしていない。
   - 大きさは 3225 級。
   - ピン 1 から見て、置かれている辺はいつも同じ。チューナーはピン 25〜32 側、復調はピン 25〜36 側。
   - **周波数の刻印はどの写真でも読めず、24MHz／16MHz という前提は確認できていない。**
5. **電源**：DC-DC が 2 段（U2＋L3、U1＋L2）、LNB 用の昇圧が 1 段（U22＋L52＋SS14）。U1・U2・U22 の刻印は読めず、部品の特定と出力電圧は実測待ち。
6. **チューナーと復調の接続**（信頼度：低〜中）
   - U7→U8 は同じ面にあり、復調の上辺（ピン 37〜48 側）がチューナーを向いている。
   - 間に受動部品が 11 個並び、配線は隠れていて見えない。
   - チューナーの RF 入力付近には、インダクタが 5〜8 個ある。
7. **TBS6812（S3 版のピン互換、R-07 の手がかり）**
   - チューナーはシールドケース入りのモジュール「SUT-PJ581ZN」で、中は見えない。
   - 復調は SONY 刻印の 48 ピン QFN。水晶はピン 1 から見て同じ角にある。
   - ピン互換を支持する根拠としては弱い（信頼度：低）。

## 出典

| 機種 | URL | 内容 |
|---|---|---|
| PX-MLT5PE V1.0 | https://x.com/ochisan0412/status/1086592051611787265 | 表面・裏面の高解像度写真。投稿本文に「IT9305E×1、D2856ER×5、D2858ER×5」 |
| PX-MLT5PE | https://nyanonon.hatenablog.com/entry/20241217/1734418311 | 低解像度 |
| DTV02A-5TS-P | Amazon B0HCV3PMLM の商品画像 | 裏面のみ |
| DTV02A-5TS-P | https://x.com/TVRemotePlus/status/2100623843379544531 | 「PX-MLT5PE の放出品」という発言 |
| PX-MLT8PE V1.0 | https://nyanonon.hatenablog.com/entry/20250702/1751421646 | 裏面。ITE ブリッジ 2 個、5＋3 系統 |
| PX-MLT8PE | https://wp.yyya-nico.com/2025/08/03/px-mlt5pe-external-kit/ | 斜めから撮った写真 |
| TBS6812 | https://www.tbsdtv.com/products/tbs6812_pt4k_isdb_t_s_s3_pcie_card.html | 製品写真 |

見つからなかったもの：
- PX-MLT8PE3・PX-MLT8PE5 を区別できる写真
- DTV02A-5TS-P の表面
- PX-M1UR・DTV03A-1TU が同じ IC を使っているかどうか
- 刻印が読める、別系統のボードの高解像度写真

## 参照ボードの実測で決めること（measurement-procedure.md に反映する）

1. 各チップの電源ピンと電圧。U1・U2 の出力電圧。
2. U1・U2・U22 の品番。
3. 水晶の周波数。
4. チューナーの RF 入力ピンと IF 出力ピン、それぞれが復調側のどのピンにつながるか。U7→U8 の導通で調べる。
5. I²C の構成と、アドレスを設定するピン。
6. U13（チューナー）と U14（復調）の空きランドの実寸。こちらのフットプリントに使う。
7. U15・U16・U18・U19 の品番と、RF の分配経路。
8. 復調 IC の未使用ピンの処理。
