nanashima4268/otr-4ts3-u1/docs/reference/s0-baseline.md

# S0：参照ボードの基準データ（2026-11-01 06:40 JST）

環境：本番の録画用 VM（vm110-rec、Ubuntu 26.04、px4_drv 0.7.0、recisdb 1.3.2）。DTV02A-4TS-P は USB パススルーで VM に渡されている（USB ID 0511:0254）。
予約録画のない時間帯に、空いていたチューナー #4（`/dev/isdb6014video3`）で取得した。

## 未復号の TS（20 秒ずつ）

取得コマンドは `recisdb tune --no-decode --no-strip` で、復号もヌルパケットの除去もしていない。つまり、復調 IC が出力した TS とほぼ同じ形（ブリッジとドライバを通った後）になっている。
放送の内容を含むので、ファイルは公開リポジトリに入れない。保存先は `~/otr-data/s0-20261101/`（ローカルのみ）。

| チャンネル | ファイル | パケット数 | 同期エラー | TEI（エラー表示） | ヌル率 | スクランブル率（ヌル以外） | 平均レート |
|---|---|---|---|---|---|---|---|
| T27（NHK 総合） | raw_T27.ts | 398,270 | 0 | 0 | 54.2% | 95.6% | 29.9Mbps |
| T20（TOKYO MX） | raw_T20.ts | 398,270 | 0 | **5** | 46.7% | 86.8% | 29.9Mbps |
| BS15_0 | raw_BS15_0.ts | 317,570 | 0 | 0 | 19.8% | 97.2% | 23.9Mbps |
| BS01_0 | raw_BS01_0.ts | 230,944 | 0 | 0 | 7.4% | 97.8% | 17.4Mbps |

- 地デジのレート（ヌル込みで約 30Mbps）は、ISDB-T の TS 出力の上限（約 32.5Mbps）に近い。取得時間 20 秒には選局にかかる時間も含まれるので、その分だけ低く出ている。
- BS は、ドライバが TSID で 1 本に絞った後のレートになっている（トランスポンダ全体の約 52Mbps ではない）。
- **FPGA の設計値**：1 系統あたり最大で約 32.5Mbps（地デジ）。BS でトランスポンダ全体を出す設定なら約 52Mbps。4 系統合計で最大約 210Mbps。これは architecture.md の想定と一致する。

## C/N（`recisdb checksignal`、チューナー #4）

| チャンネル | C/N |
|---|---|
| T27 | 24.00dB |
| T20 | 26.00dB |
| T21 | 26.00dB |
| T25 | 24.50dB |
| BS15_0 | 16.02dB |
| BS01_0 | 14.67dB |
| BS13_0 | 16.02dB |

自作基板（OTR-4TS3-U1）の受信性能は、同じアンテナ配線で測ったこの値と比べて評価する。

## 気づいたこと

- T20 は C/N が 26dB あるのに、20 秒で TEI が 5 パケット出た。送信側の要因か、チューナー #4 固有の問題かは未確認。他のチューナーと比べるのは、次に機会があるときにする。
- Mirakurun の `decode=0` を付けても、チューナー設定のコマンド（recisdb）の段階で復号されるので、未復号の TS は取れない。未復号の TS が必要なときは、空いているチューナーで recisdb を直接実行する。
- vm-rec では `localhost` が ::1（IPv6）に解決され、Mirakurun の API が応答しない。127.0.0.1 なら応答する。homelab-infra の手順書は `localhost` を使っているので、注意が必要。

## 省いた項目

- px4_drv のデバッグログによる I²C 操作の記録：本番のカーネルモジュールの設定を変える必要がある。自作のホスト側ドライバは px4_drv のソースから移植するので（S5）、ソースそのものを基準にすれば足りる。そのため取らなかった。
