nanashima4268/otr-4ts3-u1/docs/reference/photos/IMG_8567.jpg

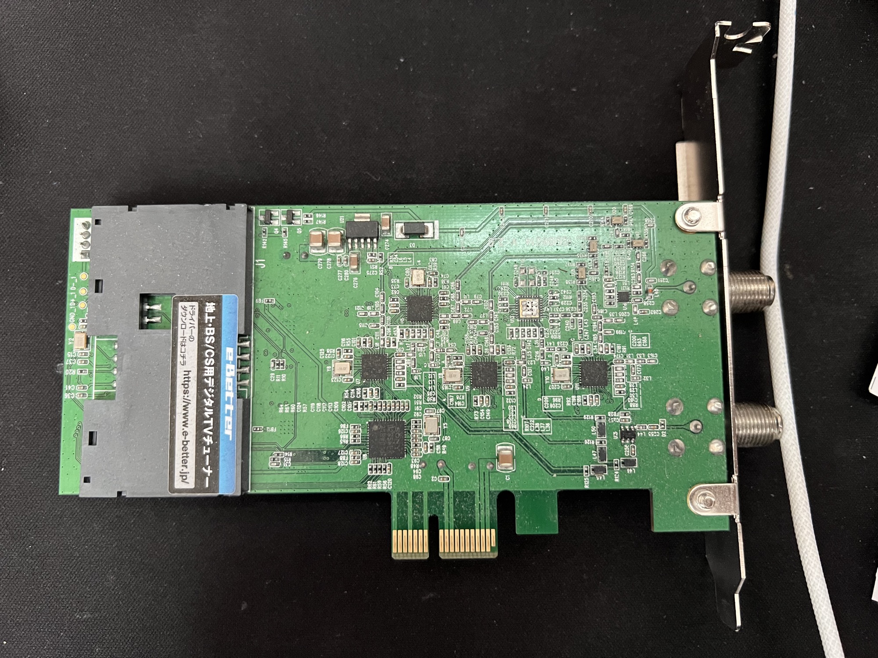
docs/reference/photos/IMG_8567.jpg
