nanashima4268/otr-4ts3-u1/docs/bom-candidates.md

# 部品候補表（BOM の叩き台）

調査日：2026-11-01。在庫と価格は JLCPCB の部品ライブラリ API で調べた値（1 個買いの単価）で、すぐに変わる。
種別の「基本」は JLCPCB の Basic 部品（追加料金なし）、「拡張」は Extended 部品（部品の種類ごとに追加料金がかかる）。
「支給」は JLCPCB に部品を送って実装してもらうもの。

## 主要 IC

| 機能 | 型番 | LCSC 番号 | パッケージ | 在庫 | 単価 | 種別 | 備考 |
|---|---|---|---|---|---|---|---|
| USB3 ブリッジ | CYUSB3014-BZXI（FX3） | C57294 | BGA-121（0.8mm ピッチ） | 4800 | $16.5 | 拡張 | D-07 で決定 |
| FPGA | ICE40HX4K-TQ144 | C1521989 | TQFP-144 | **25** | $17.1 | 拡張 | 中身は HX8K と同じダイ（IceStorm で hx8k の tq144:4k として扱う）。**在庫が少ないので早めに確保する** |
| 復調 | CXD2856ER | — | VQFN-48（7mm） | ブローカー | 1〜2 ドル程度 | 支給 | 少量買って検収してから追加購入（D-21） |
| チューナー | CXD2858ER | — | QFN | ブローカー | 5〜16 ドル程度 | 支給 | 同上 |
| I²C マルチプレクサ | TCA9546APWR | C201653 | TSSOP-16 | 11555 | $1.09 | 拡張 | PCA9546APW（C149507、$0.68）でもよい |
| FX3 用 SPI フラッシュ | W25Q32JVSSIQ | **C179173**（C82344 は在庫 0） | SOIC-8（208mil） | 4265 | $1.48 | 拡張 | FX3 の起動と FPGA のビットストリーム、固有 ID によるシリアル番号（D-49）。I²C EEPROM（24LC256）では容量が足りないのでやめた |

## RF 部

| 機能 | 型番 | LCSC 番号 | パッケージ | 在庫 | 単価 | 備考 |
|---|---|---|---|---|---|---|
| LNA（地上・衛星で共通） | **SGL0622Z** | C470895 | DFN-8（2×2） | 1668 | $1.39 | 5MHz〜4GHz、NF 1.4dB、利得 18.7dB、3.3V で 10.5mA。1 品種で両方の帯域を通せる |
| LNA の予備案 | PGA-103+ | C3008207 | SOT-89 | 954 | $2.77 | 50MHz〜4GHz。97mA と消費電流が大きい |
| LNA の予備案 | QPL9547TR7 | C5367093 | DFN-8 | 4875 | $6.72 | 100MHz〜6GHz、NF 0.3dB。100MHz より下が不足するので CATV の VHF 帯で使えない |
| バイパス用 SPDT スイッチ | AS179-92LF | C83422 | SOT-363 | 1800 | $1.09 | 20MHz〜4GHz、挿入損失 0.4dB。安価な互換品 HX179-92-ST（C20625093）もある |
| 4 分配 | 抵抗による 4 分配（星形、75Ω 系） | 0402 抵抗 | — | 基本 | — | 各枝に 45Ω（75×3/5）。損失は 12dB で、直流から 3.2GHz まで平坦。前段の LNA（利得約 19dB）で損失を補う |
| 分配の参考 | SCA-4-10+ | C2941271 | SMD | 35 | $8.72 | 1GHz までなので衛星には使えない。地上側を専用部品で分ける場合の候補 |
| ESD 保護（RF 側） | PESD0402-140 | C10662 | 0402 | 113743 | $0.14 | 0.05〜0.25pF。DC カットの後ろの RF 側に置く |
| サージ保護（LNB の DC 経路） | SMBJ18A | C10212 | SMB | 917 | $0.08 | 15V の LNB 給電を使う場合（DNP） |
| F 型コネクタ（基板実装、直角） | **未決** | — | — | — | — | **3.2GHz 以上の定格が必要**。多くの製品は 2.15GHz まで。「4K8K 対応」をうたう国内品か、Amphenol などで 3GHz 定格の品を探す（R-09） |

## 電源

| 機能 | 型番 | LCSC 番号 | パッケージ | 在庫 | 単価 | 備考 |
|---|---|---|---|---|---|---|
| 12V から 3.3V への降圧 | TPS54202DDCR | C191884 | SOT-23-6 | 299380 | $0.17 | 2A、500kHz。高調波が受信帯域に入らないか確認する（R-08） |
| 降圧の予備案 | SY8205FCC | C111875 | SOIC-8-EP | 13537 | $0.44 | 5A |
| 低ノイズ LDO（1.8V） | TPS7A2018 互換の XTPS7A2018-XC | C51953293 | SOT-23-5 | 22275 | $0.07 | 9µVrms。チューナーのアナログ電源の候補（電圧は実測で決める） |
| LDO（汎用、1.8V） | RT9013-18GB | C59969 | SOT-23-5 | 13484 | $0.17 | 500mA、EN 付き |
| LDO（3.3V） | TLV75533PDBVR | C404027 | SOT-23-5 | 103211 | $0.12 | 500mA |
| LNB 用の昇圧（DNP） | MT3608 | C84817 | SOT-23-6 | 64337 | $0.10 | 15.5V に設定し、後段に電流制限スイッチを置く。24V 定格なので余裕がある |
| 12V の OR 接続 | SS34 などのショットキーダイオード | 基本 | SMA | — | — | PCIe からの 12V と DC ジャックの 12V を OR でまとめる |

## 水晶とクロック

| 用途 | 型番 | LCSC 番号 | 在庫 | 単価 | 備考 |
|---|---|---|---|---|---|
| 復調 IC（24MHz） | X322524MSB4SI | C15643 | 131873 | $0.10 | 負荷容量 20pF。参照ボードの水晶の刻印と負荷容量を確認する |
| チューナー（16MHz） | X322516MLB4SI | C13738 | 360086 | $0.09 | **基本部品**、負荷容量 9pF。同上 |
| FX3（19.2MHz） | XXDBCCNANF-19.200（候補） | C358650 | 1388 | — | 3225、12pF。FX3 の条件は 19.2MHz ±100ppm（データシート）。旧候補 X3S019200BZ1H-CHZ（C254370）は在庫 3。他の 19.2MHz 品を探すか、26MHz の発振器を使う（FX3 は 26/38.4/52MHz のクロック入力にも対応している） |

## コネクタ

| 用途 | 型番 | LCSC 番号 | 備考 |
|---|---|---|---|
| USB-C（USB3 対応、24 ピン） | KH-TYPE-C-24P-T9.87（候補） | C709359 | 在庫 1460、$0.42。SuperSpeed のピン配置と、ブラケットからの高さを確認する。TYPE-C-31-M-17 は 6 ピンの電源専用なので使えない |
| 内部 USB3 ヘッダ | 2×10、2.0mm ピッチのボックスヘッダ（1 ピン抜き） | 要検索 | マザーボードとの接続には、メス-メスの 19 ピンケーブルを使う |
| DC 入力（箱用） | 基板上の 2 ピン端子（XH など）か 5.5/2.1mm ジャック | 基本 | 箱で使うときだけ。PCIe では使わない（D-30） |
| B-CAS スロット | ISO7816 準拠 SIM/スマートカード ソケット | 要検索 | DNP（D-13） |

## 未決事項

- F 型コネクタの型番（3.2GHz 定格）。USB-C は候補の検証が残っている
- Sony IC の電源電圧（実測待ち）。決まり次第、LDO の構成を確定する
- 19.2MHz 水晶を確保するか、発振器方式に切り替えるか
