nanashima4268/otr-4ts3-u1/hw/kicad/otr-4ts3-u1.kicad_pcb

## KiCad design hw/kicad/otr-4ts3-u1.kicad_pcb (2026-11-06)

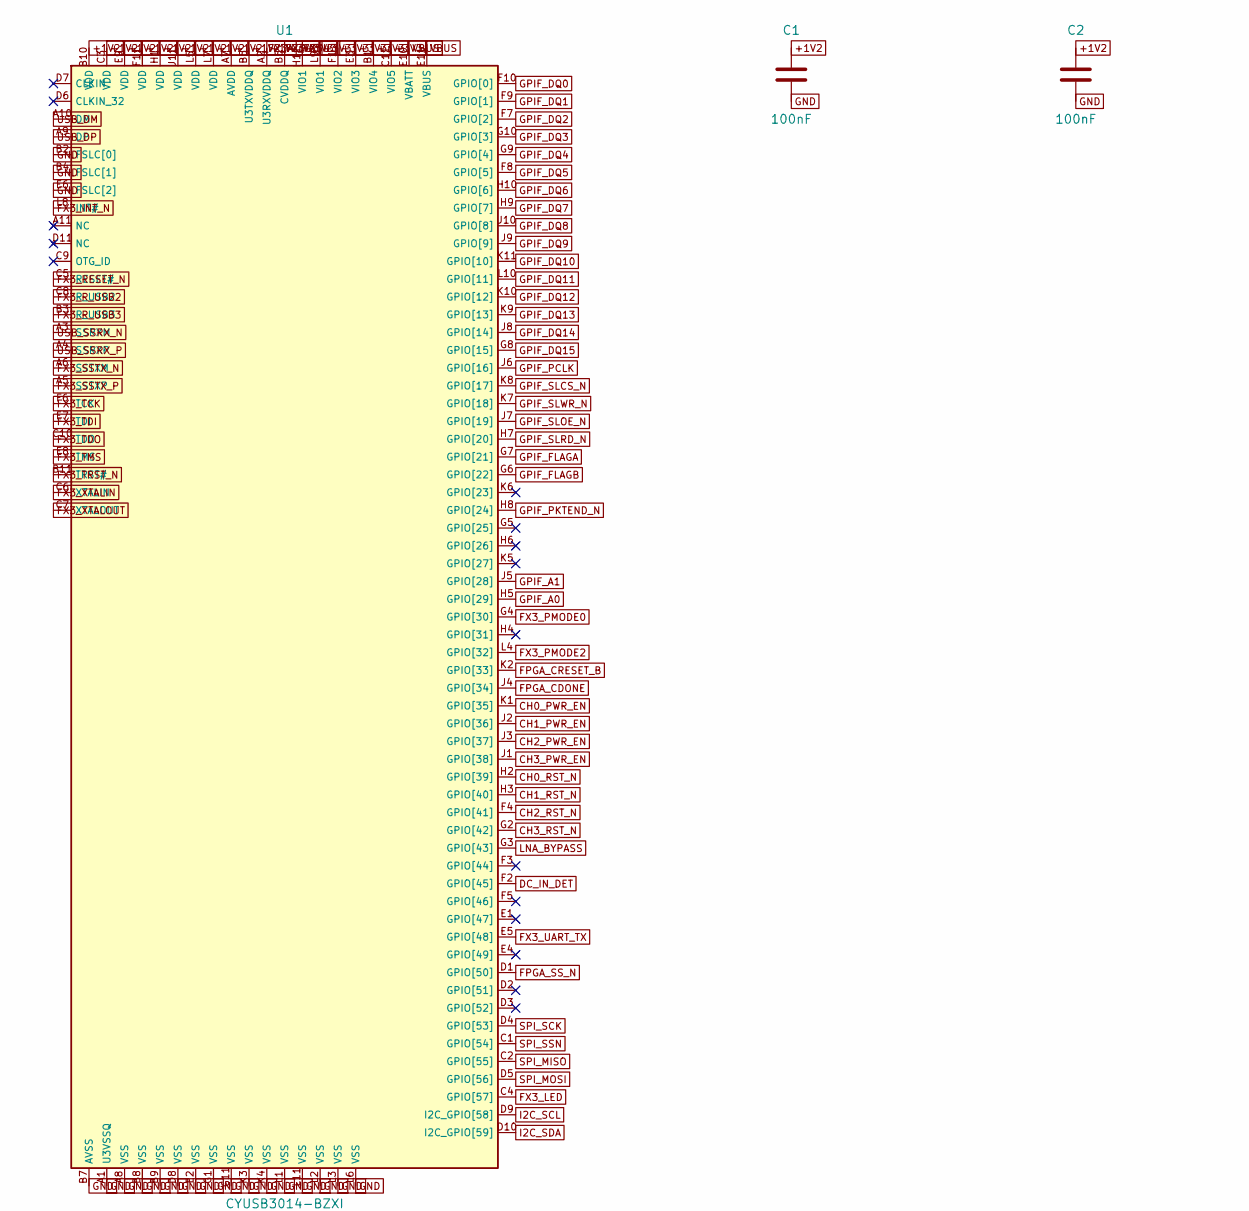
[picture p5: schematic fx3.kicad_sch, FX3 USB3 bridge, boot flash, part in row 1, column 1]

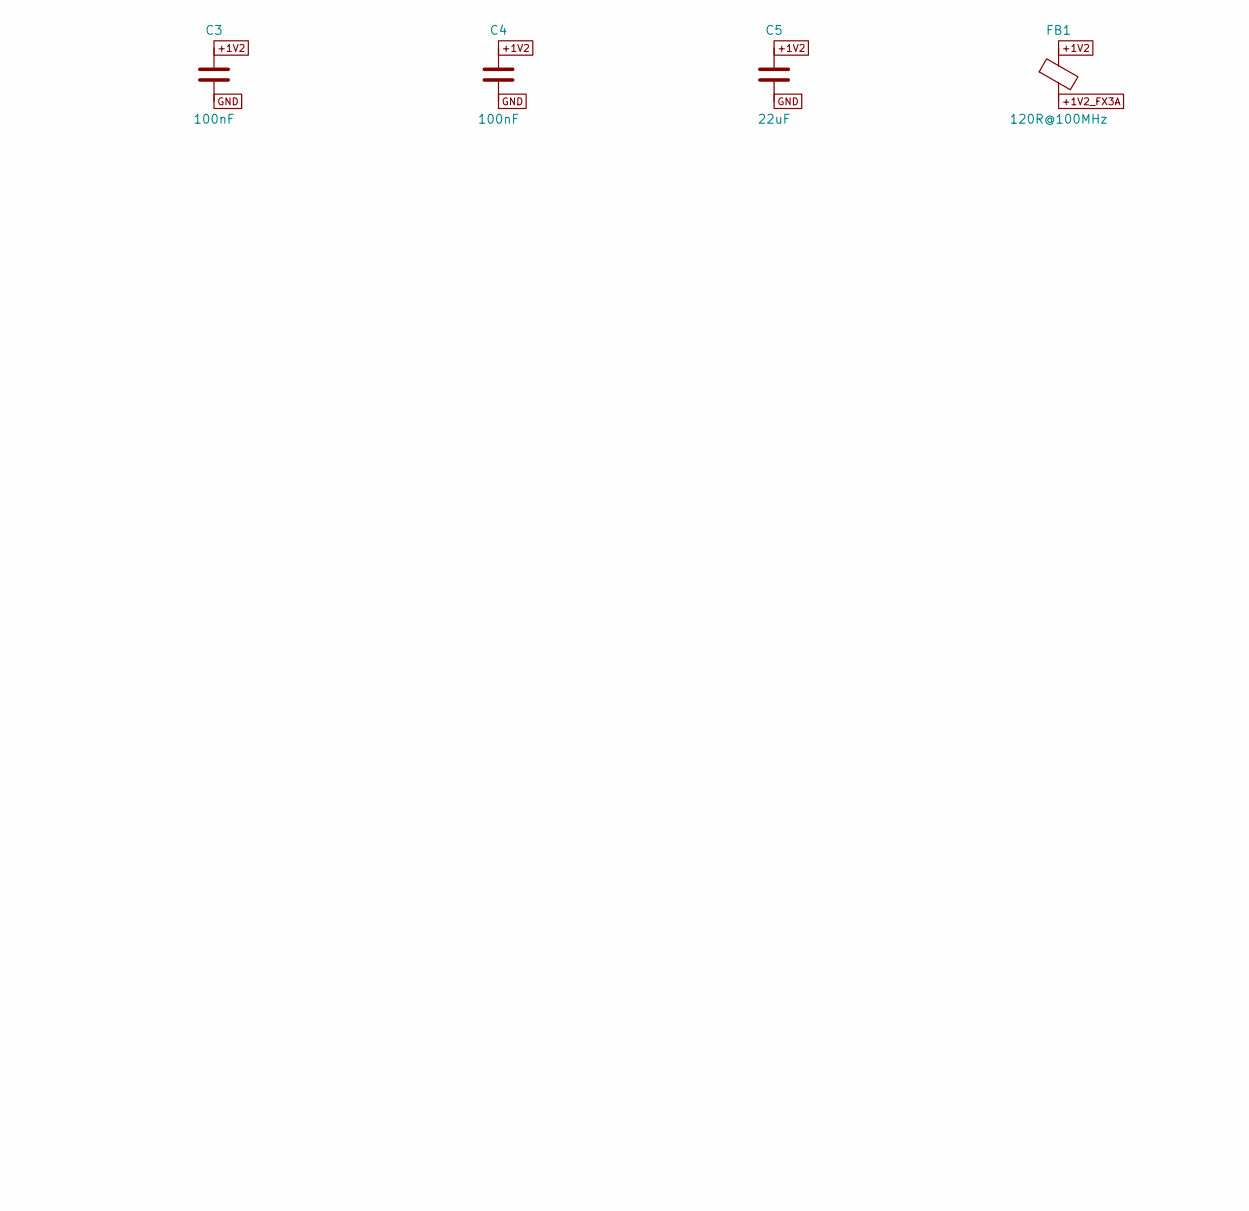
[picture p6: schematic fx3.kicad_sch, FX3 USB3 bridge, boot flash, part in row 1, column 2]

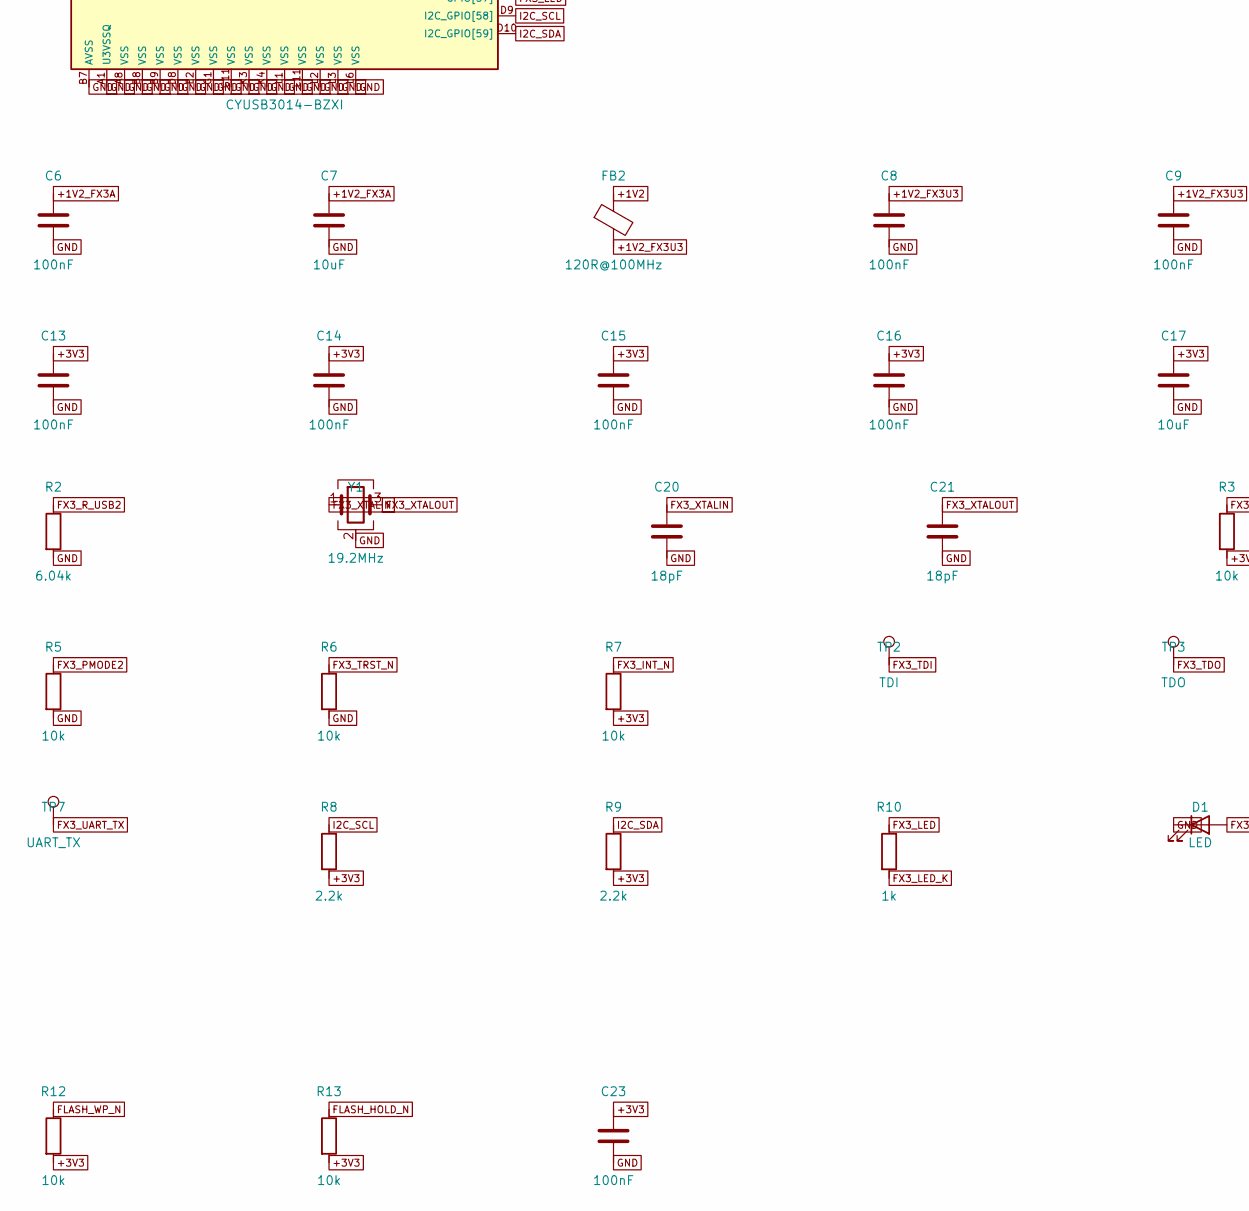
[picture p7: schematic fx3.kicad_sch, FX3 USB3 bridge, boot flash, part in row 2, column 1]

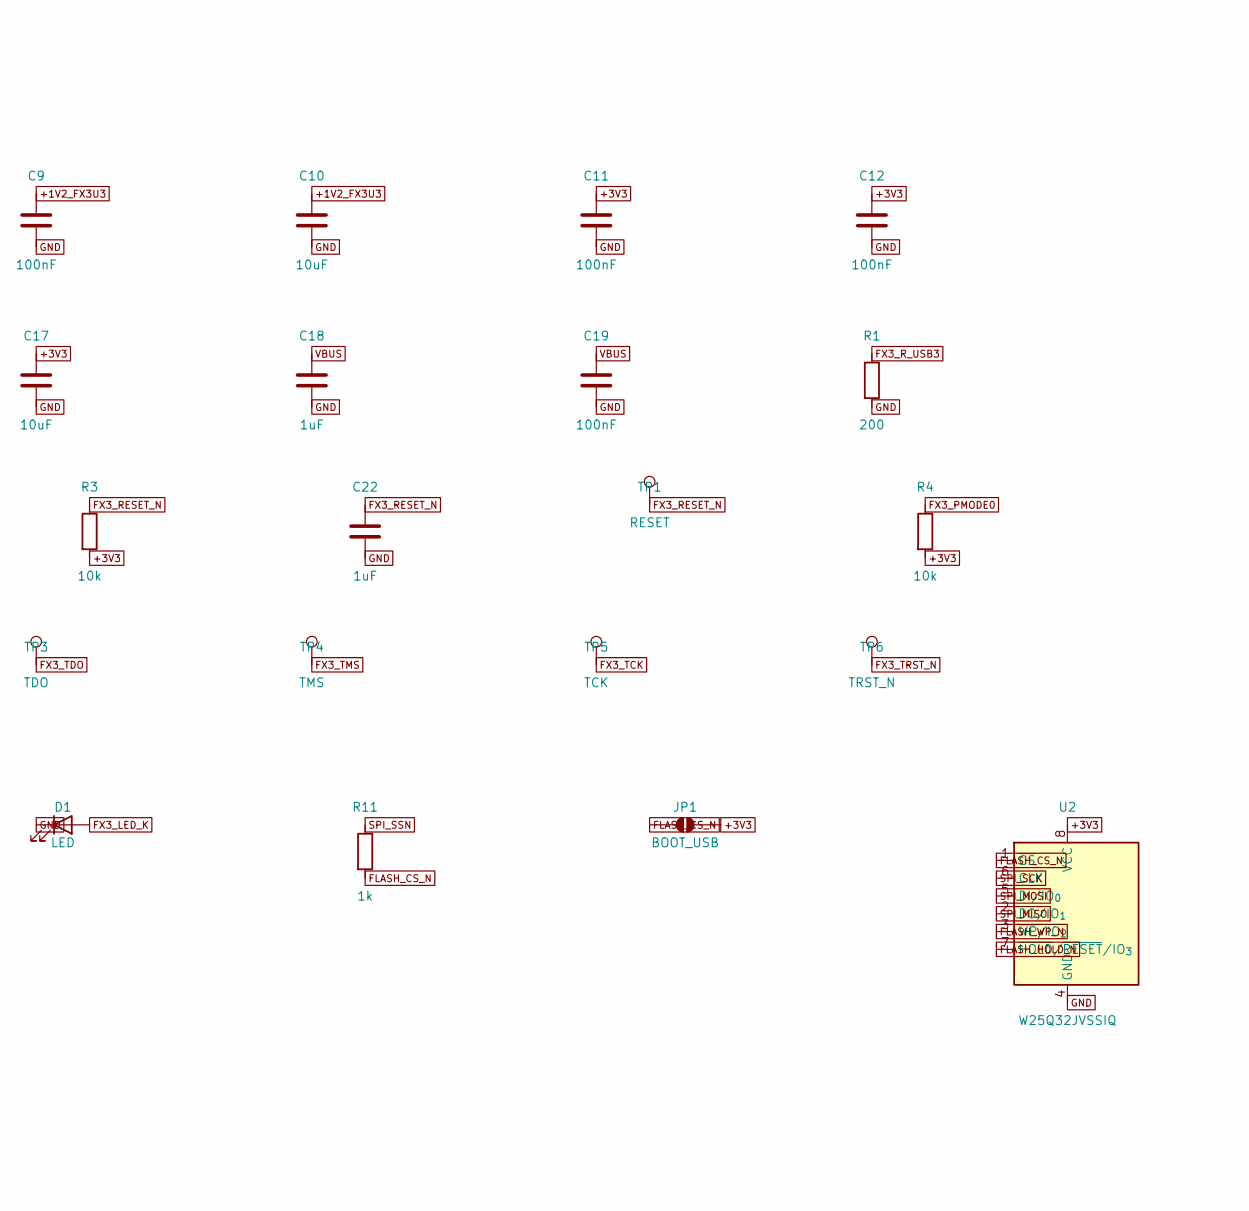
[picture p8: schematic fx3.kicad_sch, FX3 USB3 bridge, boot flash, part in row 2, column 2]

Parts:
C1, C2, C3, C4, C6, C8, C9, C11, C12, C13, C14, C15, C16, C19, C23: 100nF; C_0402_1005Metric; LCSC C1525
C5: 22uF; C_0805_2012Metric; LCSC C45783
C7, C10, C17: 10uF; C_0603_1608Metric; LCSC C19702
C18, C22: 1uF; C_0402_1005Metric; LCSC C52923
C20, C21: 18pF; C_0402_1005Metric; LCSC C1549
D1: LED; LED_0603_1608Metric; LCSC C2286
FB1, FB2: 120R@100MHz; L_0603_1608Metric; LCSC C14709
JP1: BOOT_USB; SolderJumper-2_P1.3mm_Open_RoundedPad1.0x1.5mm
R1: 200; R_0402_1005Metric; LCSC C25087
R2: 6.04k; R_0402_1005Metric; LCSC C97819
R3, R4, R5, R6, R7, R12, R13: 10k; R_0402_1005Metric; LCSC C25744
R8, R9: 2.2k; R_0402_1005Metric; LCSC C25879
R10, R11: 1k; R_0402_1005Metric; LCSC C11702
TP1: RESET; TestPoint_Pad_D1.0mm
TP2: TDI; TestPoint_Pad_D1.0mm
TP3: TDO; TestPoint_Pad_D1.0mm
TP4: TMS; TestPoint_Pad_D1.0mm
TP5: TCK; TestPoint_Pad_D1.0mm
TP6: TRST_N; TestPoint_Pad_D1.0mm
TP7: UART_TX; TestPoint_Pad_D1.0mm
U1: CYUSB3014-BZXI; TFBGA-121_10x10mm_Layout11x11_P0.8mm; LCSC C57294
U2: W25Q32JVSSIQ; SOIC-8_5.3x5.3mm_P1.27mm; LCSC C179173
Y1: 19.2MHz; Crystal_SMD_3225-4Pin_3.2x2.5mm; LCSC C358650

Connections:
+1V2: C1.1, C2.1, C3.1, C4.1, C5.1, FB1.1, FB2.1, U1.B10 (VDD), U1.C3 (VDD), U1.E9 (VDD), U1.F11 (VDD), U1.H1 (VDD), U1.J11 (VDD), U1.L5 (VDD), U1.L7 (VDD); also elsewhere on the board
+1V2_FX3A: C6.1, C7.1, FB1.2, U1.A7 (AVDD)
+1V2_FX3U3: C8.1, C9.1, C10.1, FB2.2, U1.A2 (U3RXVDDQ), U1.B5 (U3TXVDDQ)
+3V3: C11.1, C12.1, C13.1, C14.1, C15.1, C16.1, C17.1, C23.1, JP1.2 (B), R3.2, R4.2, R7.2, R8.2, R9.2, R12.2, R13.2, U1.B1 (VIO4), U1.B6 (CVDDQ), U1.C11 (VIO5), U1.E3 (VIO3), U1.F1 (VIO2), U1.H11 (VIO1), U1.L9 (VIO1), U2.8 (VCC); also elsewhere on the board
CH0_PWR_EN: U1.K1 (GPIO[35])
CH0_RST_N: U1.H2 (GPIO[39])
CH1_PWR_EN: U1.J2 (GPIO[36])
CH1_RST_N: U1.H3 (GPIO[40])
CH2_PWR_EN: U1.J3 (GPIO[37])
CH2_RST_N: U1.F4 (GPIO[41])
CH3_PWR_EN: U1.J1 (GPIO[38])
CH3_RST_N: U1.G2 (GPIO[42])
DC_IN_DET: U1.F2 (GPIO[45]); also elsewhere on the board
FLASH_CS_N: JP1.1 (A), R11.2, U2.1 (~CS)
FLASH_HOLD_N: R13.1, U2.7 (~HOLD/~RESET/IO_{3})
FLASH_WP_N: R12.1, U2.3 (~WP/IO_{2})
FPGA_CDONE: U1.J4 (GPIO[34]); also elsewhere on the board
FPGA_CRESET_B: U1.K2 (GPIO[33]); also elsewhere on the board
FPGA_SS_N: U1.D1 (GPIO[50]); also elsewhere on the board
FX3_INT_N: R7.1, U1.L8 (INT#)
FX3_LED: R10.1, U1.C4 (GPIO[57])
FX3_LED_K: D1.2 (A), R10.2
FX3_PMODE0: R4.1, U1.G4 (GPIO[30])
FX3_PMODE2: R5.1, U1.L4 (GPIO[32])
FX3_RESET_N: C22.1, R3.1, TP1.1, U1.C5 (RESET#)
FX3_R_USB2: R2.1, U1.C8 (R_USB2)
FX3_R_USB3: R1.1, U1.B3 (R_USB3)
FX3_SSTX_N: U1.A6 (SSTXM); also elsewhere on the board
FX3_SSTX_P: U1.A5 (SSTXP); also elsewhere on the board
FX3_TCK: TP5.1, U1.F6 (TCK)
FX3_TDI: TP2.1, U1.E7 (TDI)
FX3_TDO: TP3.1, U1.C10 (TDO)
FX3_TMS: TP4.1, U1.E8 (TMS)
FX3_TRST_N: R6.1, TP6.1, U1.B11 (TRST#)
FX3_UART_TX: TP7.1, U1.E5 (GPIO[48])
FX3_XTALIN: C20.1, U1.C6 (XTALIN), Y1.1
FX3_XTALOUT: C21.1, U1.C7 (XTALOUT), Y1.3
GND: C1.2, C2.2, C3.2, C4.2, C5.2, C6.2, C7.2, C8.2, C9.2, C10.2, C11.2, C12.2, C13.2, C14.2, C15.2, C16.2, C17.2, C18.2, C19.2, C20.2, C21.2, C22.2, C23.2, D1.1 (K), R1.2, R2.2, R5.2, R6.2, U1.A1 (U3VSSQ), U1.A8 (VSS), U1.B2 (FSLC[0]), U1.B4 (FSLC[1]), U1.B7 (AVSS), U1.B8 (VSS), U1.B9 (VSS), U1.D8 (VSS), U1.E2 (VSS), U1.E6 (FSLC[2]), U1.G1 (VSS), U1.G11 (VSS), U1.K3 (VSS), U1.K4 (VSS), U1.L1 (VSS), U1.L2 (VSS), U1.L3 (VSS), U1.L6 (VSS), U1.L11 (VSS), U2.4 (GND), Y1.2 (G), Y1.4 (G); also elsewhere on the board
GPIF_A0: U1.H5 (GPIO[29]); also elsewhere on the board
GPIF_A1: U1.J5 (GPIO[28]); also elsewhere on the board
GPIF_DQ0: U1.F10 (GPIO[0]); also elsewhere on the board
GPIF_DQ1: U1.F9 (GPIO[1]); also elsewhere on the board
GPIF_DQ2: U1.F7 (GPIO[2]); also elsewhere on the board
GPIF_DQ3: U1.G10 (GPIO[3]); also elsewhere on the board
GPIF_DQ4: U1.G9 (GPIO[4]); also elsewhere on the board
GPIF_DQ5: U1.F8 (GPIO[5]); also elsewhere on the board
GPIF_DQ6: U1.H10 (GPIO[6]); also elsewhere on the board
GPIF_DQ7: U1.H9 (GPIO[7]); also elsewhere on the board
GPIF_DQ8: U1.J10 (GPIO[8]); also elsewhere on the board
GPIF_DQ9: U1.J9 (GPIO[9]); also elsewhere on the board
GPIF_DQ10: U1.K11 (GPIO[10]); also elsewhere on the board
GPIF_DQ11: U1.L10 (GPIO[11]); also elsewhere on the board
GPIF_DQ12: U1.K10 (GPIO[12]); also elsewhere on the board
GPIF_DQ13: U1.K9 (GPIO[13]); also elsewhere on the board
GPIF_DQ14: U1.J8 (GPIO[14]); also elsewhere on the board
GPIF_DQ15: U1.G8 (GPIO[15]); also elsewhere on the board
GPIF_FLAGA: U1.G7 (GPIO[21]); also elsewhere on the board
GPIF_FLAGB: U1.G6 (GPIO[22]); also elsewhere on the board
GPIF_PCLK: U1.J6 (GPIO[16]); also elsewhere on the board
GPIF_PKTEND_N: U1.H8 (GPIO[24]); also elsewhere on the board
GPIF_SLCS_N: U1.K8 (GPIO[17]); also elsewhere on the board
GPIF_SLOE_N: U1.J7 (GPIO[19]); also elsewhere on the board
GPIF_SLRD_N: U1.H7 (GPIO[20]); also elsewhere on the board
GPIF_SLWR_N: U1.K7 (GPIO[18]); also elsewhere on the board
I2C_SCL: R8.1, U1.D9 (I2C_GPIO[58]); also elsewhere on the board
I2C_SDA: R9.1, U1.D10 (I2C_GPIO[59]); also elsewhere on the board
LNA_BYPASS: U1.G3 (GPIO[43]); also elsewhere on the board
SPI_MISO: U1.C2 (GPIO[55]), U2.2 (DO/IO_{1}); also elsewhere on the board
SPI_MOSI: U1.D5 (GPIO[56]), U2.5 (DI/IO_{0}); also elsewhere on the board
SPI_SCK: U1.D4 (GPIO[53]), U2.6 (CLK); also elsewhere on the board
SPI_SSN: R11.1, U1.C1 (GPIO[54])
USB_DM: U1.A10 (DM); also elsewhere on the board
USB_DP: U1.A9 (DP); also elsewhere on the board
USB_SSRX_N: U1.A3 (SSRXM); also elsewhere on the board
USB_SSRX_P: U1.A4 (SSRXP); also elsewhere on the board
VBUS: C18.1, C19.1, U1.E10 (VBATT), U1.E11 (VBUS); also elsewhere on the board

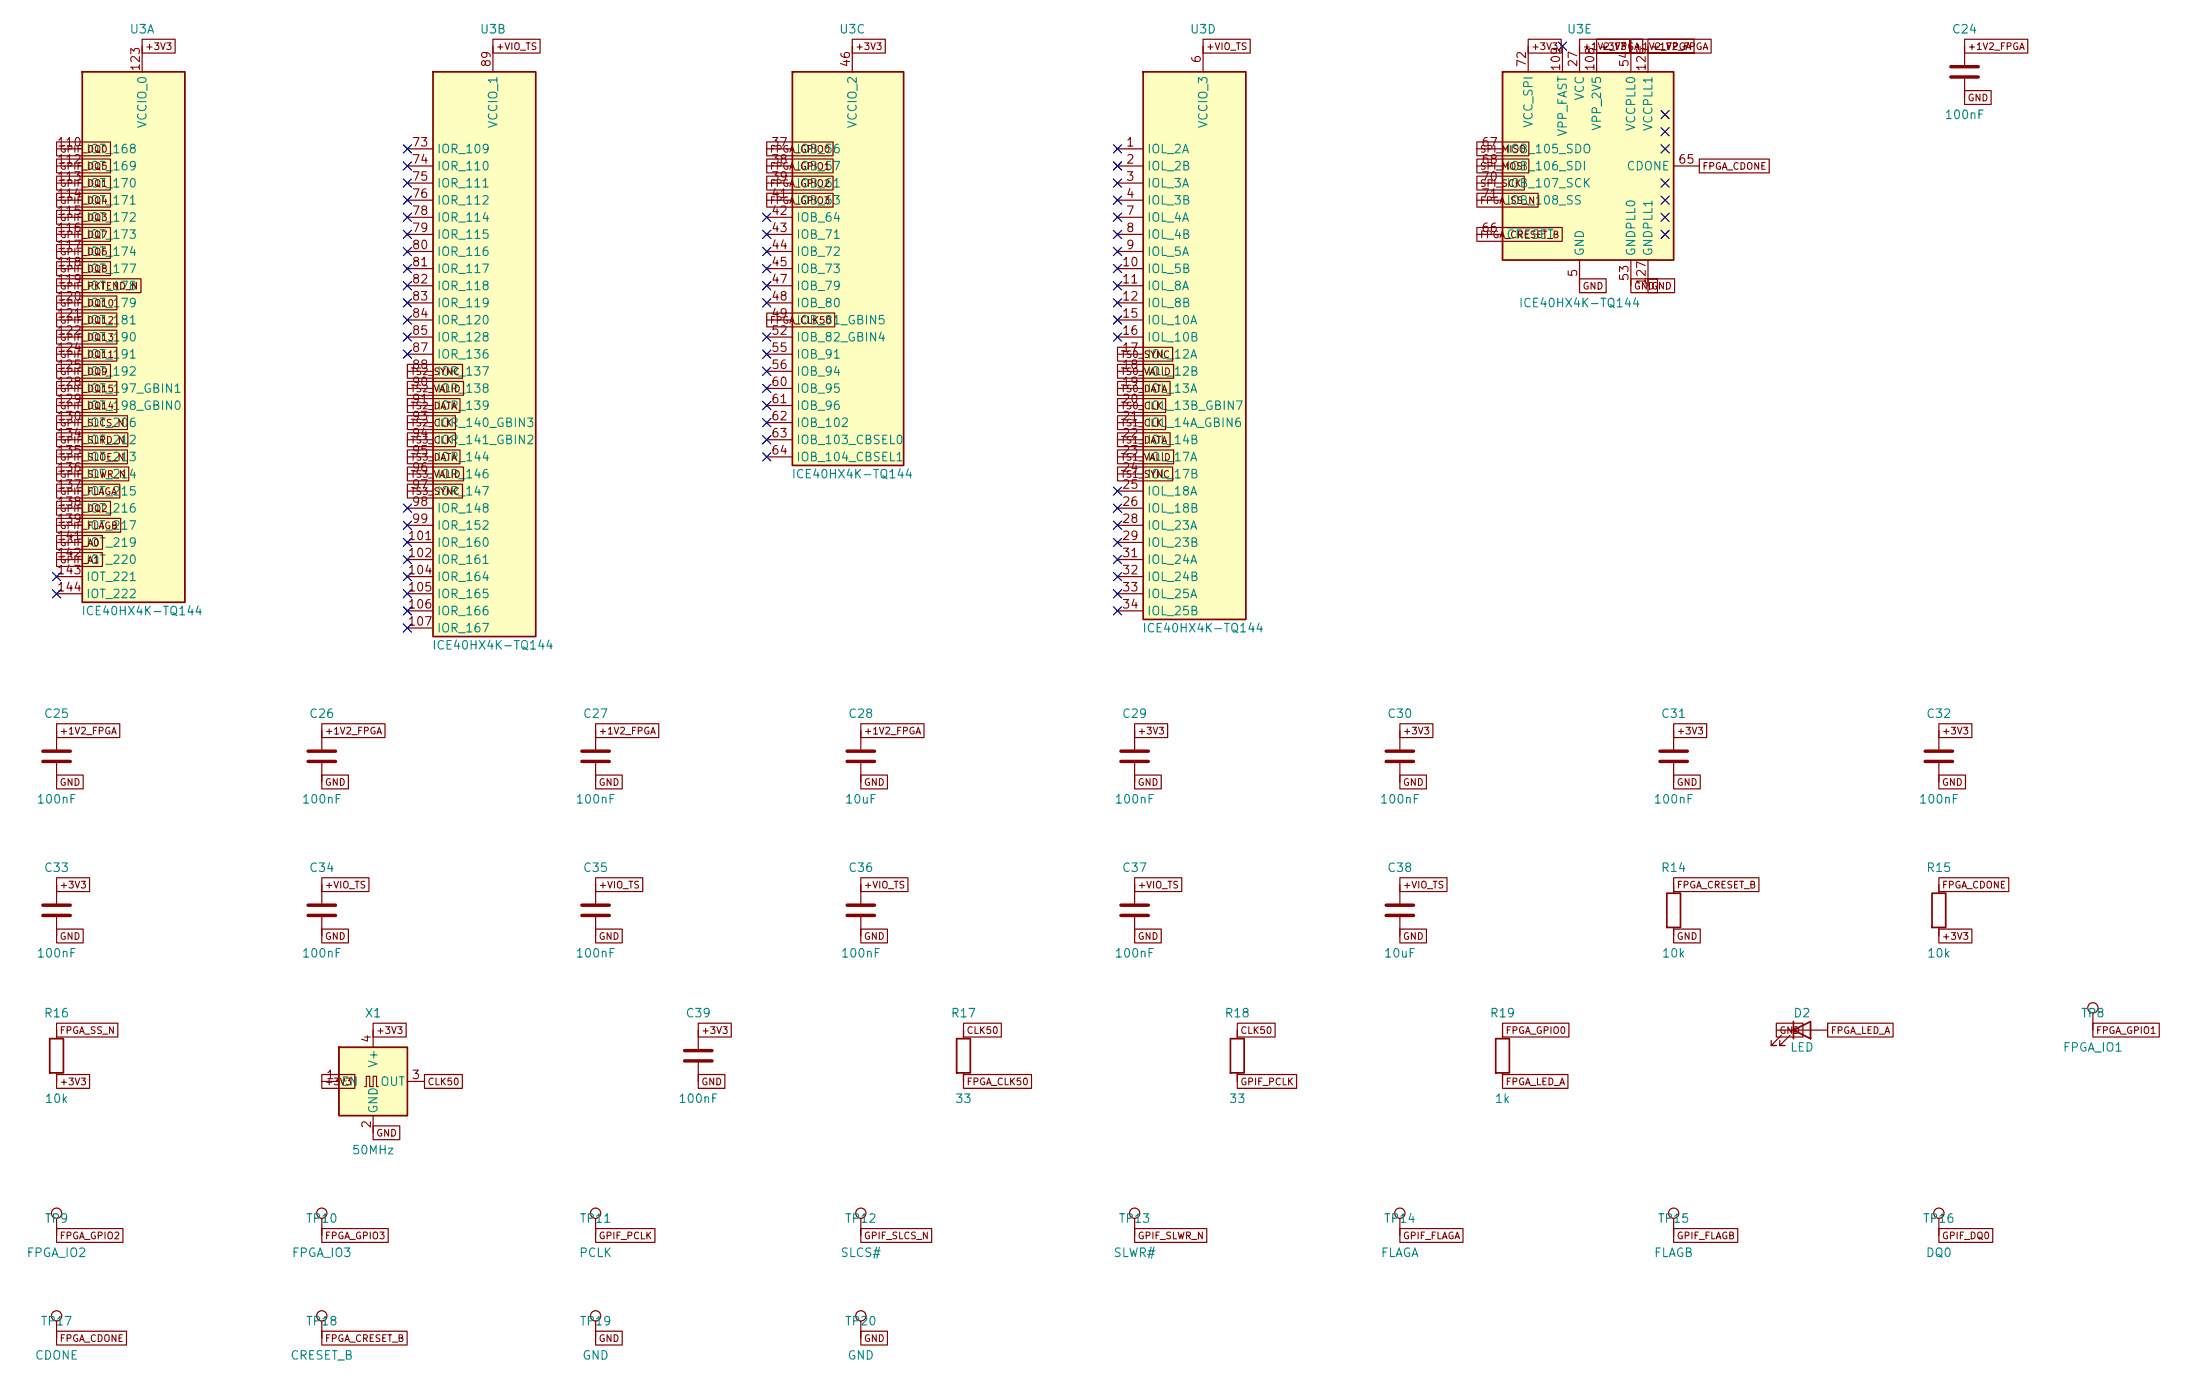
[picture p9: schematic fpga.kicad_sch, iCE40 FPGA (TS mux, GPIF writer)]

Parts:
C24, C25, C26, C27, C29, C30, C31, C32, C33, C34, C35, C36, C37, C39: 100nF; C_0402_1005Metric; LCSC C1525
C28, C38: 10uF; C_0603_1608Metric; LCSC C19702
D2: LED; LED_0603_1608Metric; LCSC C2286
R14, R15, R16: 10k; R_0402_1005Metric; LCSC C25744
R17, R18: 33; R_0402_1005Metric; LCSC C25105
R19: 1k; R_0402_1005Metric; LCSC C11702
TP8: FPGA_IO1; TestPoint_Pad_D1.0mm
TP9: FPGA_IO2; TestPoint_Pad_D1.0mm
TP10: FPGA_IO3; TestPoint_Pad_D1.0mm
TP11: PCLK; TestPoint_Pad_D1.0mm
TP12: SLCS#; TestPoint_Pad_D1.0mm
TP13: SLWR#; TestPoint_Pad_D1.0mm
TP14: FLAGA; TestPoint_Pad_D1.0mm
TP15: FLAGB; TestPoint_Pad_D1.0mm
TP16: DQ0; TestPoint_Pad_D1.0mm
TP17: CDONE; TestPoint_Pad_D1.0mm
TP18: CRESET_B; TestPoint_Pad_D1.0mm
TP19, TP20: GND; TestPoint_Pad_D1.0mm
U3: ICE40HX4K-TQ144; TQFP-144_20x20mm_P0.5mm; LCSC C1521989
X1: 50MHz; Oscillator_SMD_EuroQuartz_XO32-4Pin_3.2x2.5mm; LCSC C5203552

Connections:
+1V2_FPGA: C24.1, C25.1, C26.1, C27.1, C28.1, U3.27 (VCC), U3.40 (VCC), U3.54 (VCCPLL0), U3.92 (VCC), U3.111 (VCC), U3.126 (VCCPLL1); also elsewhere on the board
+3V3: C29.1, C30.1, C31.1, C32.1, C33.1, C39.1, R15.2, R16.2, U3.46 (VCCIO_2), U3.57 (VCCIO_2), U3.72 (VCC_SPI), U3.108 (VPP_2V5), U3.123 (VCCIO_0), U3.131 (VCCIO_0), X1.1 (EN), X1.4 (V+); also elsewhere on the board
+VIO_TS: C34.1, C35.1, C36.1, C37.1, C38.1, U3.6 (VCCIO_3), U3.30 (VCCIO_3), U3.89 (VCCIO_1), U3.100 (VCCIO_1); also elsewhere on the board
CLK50: R17.1, R18.1, X1.3 (OUT)
FPGA_CDONE: R15.1, TP17.1, U3.65 (CDONE); also elsewhere on the board
FPGA_CLK50: R17.2, U3.49 (IOB_81_GBIN5)
FPGA_CRESET_B: R14.1, TP18.1, U3.66 (~CRESET); also elsewhere on the board
FPGA_GPIO0: R19.1, U3.37 (IOB_56)
FPGA_GPIO1: TP8.1, U3.38 (IOB_57)
FPGA_GPIO2: TP9.1, U3.39 (IOB_61)
FPGA_GPIO3: TP10.1, U3.41 (IOB_63)
FPGA_LED_A: D2.2 (A), R19.2
FPGA_SS_N: R16.1, U3.71 (IOB_108_SS); also elsewhere on the board
GND: C24.2, C25.2, C26.2, C27.2, C28.2, C29.2, C30.2, C31.2, C32.2, C33.2, C34.2, C35.2, C36.2, C37.2, C38.2, C39.2, D2.1 (K), R14.2, TP19.1, TP20.1, U3.5 (GND), U3.13 (GND), U3.14 (GND), U3.53 (GNDPLL0), U3.59 (GND), U3.69 (GND), U3.86 (GND), U3.103 (GND), U3.127 (GNDPLL1), U3.132 (GND), U3.140 (GND), X1.2 (GND); also elsewhere on the board
GPIF_A0: U3.141 (IOT_219); also elsewhere on the board
GPIF_A1: U3.142 (IOT_220); also elsewhere on the board
GPIF_DQ0: TP16.1, U3.110 (IOT_168); also elsewhere on the board
GPIF_DQ1: U3.113 (IOT_170); also elsewhere on the board
GPIF_DQ2: U3.138 (IOT_216); also elsewhere on the board
GPIF_DQ3: U3.115 (IOT_172); also elsewhere on the board
GPIF_DQ4: U3.114 (IOT_171); also elsewhere on the board
GPIF_DQ5: U3.112 (IOT_169); also elsewhere on the board
GPIF_DQ6: U3.117 (IOT_174); also elsewhere on the board
GPIF_DQ7: U3.116 (IOT_173); also elsewhere on the board
GPIF_DQ8: U3.118 (IOT_177); also elsewhere on the board
GPIF_DQ9: U3.125 (IOT_192); also elsewhere on the board
GPIF_DQ10: U3.120 (IOT_179); also elsewhere on the board
GPIF_DQ11: U3.124 (IOT_191); also elsewhere on the board
GPIF_DQ12: U3.121 (IOT_181); also elsewhere on the board
GPIF_DQ13: U3.122 (IOT_190); also elsewhere on the board
GPIF_DQ14: U3.129 (IOT_198_GBIN0); also elsewhere on the board
GPIF_DQ15: U3.128 (IOT_197_GBIN1); also elsewhere on the board
GPIF_FLAGA: TP14.1, U3.137 (IOT_215); also elsewhere on the board
GPIF_FLAGB: TP15.1, U3.139 (IOT_217); also elsewhere on the board
GPIF_PCLK: R18.2, TP11.1; also elsewhere on the board
GPIF_PKTEND_N: U3.119 (IOT_178); also elsewhere on the board
GPIF_SLCS_N: TP12.1, U3.130 (IOT_206); also elsewhere on the board
GPIF_SLOE_N: U3.135 (IOT_213); also elsewhere on the board
GPIF_SLRD_N: U3.134 (IOT_212); also elsewhere on the board
GPIF_SLWR_N: TP13.1, U3.136 (IOT_214); also elsewhere on the board
SPI_MISO: U3.67 (IOB_105_SDO); also elsewhere on the board
SPI_MOSI: U3.68 (IOB_106_SDI); also elsewhere on the board
SPI_SCK: U3.70 (IOB_107_SCK); also elsewhere on the board
TS0_CLK: U3.20 (IOL_13B_GBIN7)
TS0_DATA: U3.19 (IOL_13A)
TS0_SYNC: U3.17 (IOL_12A)
TS0_VALID: U3.18 (IOL_12B)
TS1_CLK: U3.21 (IOL_14A_GBIN6)
TS1_DATA: U3.22 (IOL_14B)
TS1_SYNC: U3.24 (IOL_17B)
TS1_VALID: U3.23 (IOL_17A)
TS2_CLK: U3.93 (IOR_140_GBIN3)
TS2_DATA: U3.91 (IOR_139)
TS2_SYNC: U3.88 (IOR_137)
TS2_VALID: U3.90 (IOR_138)
TS3_CLK: U3.94 (IOR_141_GBIN2)
TS3_DATA: U3.95 (IOR_144)
TS3_SYNC: U3.97 (IOR_147)
TS3_VALID: U3.96 (IOR_146)

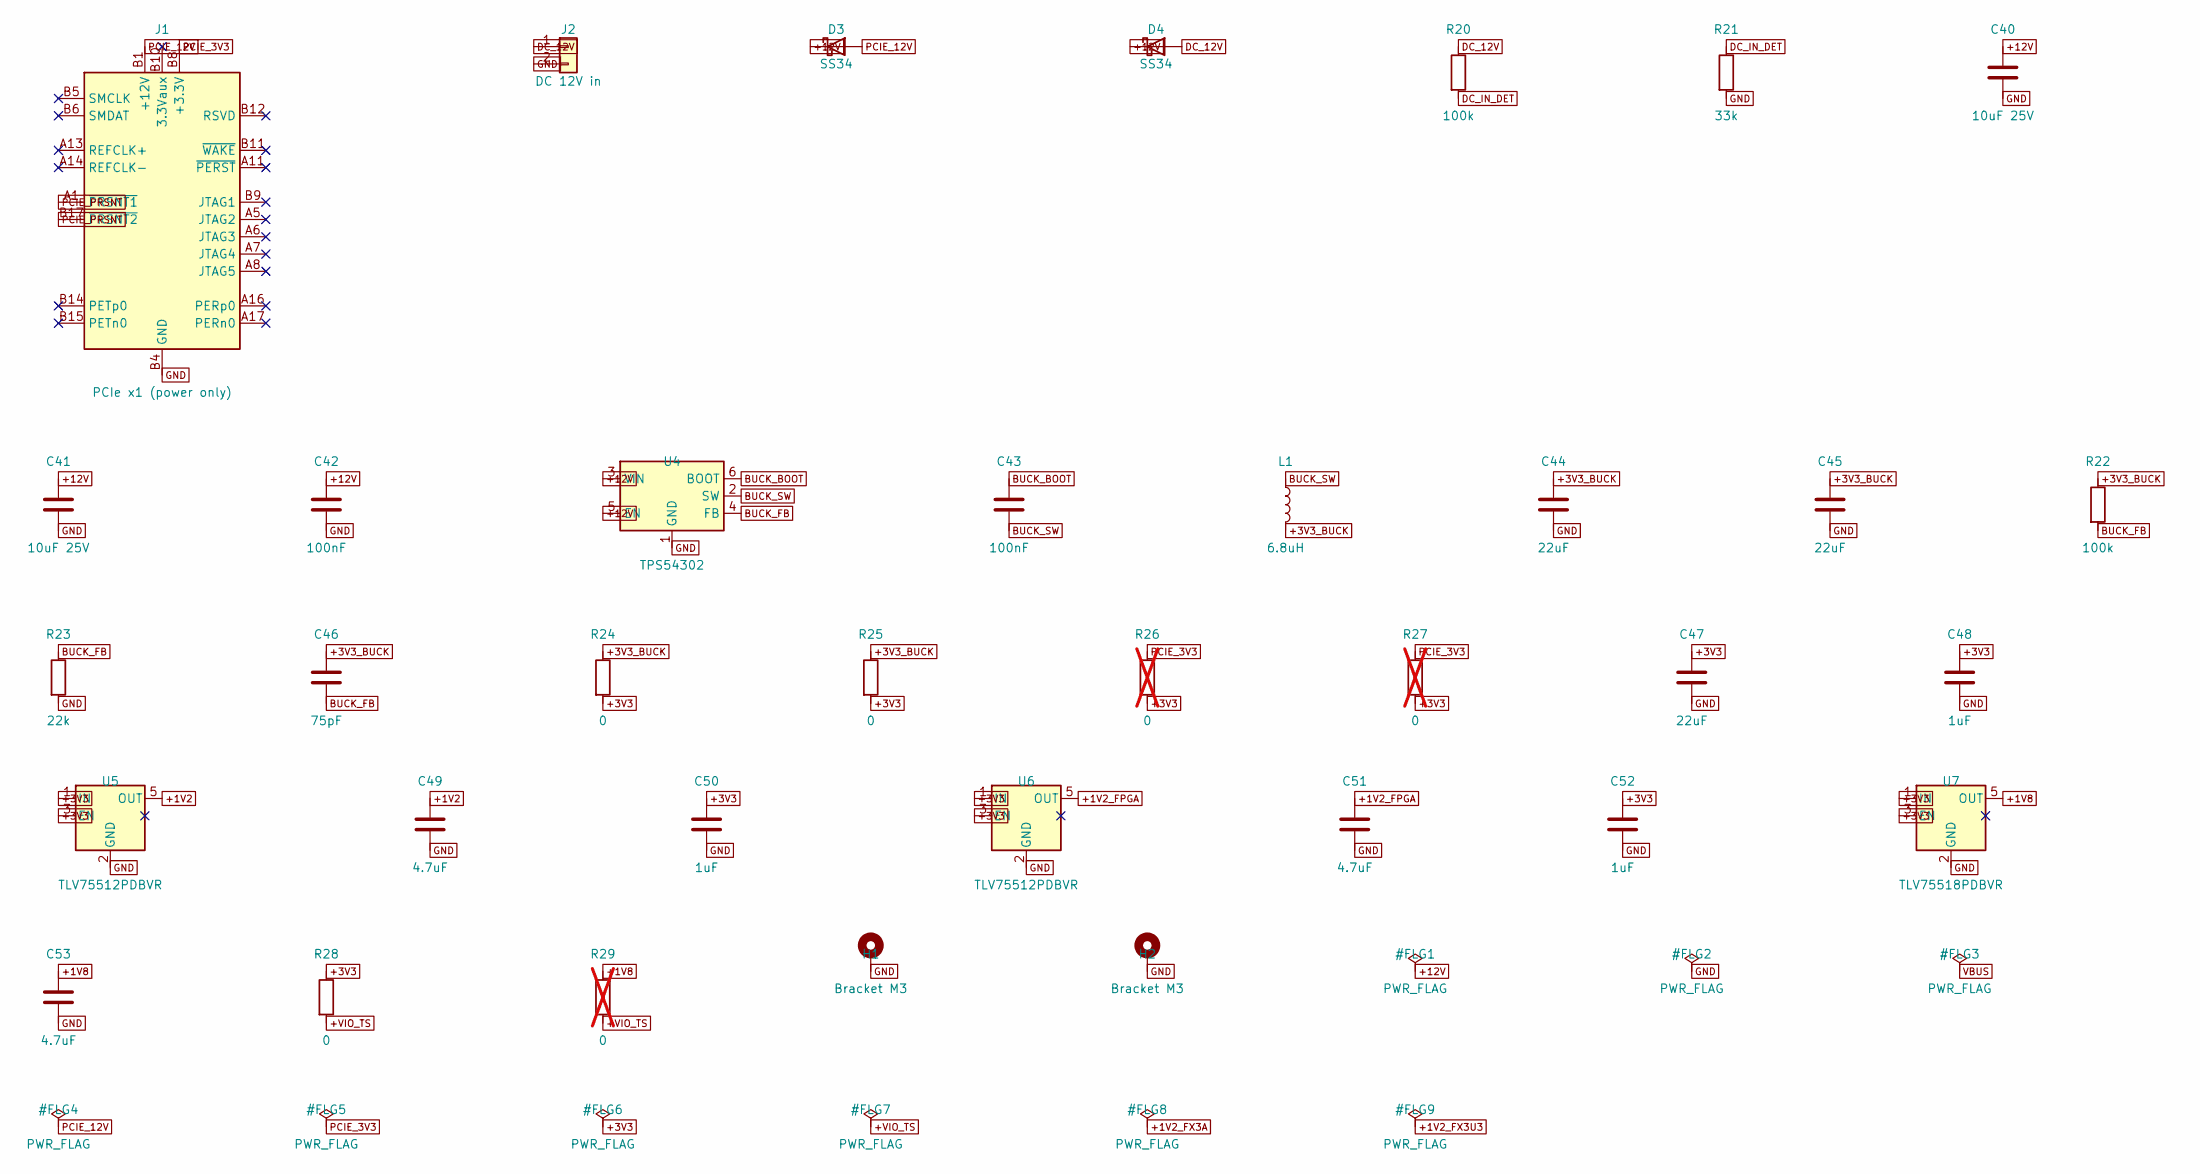
[picture p10: schematic power.kicad_sch, Power: PCIe/DC input, 3.3 V buck, LDOs]

Parts:
C40, C41: 10uF 25V; C_0805_2012Metric; LCSC C15850
C42, C43: 100nF; C_0402_1005Metric; LCSC C1525
C44, C45, C47: 22uF; C_0805_2012Metric; LCSC C45783
C46: 75pF; C_0402_1005Metric; LCSC C107010
C48, C50, C52: 1uF; C_0402_1005Metric; LCSC C52923
C49, C51, C53: 4.7uF; C_0402_1005Metric; LCSC C23733
D3, D4: SS34; D_SMA; LCSC C8678
H1, H2: Bracket M3; MountingHole_3.2mm_M3_Pad_Via
J1: PCIe x1 (power only); BUS_PCIexpress_x1
J2: DC 12V in; JST_XH_B2B-XH-A_1x02_P2.50mm_Vertical; LCSC C158012
L1: 6.8uH; L_6.3x6.3_H3; LCSC C354631
R20, R22: 100k; R_0402_1005Metric; LCSC C25741
R21: 33k; R_0402_1005Metric; LCSC C25779
R23: 22k; R_0402_1005Metric; LCSC C25768
R24, R25: 0; R_1206_3216Metric; LCSC C17888
R26, R27: 0; R_1206_3216Metric; LCSC C17888; not fitted
R28: 0; R_0402_1005Metric; LCSC C17168
R29: 0; R_0402_1005Metric; LCSC C17168; not fitted
U4: TPS54302; SOT-23-6; LCSC C311983
U5, U6: TLV75512PDBVR; SOT-23-5; LCSC C2877864
U7: TLV75518PDBVR; SOT-23-5; LCSC C2877863

Connections:
+1V2: C49.1, U5.5 (OUT); also elsewhere on the board
+1V2_FPGA: C51.1, U6.5 (OUT); also elsewhere on the board
+1V8: C53.1, R29.1, U7.5 (OUT)
+3V3: C47.1, C48.1, C50.1, C52.1, R24.2, R25.2, R26.2, R27.2, R28.1, U5.1 (IN), U5.3 (EN), U6.1 (IN), U6.3 (EN), U7.1 (IN), U7.3 (EN); also elsewhere on the board
+3V3_BUCK: C44.1, C45.1, C46.1, L1.2, R22.1, R24.1, R25.1
+12V: C40.1, C41.1, C42.1, D3.1 (K), D4.1 (K), U4.3 (VIN), U4.5 (EN)
+VIO_TS: R28.2, R29.2; also elsewhere on the board
BUCK_BOOT: C43.1, U4.6 (BOOT)
BUCK_FB: C46.2, R22.2, R23.1, U4.4 (FB)
BUCK_SW: C43.2, L1.1, U4.2 (SW)
DC_12V: D4.2 (A), J2.1, R20.1
DC_IN_DET: R20.2, R21.1; also elsewhere on the board
GND: C40.2, C41.2, C42.2, C44.2, C45.2, C47.2, C48.2, C49.2, C50.2, C51.2, C52.2, C53.2, H1.1, H2.1, J1.A4 (GND), J1.A12 (GND), J1.A15 (GND), J1.A18 (GND), J1.B4 (GND), J1.B7 (GND), J1.B13 (GND), J1.B16 (GND), J1.B18 (GND), J2.2, R21.2, R23.2, U4.1 (GND), U5.2 (GND), U6.2 (GND), U7.2 (GND); also elsewhere on the board
PCIE_3V3: J1.A9 (+3.3V), J1.A10 (+3.3V), J1.B8 (+3.3V), R26.1, R27.1
PCIE_12V: D3.2 (A), J1.A2 (+12V), J1.A3 (+12V), J1.B1 (+12V), J1.B2 (+12V), J1.B3 (+12V)
PCIE_PRSNT: J1.A1 (~PRSNT1), J1.B17 (~PRSNT2)
