nanashima4268/otr-4ts3-u1/hw/kicad/otr-4ts3-u1.kicad_pcb

## KiCad design hw/kicad/otr-4ts3-u1.kicad_pcb (continued)

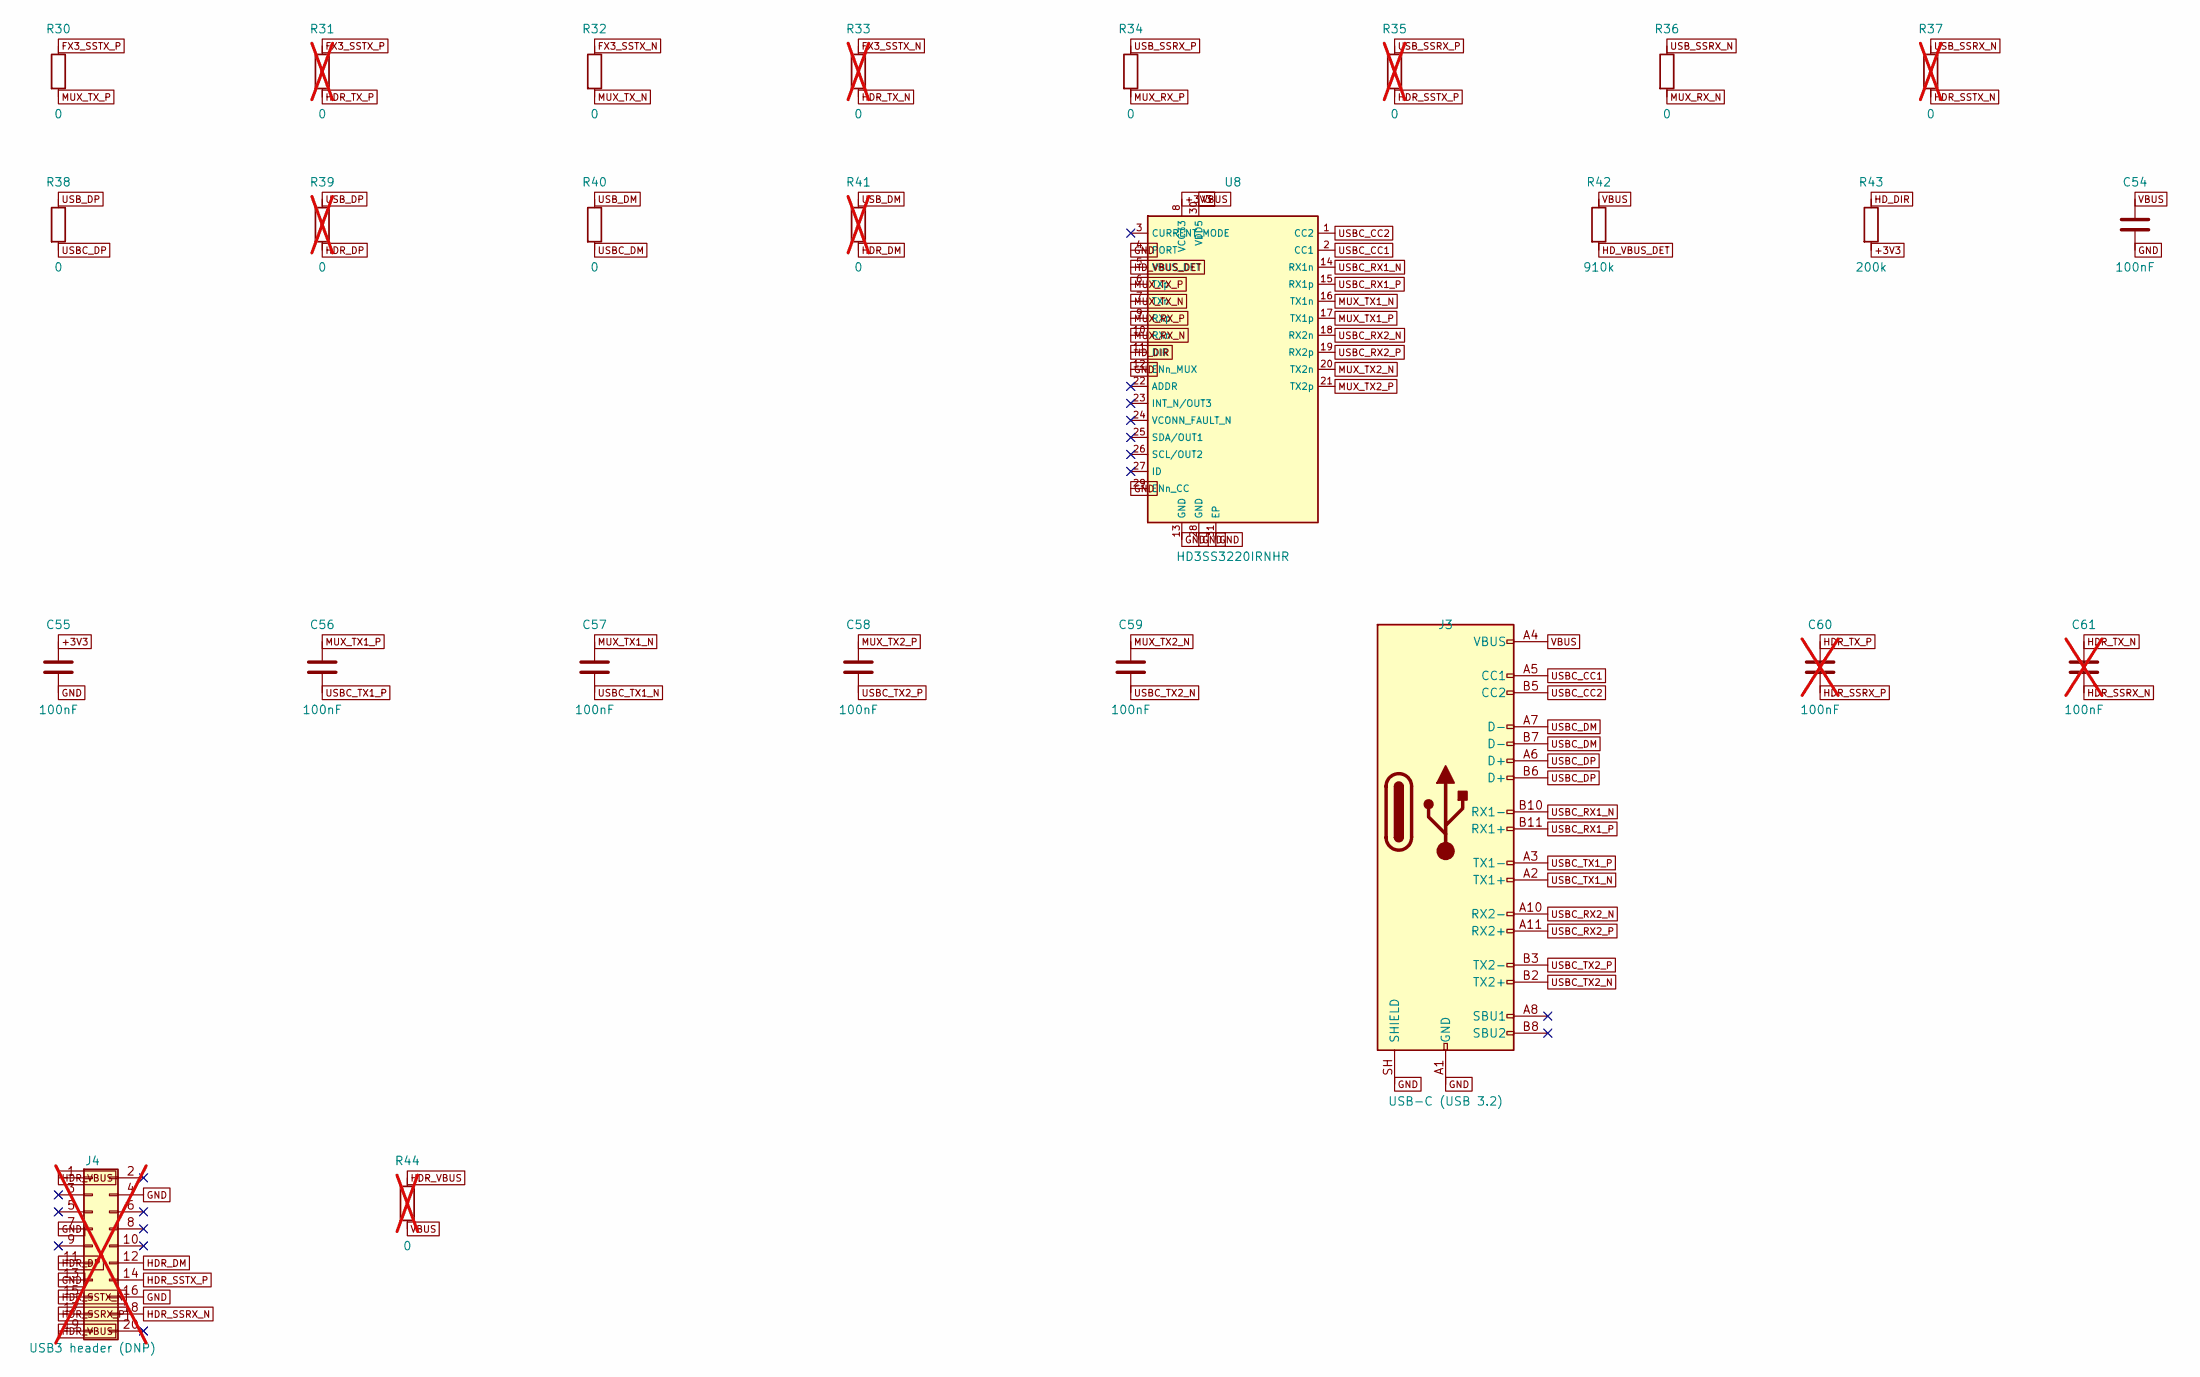
[picture p11: schematic usb.kicad_sch, USB: Type-C with SS switch, internal USB3 header]

Parts:
C54, C55, C56, C57, C58, C59: 100nF; C_0402_1005Metric; LCSC C1525
C60, C61: 100nF; C_0402_1005Metric; LCSC C1525; not fitted
J3: USB-C (USB 3.2); USB_C_Receptacle_SameSky_UJ32-C-H-G-H2-SMT; LCSC C22359755
J4: USB3 header (DNP); PinHeader_2x10_P2.00mm_Vertical; not fitted
R30, R32, R34, R36, R38, R40: 0; R_0402_1005Metric; LCSC C17168
R31, R33, R35, R37, R39, R41, R44: 0; R_0402_1005Metric; LCSC C17168; not fitted
R42: 910k; R_0402_1005Metric; LCSC C2909391
R43: 200k; R_0402_1005Metric; LCSC C25764
U8: HD3SS3220IRNHR; Texas_RNH0030A_WQFN-30-1EP_2.5x4.5mm_P0.4mm_EP1.2x3.2mm; LCSC C701817

Connections:
+3V3: C55.1, R43.2, U8.8 (VCC33); also elsewhere on the board
FX3_SSTX_N: R32.1, R33.1; also elsewhere on the board
FX3_SSTX_P: R30.1, R31.1; also elsewhere on the board
GND: C54.2, C55.2, J3.A1 (GND), J3.A12 (GND), J3.B1 (GND), J3.B12 (GND), J3.SH (SHIELD), J4.4, J4.7, J4.13, J4.16, U8.4 (PORT), U8.12 (ENn_MUX), U8.13 (GND), U8.28 (GND), U8.29 (ENn_CC), U8.31 (EP); also elsewhere on the board
HDR_DM: J4.12, R41.2
HDR_DP: J4.11, R39.2
HDR_SSRX_N: C61.2, J4.18
HDR_SSRX_P: C60.2, J4.17
HDR_SSTX_N: J4.15, R37.2
HDR_SSTX_P: J4.14, R35.2
HDR_TX_N: C61.1, R33.2
HDR_TX_P: C60.1, R31.2
HDR_VBUS: J4.1, J4.19, R44.1
HD_DIR: R43.1, U8.11 (DIR)
HD_VBUS_DET: R42.2, U8.5 (VBUS_DET)
MUX_RX_N: R36.2, U8.10 (RXn)
MUX_RX_P: R34.2, U8.9 (RXp)
MUX_TX1_N: C57.1, U8.16 (TX1n)
MUX_TX1_P: C56.1, U8.17 (TX1p)
MUX_TX2_N: C59.1, U8.20 (TX2n)
MUX_TX2_P: C58.1, U8.21 (TX2p)
MUX_TX_N: R32.2, U8.7 (TXn)
MUX_TX_P: R30.2, U8.6 (TXp)
USBC_CC1: J3.A5 (CC1), U8.2 (CC1)
USBC_CC2: J3.B5 (CC2), U8.1 (CC2)
USBC_DM: J3.A7 (D-), J3.B7 (D-), R40.2
USBC_DP: J3.A6 (D+), J3.B6 (D+), R38.2
USBC_RX1_N: J3.B10 (RX1-), U8.14 (RX1n)
USBC_RX1_P: J3.B11 (RX1+), U8.15 (RX1p)
USBC_RX2_N: J3.A10 (RX2-), U8.18 (RX2n)
USBC_RX2_P: J3.A11 (RX2+), U8.19 (RX2p)
USBC_TX1_N: C57.2, J3.A2 (TX1+)
USBC_TX1_P: C56.2, J3.A3 (TX1-)
USBC_TX2_N: C59.2, J3.B2 (TX2+)
USBC_TX2_P: C58.2, J3.B3 (TX2-)
USB_DM: R40.1, R41.1; also elsewhere on the board
USB_DP: R38.1, R39.1; also elsewhere on the board
USB_SSRX_N: R36.1, R37.1; also elsewhere on the board
USB_SSRX_P: R34.1, R35.1; also elsewhere on the board
VBUS: C54.1, J3.A4 (VBUS), J3.A9 (VBUS), J3.B4 (VBUS), J3.B9 (VBUS), R42.1, R44.2, U8.30 (VDD5); also elsewhere on the board

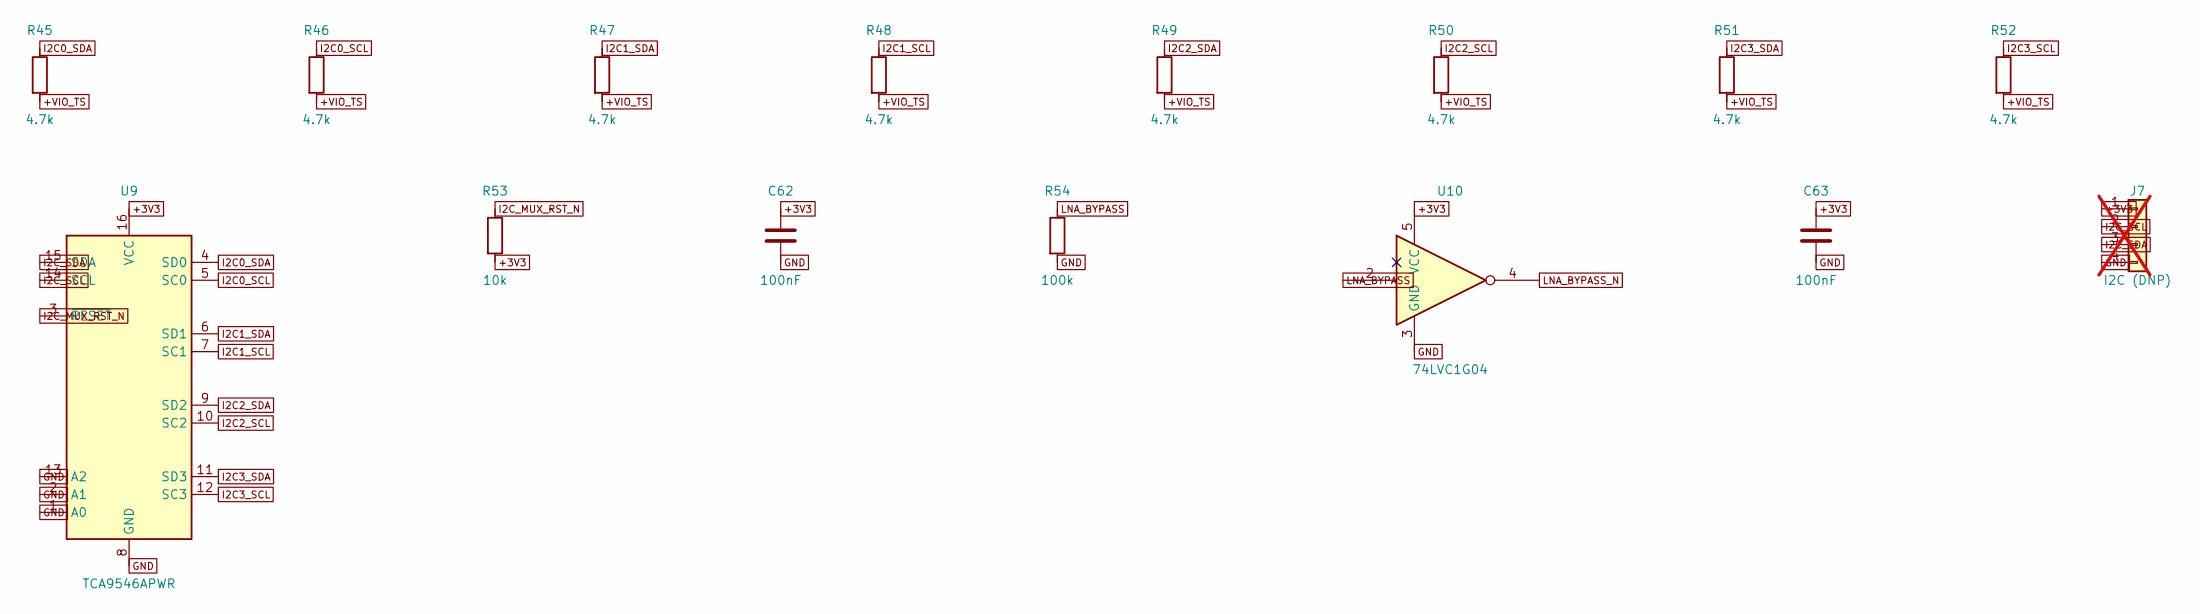
[picture p12: schematic control.kicad_sch, I2C mux, LNA bypass control]

Parts:
C62, C63: 100nF; C_0402_1005Metric; LCSC C1525
J7: I2C (DNP); PinHeader_1x04_P2.54mm_Vertical; not fitted
R45, R46, R47, R48, R49, R50, R51, R52: 4.7k; R_0402_1005Metric; LCSC C25900
R53: 10k; R_0402_1005Metric; LCSC C25744
R54: 100k; R_0402_1005Metric; LCSC C25741
U9: TCA9546APWR; TSSOP-16_4.4x5mm_P0.65mm; LCSC C201653
U10: 74LVC1G04; SOT-353_SC-70-5; LCSC C264081

Connections:
+3V3: C62.1, C63.1, J7.1, R53.2, U9.16 (VCC), U10.5 (VCC); also elsewhere on the board
+VIO_TS: R45.2, R46.2, R47.2, R48.2, R49.2, R50.2, R51.2, R52.2; also elsewhere on the board
GND: C62.2, C63.2, J7.4, R54.2, U9.1 (A0), U9.2 (A1), U9.8 (GND), U9.13 (A2), U10.3 (GND); also elsewhere on the board
I2C0_SCL: R46.1, U9.5 (SC0)
I2C0_SDA: R45.1, U9.4 (SD0)
I2C1_SCL: R48.1, U9.7 (SC1)
I2C1_SDA: R47.1, U9.6 (SD1)
I2C2_SCL: R50.1, U9.10 (SC2)
I2C2_SDA: R49.1, U9.9 (SD2)
I2C3_SCL: R52.1, U9.12 (SC3)
I2C3_SDA: R51.1, U9.11 (SD3)
I2C_MUX_RST_N: R53.1, U9.3 (~RESET)
I2C_SCL: J7.2, U9.14 (SCL); also elsewhere on the board
I2C_SDA: J7.3, U9.15 (SDA); also elsewhere on the board
LNA_BYPASS: R54.1, U10.2; also elsewhere on the board
LNA_BYPASS_N: U10.4; also elsewhere on the board

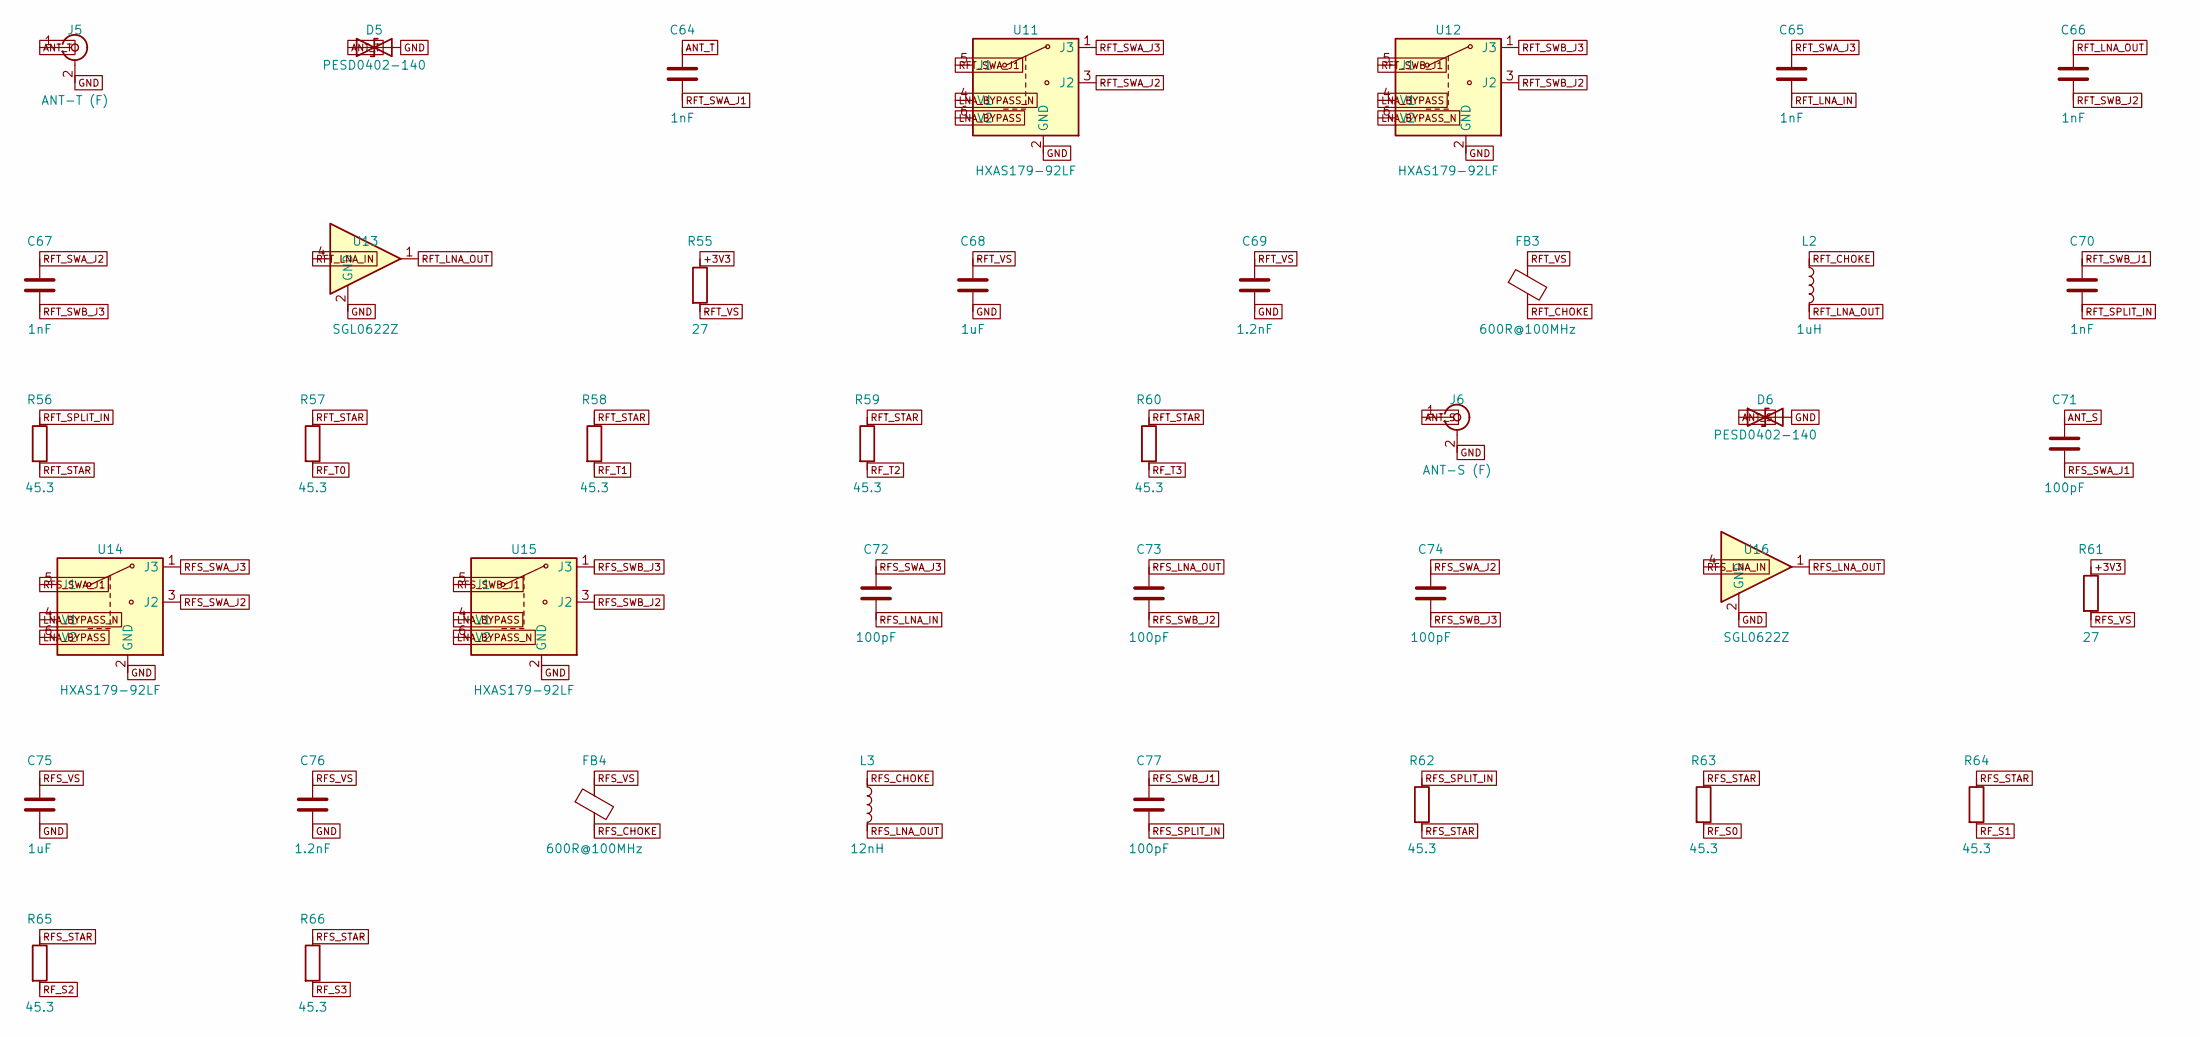
[picture p13: schematic rf.kicad_sch, RF front end: F jacks, LNA with bypass, 4-way splitters]

Parts:
C64, C65, C66, C67, C70: 1nF; C_0402_1005Metric; LCSC C1523
C68, C75: 1uF; C_0402_1005Metric; LCSC C52923
C69, C76: 1.2nF; C_0402_1005Metric; LCSC C3010430
C71, C72, C73, C74, C77: 100pF; C_0402_1005Metric; LCSC C1546
D5, D6: PESD0402-140; D_0402_1005Metric; LCSC C10662
FB3, FB4: 600R@100MHz; L_0402_1005Metric; LCSC C76890
J5: ANT-T (F); F_Female_DOSIN_DS803FPR0016_Horizontal; LCSC C2979612
J6: ANT-S (F); F_Female_DOSIN_DS803FPR0016_Horizontal; LCSC C2979612
L2: 1uH; L_0603_1608Metric; LCSC C98326
L3: 12nH; L_0402_1005Metric; LCSC C77104
R55, R61: 27; R_0402_1005Metric; LCSC C25156
R56, R57, R58, R59, R60, R62, R63, R64, R65, R66: 45.3; R_0402_1005Metric; LCSC C5126226
U11, U12, U14, U15: HXAS179-92LF; SOT-363_SC-70-6; LCSC C49010110
U13, U16: SGL0622Z; DFN-8-1EP_2x2mm_P0.5mm_EP0.9x1.6mm; LCSC C470895

Connections:
+3V3: R55.1, R61.1; also elsewhere on the board
ANT_S: C71.1, D6.1 (A1), J6.1 (In)
ANT_T: C64.1, D5.1 (A1), J5.1 (In)
GND: C68.2, C69.2, C75.2, C76.2, D5.2 (A2), D6.2 (A2), J5.2 (Ext), J6.2 (Ext), U11.2 (GND), U12.2 (GND), U13.2 (GND), U13.3 (GND), U13.5 (GND), U13.6 (GND), U13.7 (GND), U13.8 (GND), U13.9 (GND), U14.2 (GND), U15.2 (GND), U16.2 (GND), U16.3 (GND), U16.5 (GND), U16.6 (GND), U16.7 (GND), U16.8 (GND), U16.9 (GND); also elsewhere on the board
LNA_BYPASS: U11.6 (V2), U12.4 (V1), U14.6 (V2), U15.4 (V1); also elsewhere on the board
LNA_BYPASS_N: U11.4 (V1), U12.6 (V2), U14.4 (V1), U15.6 (V2); also elsewhere on the board
RFS_CHOKE: FB4.2, L3.1
RFS_LNA_IN: C72.2, U16.4
RFS_LNA_OUT: C73.1, L3.2, U16.1
RFS_SPLIT_IN: C77.2, R62.1
RFS_STAR: R62.2, R63.1, R64.1, R65.1, R66.1
RFS_SWA_J1: C71.2, U14.5 (J1)
RFS_SWA_J2: C74.1, U14.3 (J2)
RFS_SWA_J3: C72.1, U14.1 (J3)
RFS_SWB_J1: C77.1, U15.5 (J1)
RFS_SWB_J2: C73.2, U15.3 (J2)
RFS_SWB_J3: C74.2, U15.1 (J3)
RFS_VS: C75.1, C76.1, FB4.1, R61.2
RFT_CHOKE: FB3.2, L2.1
RFT_LNA_IN: C65.2, U13.4
RFT_LNA_OUT: C66.1, L2.2, U13.1
RFT_SPLIT_IN: C70.2, R56.1
RFT_STAR: R56.2, R57.1, R58.1, R59.1, R60.1
RFT_SWA_J1: C64.2, U11.5 (J1)
RFT_SWA_J2: C67.1, U11.3 (J2)
RFT_SWA_J3: C65.1, U11.1 (J3)
RFT_SWB_J1: C70.1, U12.5 (J1)
RFT_SWB_J2: C66.2, U12.3 (J2)
RFT_SWB_J3: C67.2, U12.1 (J3)
RFT_VS: C68.1, C69.1, FB3.1, R55.2
RF_S0: R63.2
RF_S1: R64.2
RF_S2: R65.2
RF_S3: R66.2
RF_T0: R57.2
RF_T1: R58.2
RF_T2: R59.2
RF_T3: R60.2

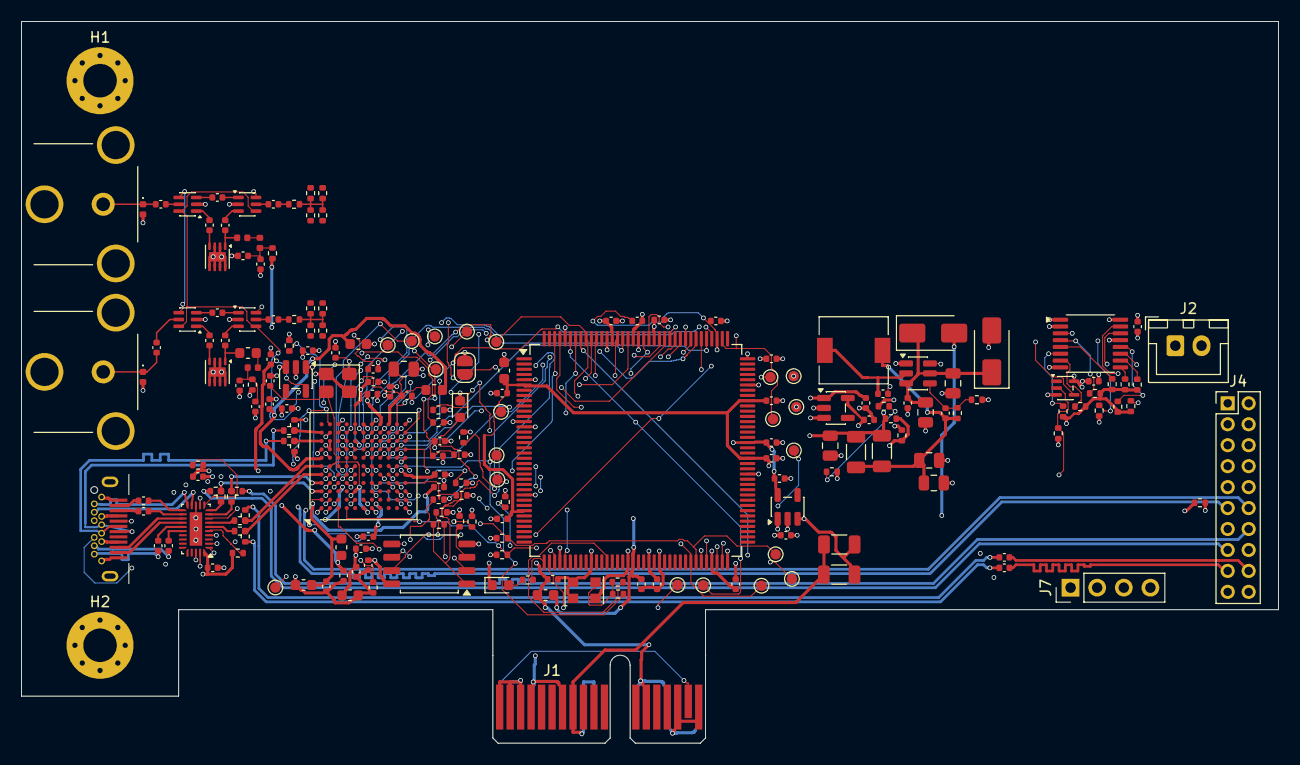
[picture p14: board otr-4ts3-u1.kicad_pcb from above]

Board: 6 copper layers, 120.0 x 68.9 mm, 204 parts (0 on the bottom side), 154 nets.
