nanashima4268/otr-4ts3-u1/fpga/syn/otr_top.pcf

# Generated by hw/gen/design.py from the schematic pin plan; do not edit.
# iCE40HX4K-TQ144 (nextpnr: --hx8k --package tq144:4k).
set_io dq[0] 110
set_io dq[5] 112
set_io dq[1] 113
set_io dq[4] 114
set_io dq[3] 115
set_io dq[7] 116
set_io dq[6] 117
set_io dq[8] 118
set_io pktend_n 119
set_io dq[10] 120
set_io dq[12] 121
set_io dq[13] 122
set_io dq[11] 124
set_io dq[9] 125
set_io dq[15] 128
set_io dq[14] 129
set_io slcs_n 130
set_io slrd_n 134
set_io sloe_n 135
set_io slwr_n 136
set_io flaga 137
set_io dq[2] 138
set_io flagb 139
set_io fifo_addr[0] 141
set_io fifo_addr[1] 142
set_io ts_clk[0] 20
set_io ts_data[0] 19
set_io ts_valid[0] 18
set_io ts_sync[0] 17
set_io ts_clk[1] 21
set_io ts_data[1] 22
set_io ts_valid[1] 23
set_io ts_sync[1] 24
set_io ts_clk[2] 93
set_io ts_data[2] 91
set_io ts_valid[2] 90
set_io ts_sync[2] 88
set_io ts_clk[3] 94
set_io ts_data[3] 95
set_io ts_valid[3] 96
set_io ts_sync[3] 97
set_io clk 49
set_io gpio_out[0] 37
set_io gpio_out[1] 38
set_io gpio_out[2] 39
set_io gpio_out[3] 41
set_io spi_miso 67
set_io spi_mosi 68
set_io spi_sck 70
set_io spi_ss_n 71
