nanashima4268/otr-4ts3-u1/hw/gen/rules.py

# SPDX-License-Identifier: CERN-OHL-S-2.0
"""Design rules and net classes for OTR-4TS3-U1 (JLC06161H-7628, D-75).

Trace geometry from a 2D quasi-static field solve of the outer-layer
cross-section (prepreg 0.2104 mm, er 4.4, 1 oz copper, solder mask er 3.8,
reference plane L2 for the top and L5 for the bottom; the 6-layer stack has
the same outer prepreg as the 4-layer JLC04161H-7628 of D-69):
50 ohm = 0.355 mm (sanity check), 75 ohm microstrip = 0.145 mm, 90 ohm differential = 0.263 mm wide / 0.15 mm gap.
JLC limits (capabilities page, 2026-11): track/space 0.09 mm, vias free
from a 0.3 mm hole / 0.45 mm diameter (4 and 6 layers; smaller holes are a paid
option, JLC quote 2026-11-02, D-72), copper to routed edge 0.2 mm,
pad hole to pad hole 0.45 mm, silkscreen 0.15 mm line / 1.0 mm text.
"""
import json

# name: (track, clearance, diff width, diff gap), patterns (KiCad wildcards)
CLASSES = {
    "USB_90": ((0.263, 0.15, 0.263, 0.15),
               ["FX3_SSTX_*", "USB_SSRX_*", "MUX_TX*", "MUX_RX*", "USBC_TX*", "USBC_RX*",
                "HDR_SS*", "HDR_TX_*", "USB_DP", "USB_DM", "USBC_DP", "USBC_DM", "HDR_DP", "HDR_DM"]),
    # 75 ohm microstrip; ground pours are kept ~3 widths away by the custom rule
    # below (a class clearance would also hit the parts' own fine-pitch pads)
    "RF_75": ((0.145, 0.15, 0.145, 0.2),
              ["ANT_*", "RF_T*", "RF_S*", "RFT_SW*", "RFS_SW*", "RFT_LNA_*", "RFS_LNA_*",
               "RFT_SPLIT_IN", "RFS_SPLIT_IN", "RFT_STAR", "RFS_STAR"]),
    # signal and supply tracks as Freerouting draws them (autoroute.py, D-74):
    # 0.1 mm tracks with 0.1 mm clearance pass between the BGA fan-out vias
    "POWER": ((0.3, 0.1, 0.2, 0.25),
              ["+*", "PCIE_12V", "PCIE_3V3", "DC_12V", "VBUS", "BUCK_SW", "HDR_VBUS"]),
    "GPIF": ((0.1, 0.1, 0.1, 0.1), ["GPIF_*"]),
}
DEFAULT = dict(track_width=0.1, clearance=0.1, via_diameter=0.45, via_drill=0.3,
               diff_pair_width=0.2, diff_pair_gap=0.2)
# board minimums are low so that the custom rules below decide (free-size vias
# only; the USB-C row B is the maker's layout)
MINIMUMS = dict(min_clearance=0.1, min_track_width=0.09, min_via_diameter=0.3,
                min_via_annular_width=0.075, min_through_hole_diameter=0.15, min_hole_to_hole=0.2,
                min_hole_clearance=0.2, min_copper_edge_clearance=0.3, min_silk_clearance=0.0,
                min_text_height=1.0, min_text_thickness=0.15)

DRU = """(version 1)
# header-option 0 ohm links share the FX3-side pad of the fitted link (usb.py, D-70)
(rule "shared-pad 0 ohm selectors"
  (condition "(A.Reference == 'R30' && B.Reference == 'R31') || (A.Reference == 'R32' && B.Reference == 'R33') || (A.Reference == 'R34' && B.Reference == 'R35') || (A.Reference == 'R36' && B.Reference == 'R37') || (A.Reference == 'R38' && B.Reference == 'R39') || (A.Reference == 'R40' && B.Reference == 'R41')")
  (constraint courtyard_clearance (min -1mm)))
# JLCPCB (6 layers, 1 oz outer) limits that KiCad's global settings do not cover
(rule "free-size vias everywhere else (JLC 6 layers: 0.3 mm hole, 0.45 mm diameter)"
  (condition "A.Type == 'Via' && A.Hole >= 0.2mm")
  (constraint hole_size (min 0.3mm))
  (constraint via_diameter (min 0.45mm)))
(rule "no small vias (paid option; D-73 replaced the USB-C that needed them)"
  (condition "A.Type == 'Via' && A.Hole < 0.2mm")
  (constraint disallow via))
(rule "pad hole to pad hole (JLC 0.45 mm)"
  (condition "A.Type == 'Pad' && B.Type == 'Pad' && A.Pad_Type == 'Through-hole' && B.Pad_Type == 'Through-hole'")
  (constraint hole_to_hole (min 0.45mm)))
# the USB-C's row-B sub-rows are staggered 0.81 mm apart (maker's layout,
# 0.40 mm drills): checked with JLC at ordering (D-73)
(rule "USB-C row B (maker's layout)"
  (condition "A.Type == 'Pad' && B.Type == 'Pad' && A.Parent == 'J3' && B.Parent == 'J3'")
  (constraint hole_to_hole (min 0.35mm))
  (constraint clearance (min 0.1mm)))
(rule "USB-C locating holes (maker's layout)"
  (condition "A.Parent == 'J3'")
  (constraint edge_clearance (min 0.2mm)))
(rule "BGA fan-out (JLC allows 0.09 mm near BGA pads)"
  (condition "A.intersectsCourtyard('U1')")
  (constraint clearance (min 0.09mm)))
# webs of the In3 +1V2 plane between the 0.8 mm-pitch fan-out vias (D-71):
# 0.8 - 0.45 - 2 x 0.12 = 0.11 mm >= the island's 0.1 mm minimum width
# tracks between the 0.8 mm-pitch fan-out vias: a centred 0.1 mm track keeps
# exactly 0.2 mm from the 0.3 mm holes, the router's tracks sit up to 0.025 mm
# off centre (autoroute.py, D-74); checked with JLC's DFM at ordering
(rule "BGA fan-out hole clearance"
  (condition "A.intersectsCourtyard('U1') || B.intersectsCourtyard('U1')")
  (constraint hole_clearance (min 0.17mm)))
(rule "planes between the BGA fan-out vias"
  (condition "(A.Type == 'Zone' && B.intersectsCourtyard('U1')) || (B.Type == 'Zone' && A.intersectsCourtyard('U1'))")
  (constraint clearance (min 0.12mm)))
(rule "RF 75 ohm keeps copper pours away"
  (condition "A.NetClass == 'RF_75' && B.Type == 'Zone'")
  (constraint clearance (min 0.45mm)))
"""


def apply(pro_path, dru_path):
    pro = json.load(open(pro_path))
    ns = pro.setdefault("net_settings", {})
    base = ns["classes"][0] if ns.get("classes") else {}
    base = dict(base, name="Default", **DEFAULT)
    classes = [base]
    patterns = []
    for i, (name, ((tw, cl, dw, dg), pats)) in enumerate(CLASSES.items()):
        c = dict(base, name=name, track_width=tw, clearance=cl, diff_pair_width=dw,
                 diff_pair_gap=dg, priority=i)
        classes.append(c)
        patterns += [{"netclass": name, "pattern": p} for p in pats]
    ns["classes"] = classes
    ns["netclass_patterns"] = patterns
    rules = pro["board"]["design_settings"]["rules"]
    rules.update(MINIMUMS)
    json.dump(pro, open(pro_path, "w"), indent=2, ensure_ascii=False)
    open(dru_path, "w").write(DRU)
