nanashima4268/otr-4ts3-u1/(commit log)

2026-10-31 Initial research, decisions, and design-prep docs for OTR-4TS3-U1
    Reference-board analysis (DTV02A-4TS-P), chip/standard research,
    architecture (iCE40HX4K + FX3), measurement procedure, BOM candidates,
    pre-verification plan, license texts, and repo skeleton.
    Claude-Session: https://claude.ai/code/session_019yYQdhHczvp4YvZfTXzFaD
2026-10-31 Add S0 baseline, pve-old downtime plan for reference-board measurement
    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
2026-11-01 Add FX3 slave FIFO writer with buffer-count flow control; fix FIFO wrap compare bug
    The pointer-difference comparisons in ts_pkt_fifo were evaluated in 32-bit
    context, so after a wrap the FIFO reported full and dropped packets.
    Adds an FX3 slave FIFO behavioural model, an end-to-end testbench, and the
    GPIF II Designer procedure.
    [fx3_sfifo_model.v, gpif_sfifo_wr.v, tb_gpif.v, ts_pkt_fifo.v]
2026-11-01 Add FX3 firmware (protocol v1): USB/BOS/MS OS 2.0, I2C executor, iCE40 config, GPIF stream
    Written from scratch against the FX3 API guide. It builds with -Wall -Werror
    and has not run on hardware. The GPIF config comes from the SDK example
    (16-bit) until the GPIF II Designer output exists.
2026-11-01 fpga: SPI control registers, channel enable, packet counters (D-47)
    - spi_regs: oversampled SPI mode 3 slave on the configuration pins;
    {cmd, d3..d0}, cmd = addr / 0x80|addr. ID, VERSION, CH_ENABLE, STATUS,
    DROP_CNT[4], GPIO_OUT, SCRATCH, PKT_CNT[4].
    - otr_ts_core: ch_enable holds a disabled channel's receiver in reset;
    drop counters cross to the system clock as gray code; per-channel packet
    counters in the mux.
    - ts_serial_rx: track SYNC during reset so that a SYNC already high at
    release (8-bit style) is not taken as a packet start.
    - otr_top replaces syn/syn_top (power-on reset, TS reset synchronisers);
    syn/clocks.py constrains all clocks. 31% LCs, sys 84 MHz, TS 128-141 MHz.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
    [otr_fpga.c, otr_top.v, otr_ts_core.v, spi_regs.v, tb_gpif.v, tb_spi.v, tb_ts_core.v]
2026-11-01 fx3: GPIF II configuration from our GPIF II Designer project (D-48)
    - fx3/gpif: generated cyfxgpif2config.h (16-bit sync slave FIFO, FLAGA =
    thread 0 DMA ready) and the Designer project (.cyfx, projectfiles).
    The Cypress-written documentation folder and the build log are excluded.
    State machine identical to the SDK 16-bit example; only flag pins differ.
    - fw: include ../gpif directly; the SDK-example fallback is removed.
    - build.sh mounts the parent directory so that ../gpif is visible.
2026-11-01 Boot from SPI flash: W25Q32JV, FPGA autoload, flash unique ID serial (D-49)
    The release firmware is 114 KB and does not fit the 24LC256 (32 KB) of
    D-46. The user chose an SPI flash.
    - fx3/fw: otr_flash.c (read, page program, 4 KiB erase, status, unique
    ID). FLASH_WRITE/READ/ERASE/STATUS replace the EEPROM requests (0xB7..BA).
    FPGA SS_B moves to GPIO 50 (SSN = flash). At start-up the bitstream in
    the flash slot is read into the DMA buffer area and loaded without
    interruption. The USB serial comes from the flash unique ID. GET_INFO
    reports the FPGA source and the ID.
    - fpga: MISO driven only while selected (tri-state SB_IO); tb_spi checks
    high-Z while deselected.
    - docs: D-49, BOM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
    [otr_board.h, otr_flash.c, otr_fpga.c, otr_fw.h, otr_io.c, otr_main.c, otr_top.v, otr_usb.c]
2026-11-01 fpga: path reset for stream stop/start alignment (D-50)
    - CTRL 0x0A bit 0: hold the mux, wait until no packet is in flight, reset
    gpif_sfifo_wr; STATUS bit 1 = pending.
    - ts_mux discards packets of disabled channels (hold/idle ports).
    - fx3_sfifo_model: gpif_on (STREAM 0 drops the partial buffer) and commit.
    - tb_path: otr_top + FX3 model + SPI, four start/stop cycles, PASS with 0
    overruns; +no_path_reset fails (misaligned packets, 83 overruns).
    [fx3_sfifo_model.v, gpif_sfifo_wr.v, otr_top.v, otr_ts_core.v, spi_regs.v, tb_gpif.v, tb_path.v, tb_spi.v]
2026-11-01 docs: D-51..D-55 (layout by Claude with user checkpoints, 120 mm target, 4 layers, DNP trimmed, FPGA stock), BOM: flash C179173, FX3 crystal candidate
2026-11-01 hw: schematic generator (D-51), FX3 symbol from the ball map, FX3 sheet
    hw/gen: S-expression helper, schgen (hierarchical KiCad 10 schematic with
    global labels, netlist verification against the description, ERC),
    symbols (CYUSB3014-BZXI, 121 pins = footprint pads), design (FX3 sheet).
    [fx3.kicad_sch, otr-4ts3-u1.kicad_sch]
2026-11-01 hw: FPGA sheet and generated pin constraints; photo survey of related boards
    - design.py: iCE40 sheet (banks: GPIF 3.3 V, TS on selectable +VIO_TS,
    clocks on GBIN), one 50 MHz oscillator for FPGA and FX3 PCLK; writes
    fpga/syn/otr_top.pcf. Netlist matches the description.
    - otr_top: gpio_out narrowed to the 4 wired pins; PnR with the PCF passes
    (32% LCs, sys 88 MHz, TS 131-141 MHz); tb_path passes.
    - docs/reference/other-boards.md: DTV02A-4TS-P = PX-MLT5PE V1.0 board
    with channel 5 unpopulated; U13/U14 are empty footprints (QFN-32 /
    QFN-48 lands visible); research.md corrected; measurement items added.
    [fpga.kicad_sch, fx3.kicad_sch, otr-4ts3-u1.kicad_sch]
2026-11-01 hw: power, USB (Type-C + HD3SS3220, header option), control (TCA9546A), RF front-end sheets (D-56..D-60)
    Netlist == description, ERC 0 errors; 32 warnings are the receiver
    interface labels awaiting the receiver sheet. Project library tables are
    generated. F-jack footprint and HD3SS3220 symbol generated.
    [control.kicad_sch, fpga.kicad_sch, fx3.kicad_sch, otr-4ts3-u1.kicad_sch, power.kicad_sch, rf.kicad_sch, usb.kicad_sch]
2026-11-01 hw: board outline and provisional placement (checkpoint 1, D-61..D-64)
    - pcbgen.py builds the PCB from the description: PCIe CEM low-profile
    outline, footprints with nets taken from KiCad's netlist and symbol
    paths, so DRC schematic parity passes; parts packed per group around
    fixed FX3/FPGA/connectors (layout.py)
    - schematic UUIDs are now name-based: regeneration is byte-stable and the
    board stays linked to the schematic
    - bracket screw holes H1/H2 (M3, GND); receiver channels and the B-CAS
    card (solder side, DNP) reserved as drawings
    - docs: decisions D-61..D-64, layout-checkpoint-1.md, measurement
    items for the outline and bracket (2-5)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
    [control.kicad_sch, fpga.kicad_sch, fx3.kicad_sch, otr-4ts3-u1.kicad_pcb, otr-4ts3-u1.kicad_sch, power.kicad_sch, rf.kicad_sch, usb.kicad_sch]
2026-11-01 hw: fix F-jack orientation, simple 3D models for the bracket connectors
    - the DS803FPR0016 footprint had its mating axis reversed: the thread is on
    the side of the single body hole, the centre pin and legs are behind it
    (checked against LCSC's footprint C2979612 and the 24.0 mm overall
    length). Jacks now face the bracket at 0 deg, front hole 2.2 mm inside
    the card edge; body/collar/thread drawn on F.Fab, stable footprint UUIDs
    - models.py writes simplified VRML models (USB-C Molex 105450-0101, F jack)
    from the outline drawings; KiCad ships no model for either
    - layout-checkpoint-1.md updated
    [otr-4ts3-u1.kicad_pcb]
2026-11-01 hw: affinity placement (decoupling at the supply pins, parts at their pins)
    - pcbgen.py: parts are placed next to the pads they connect to, searching
    outwards for the nearest free spot in their zone; supply caps are spread
    over the IC's supply pins and turned so their supply pad faces the pin
    - FX3 rotated 90 deg (USB balls toward the USB-C, GPIF toward the FPGA);
    FPGA moved up 1 mm so X1 fits beside the clock pin (pin 49), with the
    33 ohm series resistors at its output (D-60)
    - internal-header-only parts (AC caps, VBUS link) next to J4
    - FPGA caps: mean 2.2 mm from their pin (bulk 5.7 mm); FX3: mean 3.9 mm
    [otr-4ts3-u1.kicad_pcb]
2026-11-01 hw: fix USB-C position (was 4.33 mm off the card), check pads lie on the card
    - J3's origin was put on the card edge, but the footprint's "PCB Edge"
    line is 4.33 mm in front of the origin: the connector stood out of the
    card and its front shield legs were off the board. The edge line now
    sits on the card edge (mating face 0.17 mm past it)
    - pcbgen.py fails when any plated pad lies outside the outline (KiCad's
    DRC does not flag pads entirely outside the board)
    - J3 reference on the fab layer (overlapped the AC-coupling caps)
    [otr-4ts3-u1.kicad_pcb]
2026-11-01 hw: bring-up test pads and I2C header (D-67); decisions D-65..D-68
    - test pads on the FX3-FPGA interface (PCLK, SLCS#, SLWR#, FLAGA, FLAGB,
    DQ0), FPGA CDONE/CRESET_B and two GND pads; I2C header J7 (DNP) on the
    FX3 side of the TCA9546A for chip-ID checks
    - design.build_sheets(): one sheet order for both generators; additions
    come last so existing reference designators do not move
    - D-65 no external RF output, D-66 shield as a GND rim only, D-68
    CLAUDE.md kept local (untracked)
    [control.kicad_sch, fpga.kicad_sch, otr-4ts3-u1.kicad_pcb]
2026-11-01 hw: net classes and JLC design rules (D-69); Sony IC sourcing survey
    - rules.py writes the net classes (USB 90 ohm pairs, RF 75 ohm, power,
    GPIF) and JLC minimums into the project, plus a .kicad_dru for limits
    KiCad's globals miss (pad hole to pad hole, BGA fan-out, pours away
    from RF lines). Widths from a 2D field solve of JLC04161H-7628
    - bracket connector references on the fab layer
    - docs/reference/sony-ic-sourcing.md: where CXD2856ER/CXD2858ER are
    offered, JLC consignment, harvesting from used boards, acceptance checks
    [otr-4ts3-u1.kicad_pcb]
2026-11-01 hw: USB-C -> HD3SS3220 -> FX3 critical routing (D-70)
    - usb.py places the USB chain by hand and routes the SuperSpeed lanes,
    host-side TX/RX and D+/D- as 90 ohm pairs; route.py has the copper helpers
    - receptacle row B goes down through small vias (0.3/0.15) in the 0.6 mm
    gap between the rows: the Molex footprint forbids copper in front of it
    - TX1 polarity swapped at the receptacle (USB 3 lane polarity inversion);
    header-option 0 ohm links share the fitted link's FX3-side pad (no stub)
    - RX1+ serpentine: intra-pair skew <= 0.1 mm except host RX (~1 mm total)
    - rules: via checks use the 'Hole' property (Hole_Size never matched vias);
    small vias only at the USB-C/switch, free-size via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
    [otr-4ts3-u1.kicad_pcb, usb.kicad_sch]
2026-11-01 hw: FX3 BGA fan-out, GND/supply planes, point-of-load LDOs (D-71)
    - fanout.py: dog-bone vias (0.45/0.25) for the FX3 ball field, planned
    and retried so every inner signal gets a via; +1V2 vias point into the
    island. Crystal: XTALOUT on the top layer only, XTALIN through two vias
    (Y1 fixed at 180 deg).
    - planes.py: In1 solid GND (cut out under the SuperSpeed AC caps), In2 GND
    with +3V3 area and +1V2 / +1V2_FPGA islands; plane vias beside pads,
    exposed-pad vias, GND return vias at SuperSpeed layer changes. Zones are
    filled by kicad-cli after the rules are written.
    - rules.py: 0.12 mm plane clearance under the BGA so the island keeps webs.
    - U5/U6 (1.2 V LDOs) and their caps move ne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
    [otr-4ts3-u1.kicad_pcb]
2026-11-02 hw: JLC fabrication outputs (fab.py); standard vias 0.45/0.3 (D-72)
    - fab.py writes Gerbers, Excellon, BOM and CPL for JLC to
    ~/otr-data/work/fab/<commit>; copper-only footprints stay out of the
    BOM/CPL; fitted parts without an LCSC number stop the script.
    - JLC's quote (2026-11-02) puts 0.25 mm holes in a paid class on 4-layer
    boards: the standard via is now 0.3 mm hole / 0.45 mm diameter, with
    a hole-size rule. Only the USB-C row vias stay 0.15 mm (D-70).
    - D-72 records the quote options and amounts.
    [otr-4ts3-u1.kicad_pcb]
2026-11-02 docs: JLC quote with assembly (2026-11-02); one BOM line per JLC part
2026-11-02 hw: hybrid USB-C (Same Sky UJ32-C-H-G-H2-SMT), no small vias (D-73)
    - symbols.py/models.py: footprint and simple model from the maker's
    layout for a 1.6 mm board (row A SMT at the rear, row B through-hole in
    two staggered sub-rows; paste on the THT pads for pin-in-paste).
    - usb.py: row-A pairs (TX1, RX2) on top, row-B pairs (RX1, TX2) straight
    from their holes on the bottom through the rear sub-row gaps, up next to
    the switch through free-size vias. TX2 swapped like TX1. D+/D- joined
    A6-B6 on top and A7-B7 on the bottom. Skew: TX2 0.11, RX1 0.25, D 0.07 mm.
    - rules.py: small vias disallowed; J3 row-B hole spacing and locating
    holes follow the maker's layout (checked with JLC at o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
    [otr-4ts3-u1.kicad_pcb, usb.kicad_sch]
2026-11-02 hw: general routing with Freerouting, session kept in the repo (D-74)
    autoroute.py exports the scripted board as DSN (existing copper fixed),
    adjusts it (outer layers only, planes and RF/USB not routed, 0.1 mm signal
    tracks that pass between the BGA fan-out vias, 0.55 mm router vias for
    0.2 mm hole clearance, receiver band and card edge kept out), runs
    Freerouting 2.5.0 headless and keeps the session; pcbgen.py adds only the
    session's new wiring. DRC: via_dangling and silk only.
    [otr-4ts3-u1.kicad_pcb]
2026-11-04 hw: 6 layers, scripted FX3 BGA escape, GPIF pins in escape order (D-75, D-76)
    - 6 layers on JLC06161H-7628: L1 signal / L2 GND / L3 signal /
    L4 supplies on GND / L5 GND / L6 signal. Same 0.2104 mm outer prepreg as
    the 4-layer stack, so the D-69 USB/RF geometry is unchanged.
    - escape.py: every FX3 signal ball leaves the package by script (grid
    shortest path, negotiated congestion across B.Cu and In2); 55/55 out.
    On 4 layers one track per via channel let only ~2 rings out.
    - FPGA bank-0 GPIF pins reassigned in the order the stubs leave the FX3,
    so the bus does not cross itself.
    - autoroute: In2 routable, via padstack name follows the layer count,
    USB-C oval hole keep-out on every r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
    [fpga.kicad_sch, otr-4ts3-u1.kicad_pcb]
2026-11-05 hw: finishing router for what Freerouting leaves open, plane pins joined (D-77)
    finish.py joins the open pieces of the routed nets on F/In2/B with vias
    (A* on the escape grid, net class clearances, rip-up and reroute), then,
    on the filled board, the plane pins that reach no plane and the +3V3
    islands. All signals connected; FB2.1 (+1V2) left open. DRC clean,
    output byte-stable.
    [otr-4ts3-u1.kicad_pcb]
2026-11-05 hw: faster finishing router grids (occ.py), pcbgen ~8 -> ~3.6 min
    The finishing router built a dict-of-sets grid (escape.Grid) per
    connection, testing every cell; occ.py keeps the same cells in an
    integer array and rasterises each shape a column at a time. The search
    loop reads the arrays directly. Same board file as before.
2026-11-05 hw: shared exact occupancy grid for escape and finishing, pcbgen ~3.6 -> ~2.5 min
    occ.py now reproduces escape.Grid's cells exactly (the column interval
    is trimmed with the same point test) and caches each shape's cells on the
    global 0.05 mm lattice, which every window starts on, so a track is
    worked out once and reused by every grid. escape.Grid is an Occ with the
    stub search; the board is read once per join (occ.Snap); the edge
    keep-outs once per board; the search loops are inlined; placement checks
    only the obstacles near the current ring. Same board file as before.
    [escape.py, finish.py, occ.py, pcbgen.py]
2026-11-05 hw: plane pins joined before routing, rule-breaking wiring rerouted, dead copper pruned; FB2 at its load (D-77)
    - FB2 is placed at the FX3 USB 3 PHY supply balls it feeds; its +1V2
    pin had no way into the plane east of the ball field. Spilled test
    pads search the neighbouring zone in 0.2 mm rings.
    - Plane pins without a via into their plane (no room beside the pad,
    or an FX3 supply ball whose fan-out via landed off its plane) are
    joined by the maze router before Freerouting, which then routes
    around them instead of boxing them in (U15.2, U1.J11).
    - Freerouting wiring that the DRC flags (it does not know the hole
    clearances) is taken up and joined again, until clean.
    - Copper lead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
    [otr-4ts3-u1.kicad_pcb]
2026-11-06 hw: RF front end in line with the signal, 75 ohm routes (D-78); finishing fixes
    - rf.py places the RF front end (ESD, DC blocks, the two SPDTs, LNA,
    bias choke, star splitter) in line from each F jack and draws the
    0.145 mm 75 ohm tracks and their GND vias by hand. Switch B faces
    switch A, so its LNA and bypass throws (and control pins) swap.
    - finish: a net walled in by this run's joins may rip them up once;
    dangling tracks are cut back along their own line, never to a point
    beside it; a no-op cut and zero-length tracks no longer loop prune()
    forever; single-layer vias are bridged and removed.
    - Plane rip-up retries with the nets that failed to rejoin kept in
    place (C27.1).
    N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
    [otr-4ts3-u1.kicad_pcb, rf.kicad_sch]
2026-11-06 hw: USB3 header pairs routed along the card's lower edge (D-79)
    - hdr.py routes the three 90 ohm pairs from the header-side 0 ohm links
    to J4 by hand: a bottom-layer band under the FX3 and the FPGA (DP/DM,
    SSTX, TX from the top), a 45 degree rise short of J7, one line through
    the middle of each 0.65 mm gap between J4's pins. DP/DM pass the USB-C
    and FX3 SuperSpeed pairs on In2. TX comes up for its coupling caps
    (turned FX3 side left). Intra-pair skew matched with bumps.
    - Return vias for the header's SuperSpeed layer changes, up to 2 mm out.
    - Plane vias and pre-routing joins keep 0.3 mm to the card edge.
    - Finishing: the plane rip-up no longer trips over the sink end point;
    last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
    [otr-4ts3-u1.kicad_pcb]
